RoboJackets/robowrestling/500g/NewMemberBoard/Renders/render_front.jpg

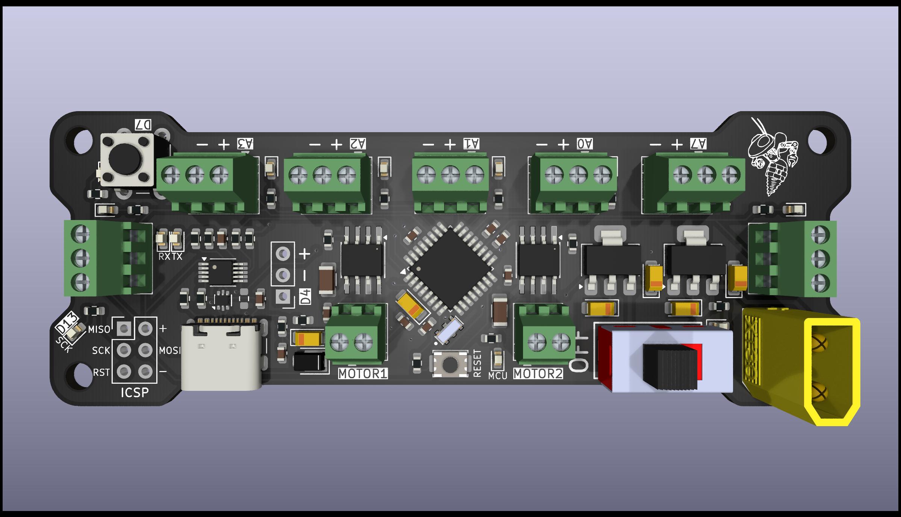
500g/NewMemberBoard/Renders/render_front.jpg
