RoboJackets/robowrestling/500g/NewMemberBoard/Renders/render_orthographic_back.jpg

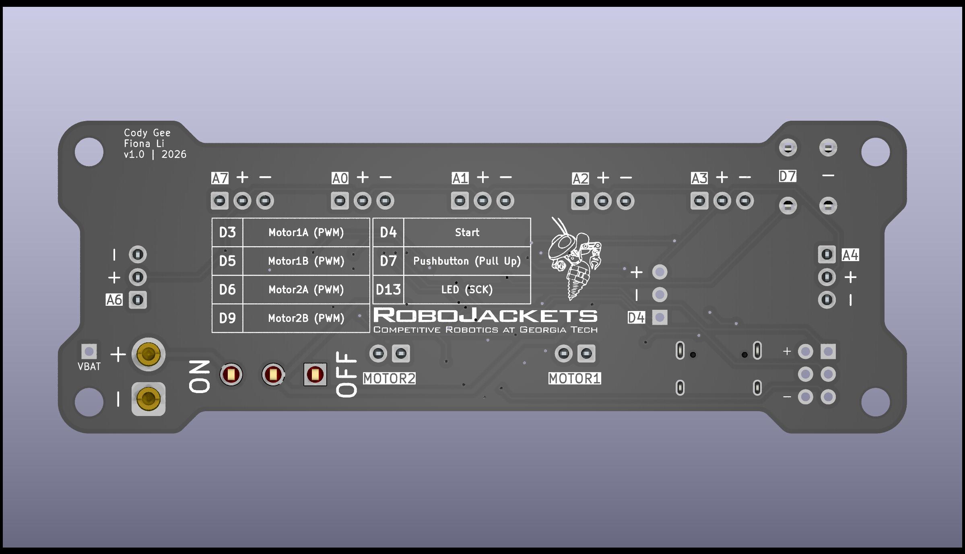
500g/NewMemberBoard/Renders/render_orthographic_back.jpg
