RoboJackets/robowrestling/500g/NewMemberBoard/Imported_Symbols_Footprints/xt30-male-connector-1.snapshot.5/XT30-M_m.ver.png

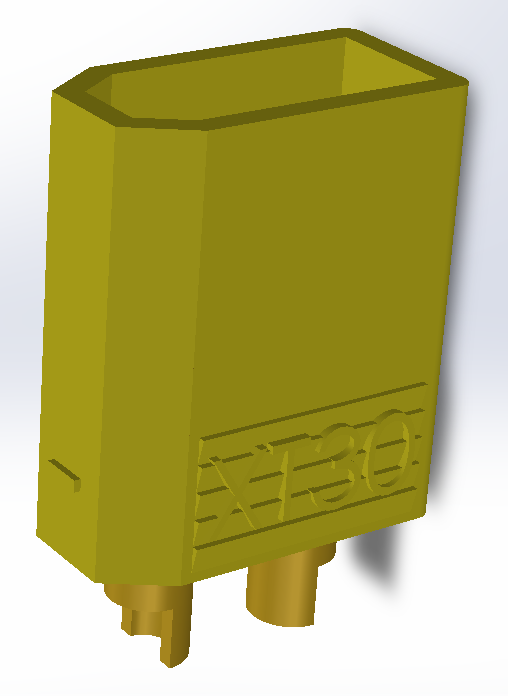
500g/NewMemberBoard/Imported_Symbols_Footprints/xt30-male-connector-1.snapshot.5/XT30-M_m.ver.png
