RoboJackets/robowrestling/500g/NewMemberBoard/Renders/render_orthographic_front.jpg

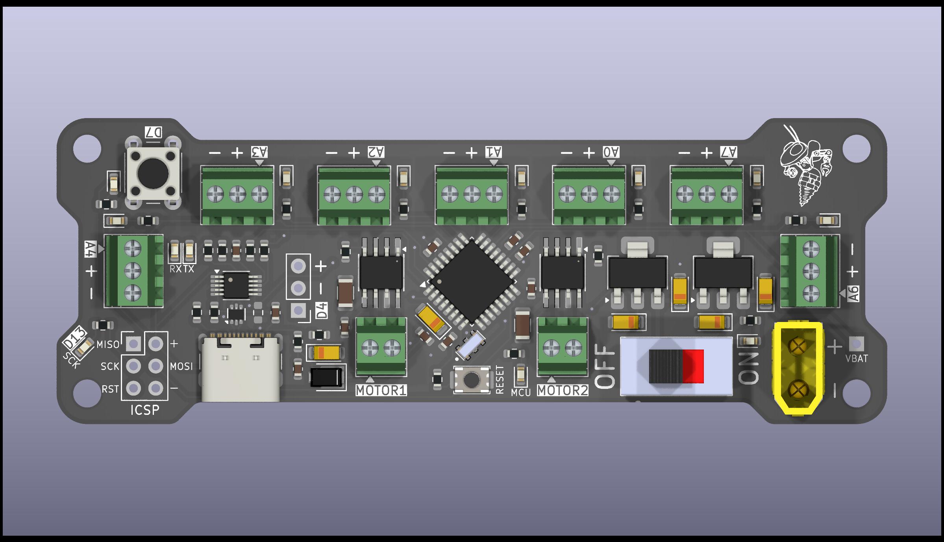
500g/NewMemberBoard/Renders/render_orthographic_front.jpg
