RoboJackets/robowrestling/3kg/Ferrarii/CustomML2/CustomML2.step

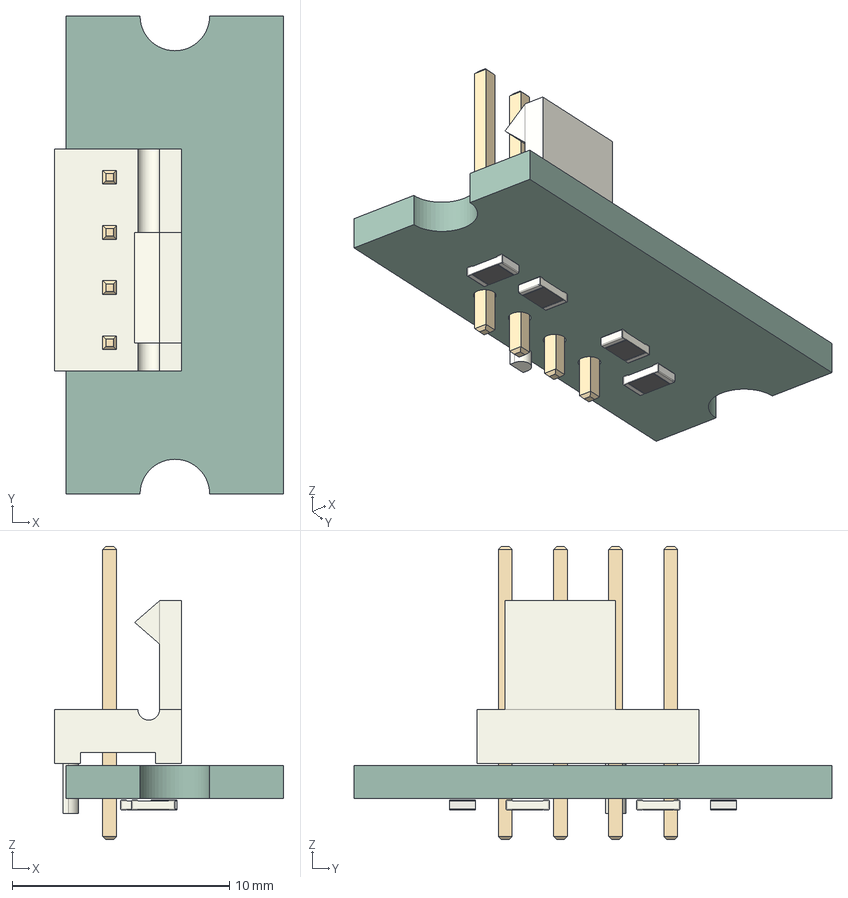
[picture p5: CAD file, 2025-07-22]
3kg/Ferrarii/CustomML2/CustomML2.step
10.5 x 22.0 x 13.5 mm
FanPinHeader_1x04_P2.54mm_Vertical
R_0805_2012Metric x 4
CustomML2_PCB
