RoboJackets/robowrestling/500g/NewMemberBoard/Imported_Symbols_Footprints/1101M2S3CQE2 (2)/1101M2S3CQE2.step

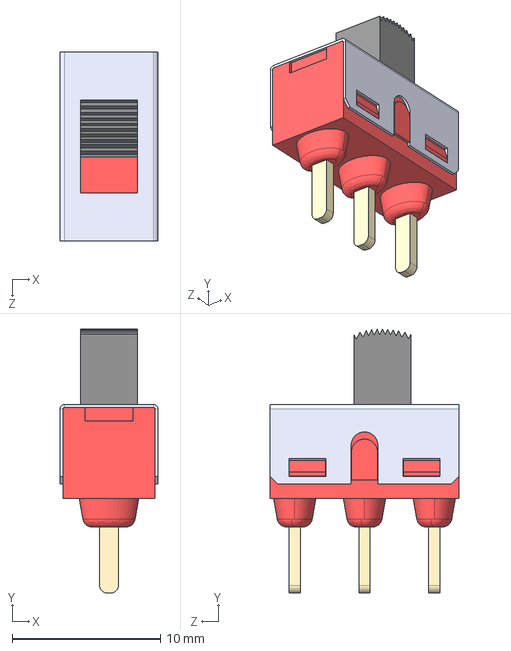
[picture p6: CAD file, 2025-10-02]
500g/NewMemberBoard/Imported_Symbols_Footprints/1101M2S3CQE2 (2)/1101M2S3CQE2.step
6.60 x 17.8 x 12.7 mm
