RoboJackets/robowrestling/500g/NewMemberBoard/Imported_Symbols_Footprints/CSTNE16M0V530000R0/CSTNE16M0V530000R0.step

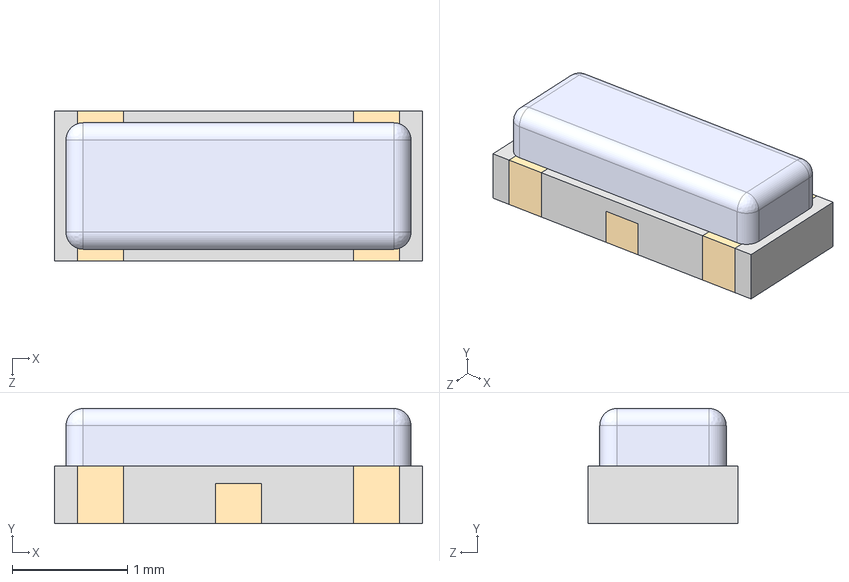
[picture p7: CAD file, 2026-07-23]
500g/NewMemberBoard/Imported_Symbols_Footprints/CSTNE16M0V530000R0/CSTNE16M0V530000R0.step
3.20 x 1.00 x 1.30 mm
