RoboJackets/robowrestling/500g/NewMemberBoard/Imported_Symbols_Footprints/LIB_SKRKAHE020/SKRKAHE020/3D/SKRKAHE020.stp

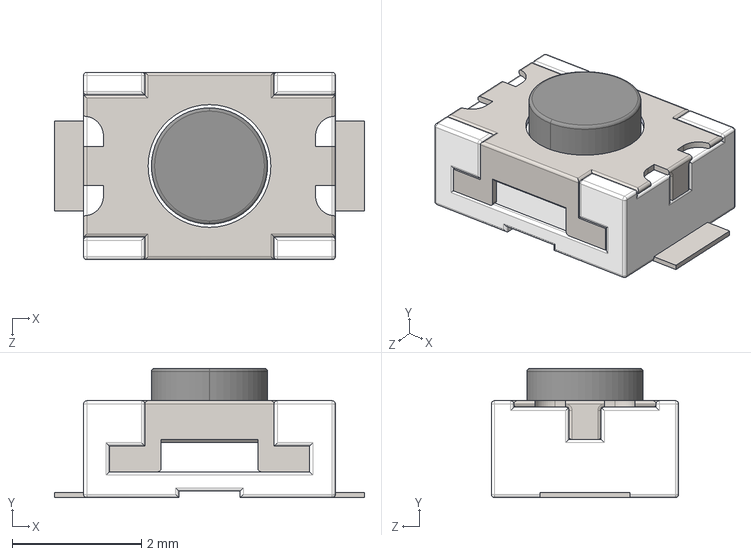
[picture p8: CAD file, 2026-07-23]
500g/NewMemberBoard/Imported_Symbols_Footprints/LIB_SKRKAHE020/SKRKAHE020/3D/SKRKAHE020.stp
4.80 x 2.00 x 2.90 mm
