RoboJackets/robowrestling/500g/NewMemberBoard/Imported_Symbols_Footprints/microstart-cad/microstart-cad.step

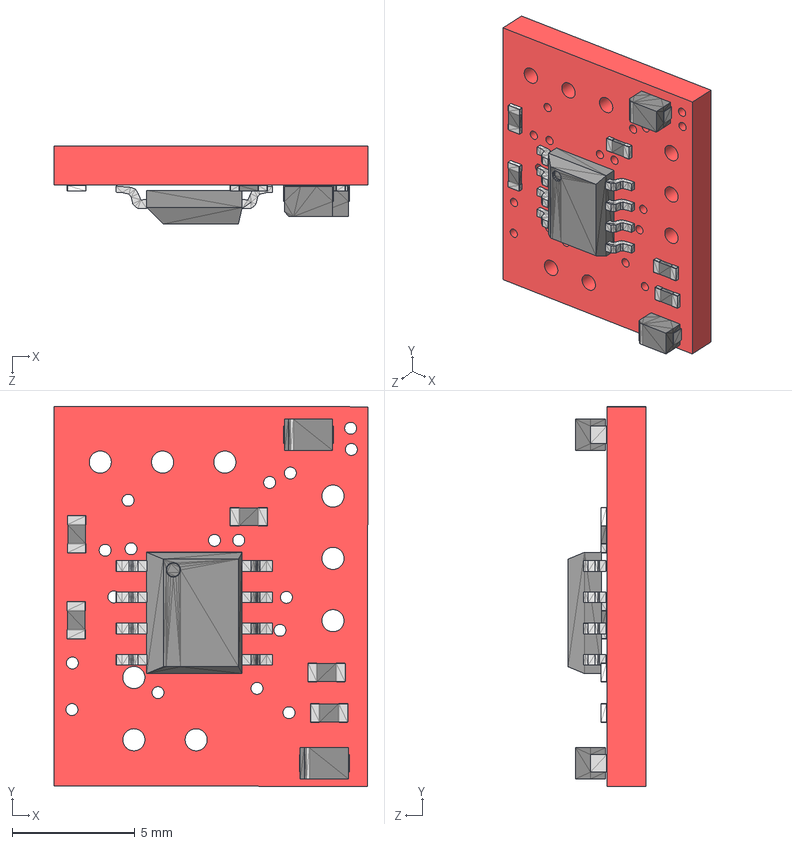
[picture p9: CAD file, 2026-07-23]
500g/NewMemberBoard/Imported_Symbols_Footprints/microstart-cad/microstart-cad.step
12.8 x 15.5 x 3.18 mm
Board
dio_0805 x 2
res_0603 x 5
soic-8_150mil
