RoboJackets/robowrestling/500g/NewMemberBoard/Imported_Symbols_Footprints/PTS_647_SK38/PTS 647 SK38 SMTR2 LFS--3DModel-STEP-269445.STEP

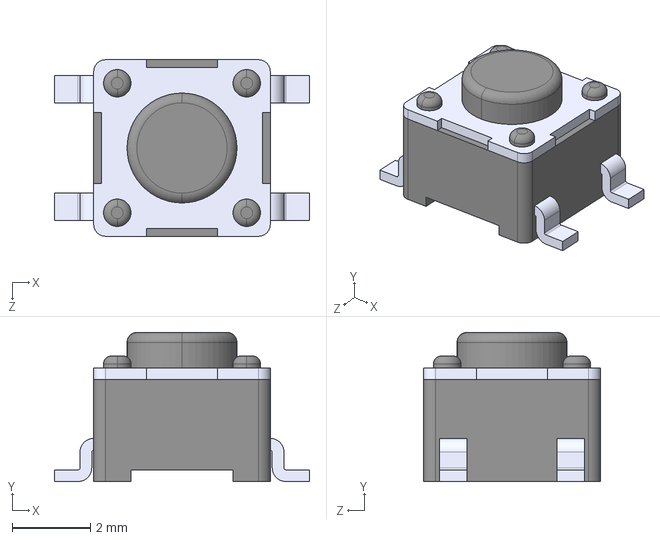
[picture p10: CAD file, 2026-07-23]
500g/NewMemberBoard/Imported_Symbols_Footprints/PTS_647_SK38/PTS 647 SK38 SMTR2 LFS--3DModel-STEP-269445.STEP
6.50 x 3.80 x 4.50 mm
