RoboJackets/robowrestling/500g/NewMemberBoard/Imported_Symbols_Footprints/xt30-male-connector-1.snapshot.5/XT30-M_m.ver.STEP

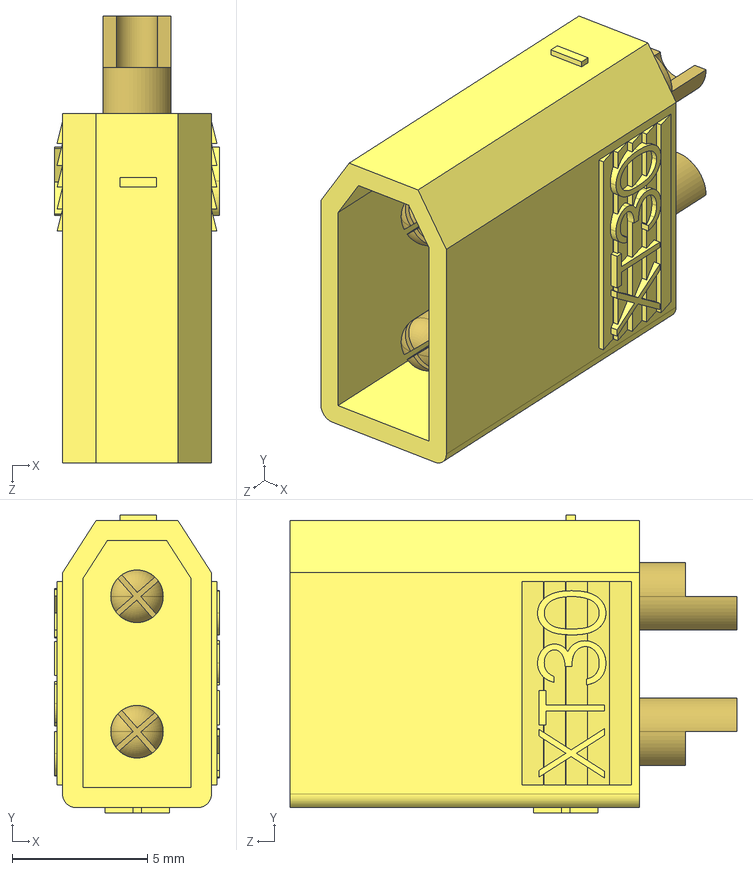
[picture p11: CAD file, 2026-07-23]
500g/NewMemberBoard/Imported_Symbols_Footprints/xt30-male-connector-1.snapshot.5/XT30-M_m.ver.STEP
6.10 x 11.0 x 16.5 mm
