RoboJackets/robowrestling/500g/Slippi/Symbols_Footprints/DRV8871DDAR/DRV8871DDAR.step

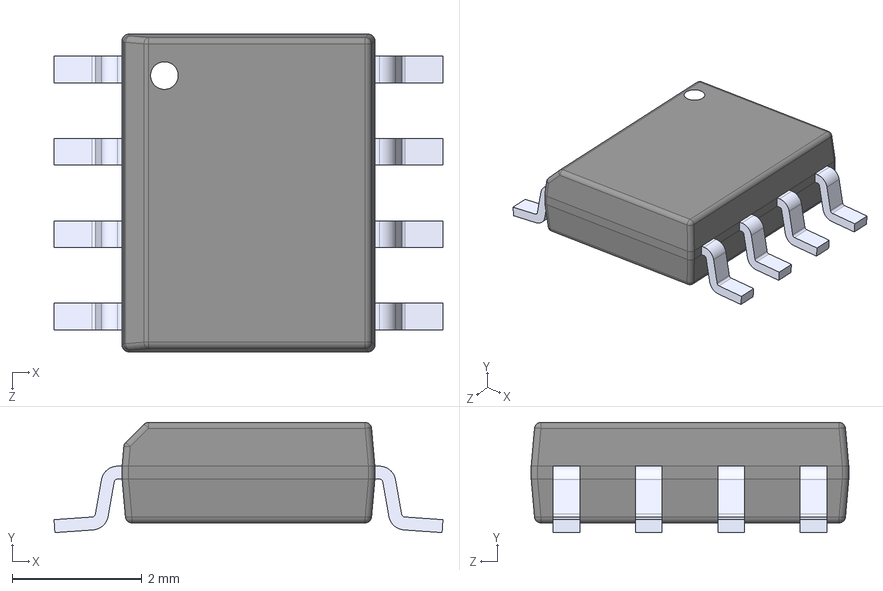
[picture p12: CAD file, 2025-10-02]
500g/Slippi/Symbols_Footprints/DRV8871DDAR/DRV8871DDAR.step
6.00 x 1.70 x 4.90 mm
