RoboJackets/robowrestling/500g/Slippi/Symbols_Footprints/L7805CV/L7805CV.step

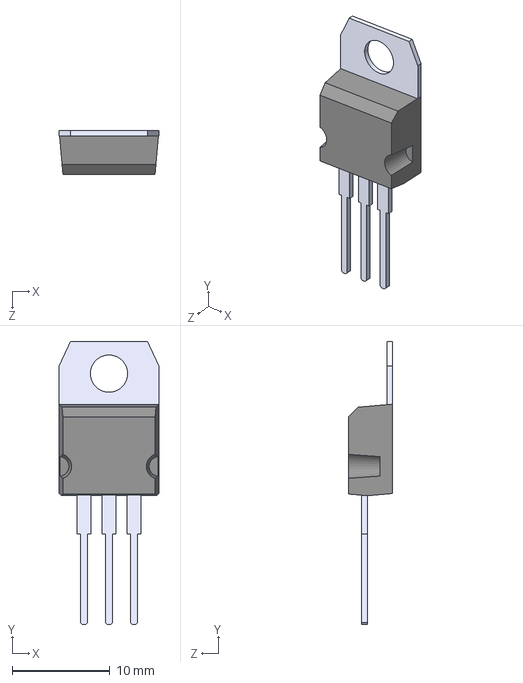
[picture p13: CAD file, 2025-10-02]
500g/Slippi/Symbols_Footprints/L7805CV/L7805CV.step
10.2 x 28.9 x 4.50 mm
