RoboJackets/robowrestling/ControlBoard/Timmi/0.1ufCap/CL05A104KA5NNNC.step

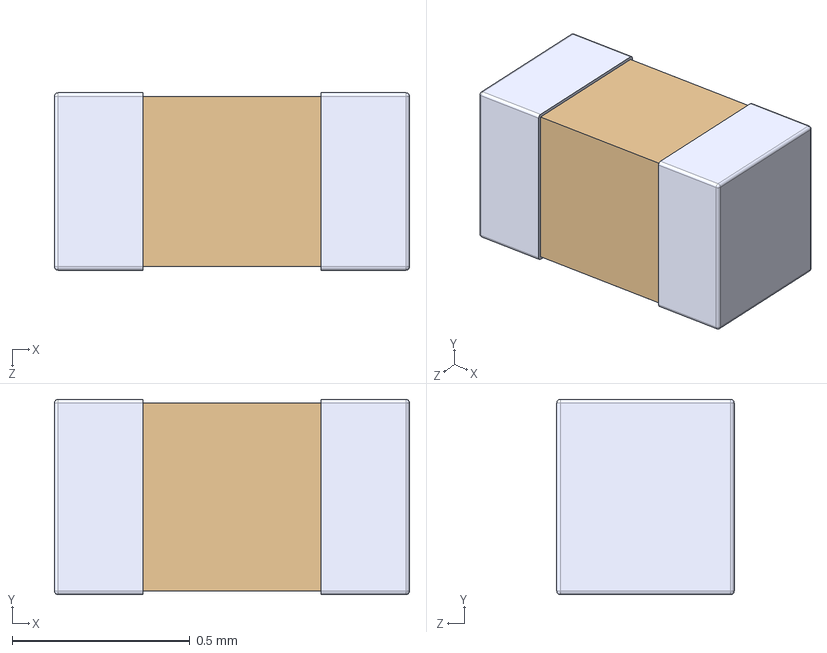
[picture p14: CAD file, 2024-02-18]
ControlBoard/Timmi/0.1ufCap/CL05A104KA5NNNC.step
1 x 0.55 x 0.5 mm
