RoboJackets/robowrestling/Skibidi/SkibidiCAD/Front Wedge.SLDPRT

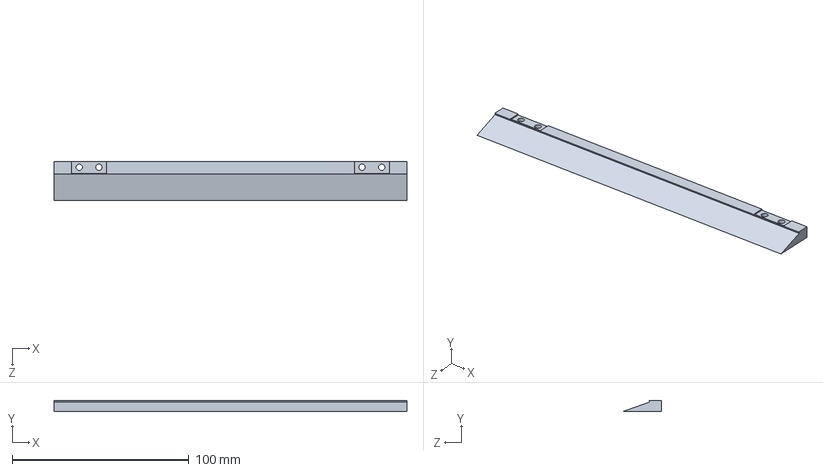
[picture p15: CAD file, 2024-06-07]
Skibidi/SkibidiCAD/Front Wedge.SLDPRT
200.0 x 6.35 x 21.9 mm
