RoboJackets/robowrestling/500g/NewMemberBoard/Imported_Symbols_Footprints/microstart-cad/microstart-cad-board-only.step

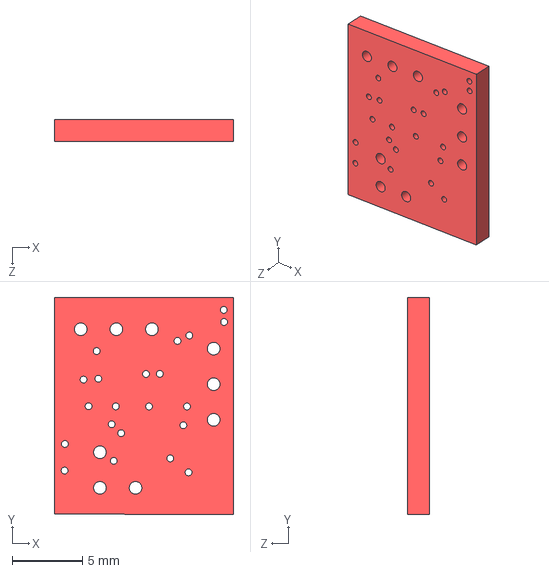
[picture p16: CAD file, 2026-07-23]
500g/NewMemberBoard/Imported_Symbols_Footprints/microstart-cad/microstart-cad-board-only.step
12.8 x 15.5 x 1.60 mm
