RoboJackets/robowrestling/Skibidi/SkibidiCAD/1603A2_Surface-Mount Hinge with Holes.SLDPRT

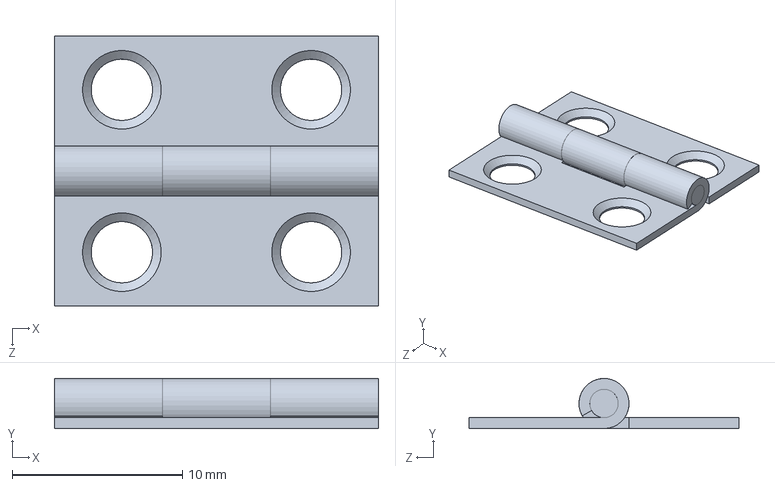
[picture p17: CAD file, 2024-06-07]
Skibidi/SkibidiCAD/1603A2_Surface-Mount Hinge with Holes.SLDPRT
19.1 x 2.95 x 15.9 mm
