RoboJackets/robowrestling/Skibidi/SkibidiCAD/Blade.SLDPRT

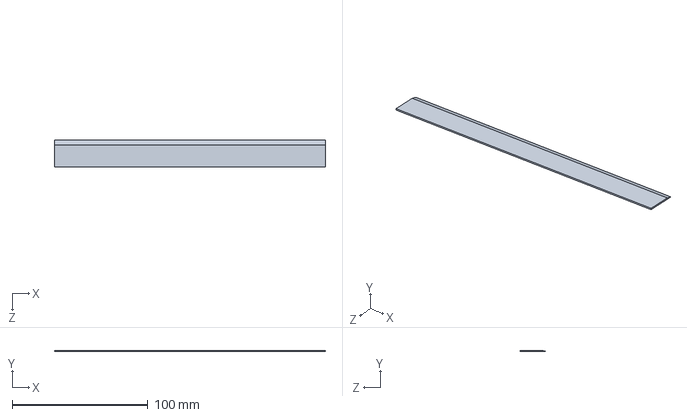
[picture p18: CAD file, 2024-06-07]
Skibidi/SkibidiCAD/Blade.SLDPRT
200.0 x 1.00 x 20.0 mm
