RoboJackets/robowrestling/Skibidi/SkibidiCAD/Base Plate.SLDPRT

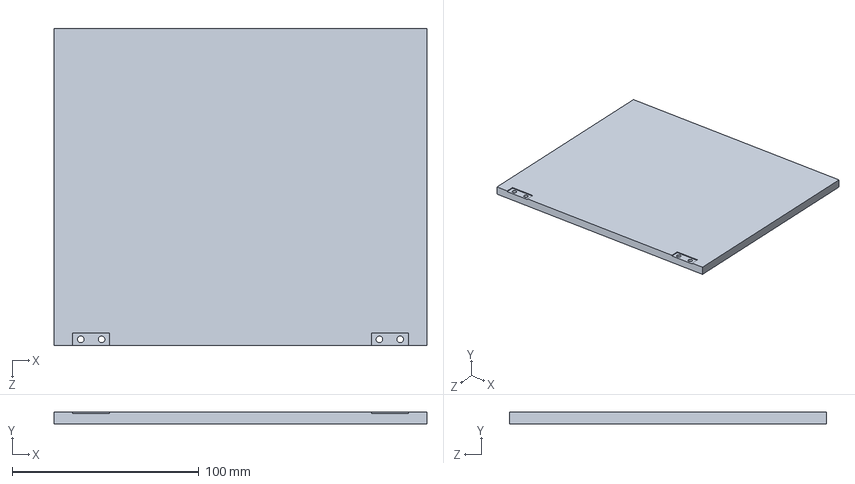
[picture p19: CAD file, 2024-06-07]
Skibidi/SkibidiCAD/Base Plate.SLDPRT
200.0 x 6.35 x 170.0 mm
