RoboJackets/robowrestling/500g/NewMemberBoard/Imported_Symbols_Footprints/691210910002/691210910002.step

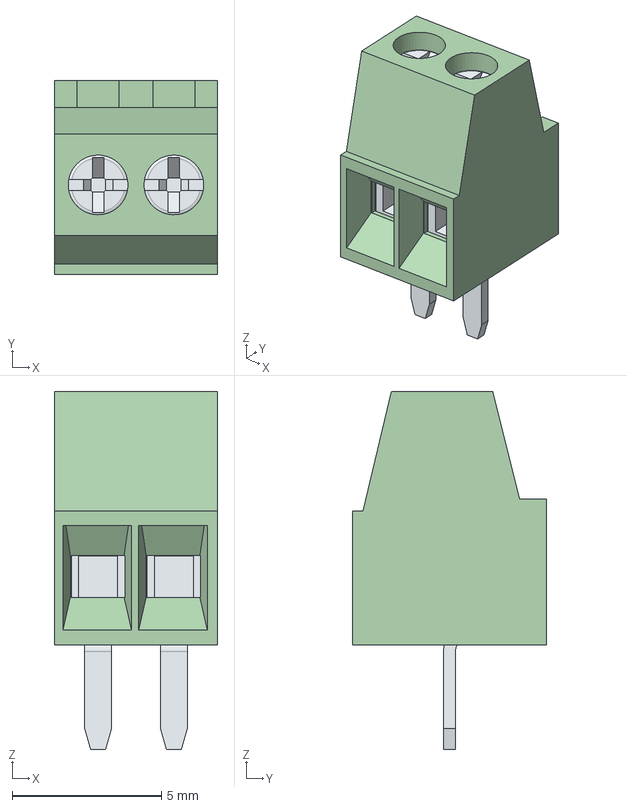
[picture p20: CAD file, 2026-07-23]
500g/NewMemberBoard/Imported_Symbols_Footprints/691210910002/691210910002.step
5.48 x 6.50 x 12.0 mm
6912109100xx_CAGE x 2
6912109100xx_PIN x 2
6912109100xx_VIS x 2
