RoboJackets/robowrestling/500g/NewMemberBoard/Imported_Symbols_Footprints/LIB_691210910003/691210910003/3D/691210910003.stp

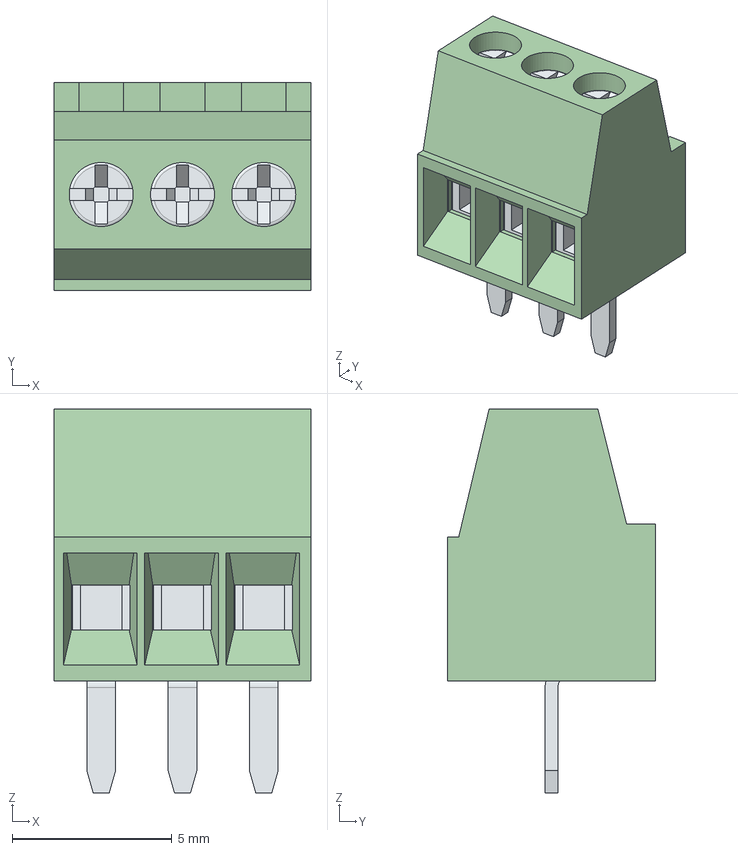
[picture p21: CAD file, 2026-07-23]
500g/NewMemberBoard/Imported_Symbols_Footprints/LIB_691210910003/691210910003/3D/691210910003.stp
8.02 x 6.50 x 12.0 mm
6912109100xx_CAGE x 3
6912109100xx_PIN x 3
6912109100xx_VIS x 3
