RoboJackets/robowrestling/Skibidi/SkibidiCAD/Skwibidi.SLDASM

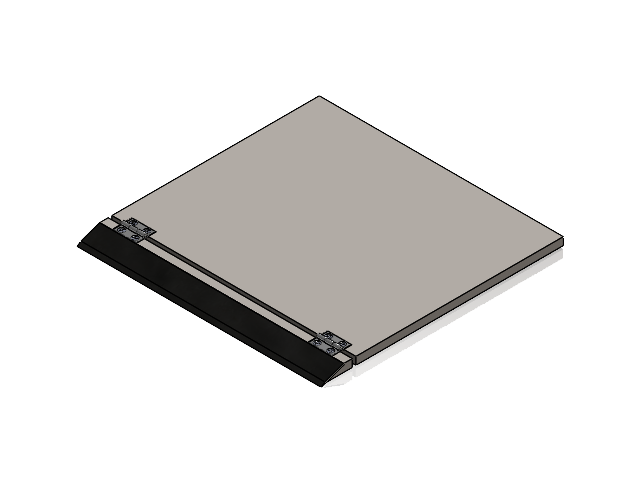
[picture p22: CAD file, 2024-06-07]
Skibidi/SkibidiCAD/Skwibidi.SLDASM
97258A122_18-8 Stainless Steel Thin Square Nut x 8
91420A016_Steel Phillips Flat Head Screws x 8
Base Plate
Front Wedge
1603A2_Surface-Mount Hinge with Holes x 2
Blade
