RoboJackets/robowrestling/(list of files, cad)

Other CAD files:
500g/NewMemberBoard/Imported_Symbols_Footprints/LIB_691210910003/691210910003/Allegro/691210910003.psm
500g/NewMemberBoard/Imported_Symbols_Footprints/LIB_691210910003/691210910003/DEHDL/691210910003/chips/chips.prt
500g/NewMemberBoard/Imported_Symbols_Footprints/LIB_SKRKAHE020/SKRKAHE020/Allegro/skrkaee020.psm
500g/NewMemberBoard/Imported_Symbols_Footprints/LIB_SKRKAHE020/SKRKAHE020/DEHDL/skrkahe020/chips/chips.prt
500g/NewMemberBoard/Imported_Symbols_Footprints/xt30-male-connector-1.snapshot.5/XT30-M_m.ver.SLDPRT
ControlBoard/Timmi/m8Conn footprint/T4040034041-000.step
ControlBoard/Timmi/sm symbol/75869-130LF.step
Skibidi/SkibidiCAD/91420A016_Steel Phillips Flat Head Screws.SLDPRT
Skibidi/SkibidiCAD/97258A122_18-8 Stainless Steel Thin Square Nut.SLDPRT
