RoboJackets/robowrestling/(threads)

Thread 2 (2019-12-08):

Make it easier to reset start module/teensy

JoshOldenburg, 2019-12-08:
Ideas:
- Add an XBee or similar for wireless debugging and estop
- Make the start module resettable by the teensy (i.e., make its power supply controllable)

Closed 2023-02-08.

Thread 3 (2019-12-15):

IMU address line and interrupt pin have no level shifting

JoshOldenburg, 2019-12-15:
Address line can be tied to ground. Interrupt pin should be shifted. Also, consider moving to a different IMU (one with an impact interrupt) or use a breakout board for the current one.

Closed 2023-02-08.

Thread 4 (2019-12-15):

Use hall effect current sensors

JoshOldenburg, 2019-12-15:
Use hall effect sensors or something entirely isolated as Guccii v2 and Kirbi v1 have issues with inductive spikes killing the current sense amplifiers.

JoshOldenburg, 2020-01-10:
Per the discussion in person, we may not need to bother with current sensing at all since matches end pretty much as soon as it stalls.

Closed 2023-02-08.

Thread 6 (2019-12-15):

Break out Teensy program mode button, if possible

JoshOldenburg, 2019-12-15:
Also, break out its reset line.

Thread 7 (2019-12-15):

Use proper power supply management for removing power supply conflicts

JoshOldenburg, 2019-12-15:
Currently the ESC power supplies are in parallel, as is the USB power supply, if present. These should be merged with an OR-ing controller or similar to keep the redundancy.

Thread 8 (2019-12-15):

Consider moving to the Teensy 3.5

JoshOldenburg, 2019-12-15:
That potentially allows us to skip some level shifting and avoid damages from voltage spikes.

Thread 11 (2019-12-19):

Japan Competition Notes 2019

renawrli, 2019-12-19:
STOP:
    - using IMU and encoders, matches are too straightforward and fast to for them to be useful

CONTINUE:
    - lmao

START:
    - read ALL the rules again each year :'(
    - smaller batteries - less capacity/fewer cells to save space and weight
    - be careful with sensor placement (orientation, size & shape of cutouts)

Possible changes:
    - go dumber on the code, logic can be even simplier
    - move side plates under the plow so opponents can ride further up the plow
    - more patient/'twichy' code, spinning to search is too risky
    - possibly close the angle to see opponents that are farther away without blind spots
    - current sensing may not be necessary - smoking robot usually ends the match
        - 40A fuse seems fine :P

Things to research:
    - calculate force needed to scoop up an opposing robot
        - is our magnet force too much? or more strategic magnet placement.
        - Guccii got scooped twice. Only once resulted in being pushed out
    - calculate/find optimal magnet placement (Juan/Logan)
    - calculate momentum transfer necessary to throw a robot off the field (Juan)
    - distance sensors: narrow w/ higher precision VS wider w/ less precision
    - make robot flush with ground using a piece of plastic(?)
    - sumozade's magnets touch the ground. weaker magnets (Juan)
    - wider angle distance sensors for the sides
    - use all digital sensors? just more of them?

Comments:
    - "code is acceptable, iterate based on sensor setup and stragety" - Logan
    - Guccii's plow is bad bc opponents can get caught on it - romania team
    - aren't our TOF on Guccii slow? - romania team

Misc:
    - no more 5 second delay
    - if plow chips, you get DQ'd for the match
    - invited to tournamet in Colombia in April 2020
    - got business card from Higher Institute of Technology in Egypt, give to Dr. C ?

What happened:
    - did not test that code produced expected behavior (5 second delay was present in the code but not in the rules)
    - both bots just got scooped by the opponent's plow
        - need to make the plow more flush with the ground
        - magnets on the plow, but w/o scrapping the field somehow
    - line sensor macros were okay for the orange/brown line
    - Kirbi scratched the field (protruding screw on magnet)
    - distance sensors were kind of narrow & blind spots at a distance, Guccii didn't see the opponent immeidately and
        we got pushed out while we searched

Closed 2023-02-08.

Thread 28 (2023-02-08):

Debug/Fix Kirbi v2 Control Board

alexxpeng, 2023-02-08:
Muxes are all shorted, see if board is salvageable

Closed 2023-12-14.

Thread 29 (2023-02-08):

Redesign Radio Board

alexxpeng, 2023-02-08:
Fix stuff (Rhea has list of stuff to fix)

Closed 2023-12-14.
