RoboJackets/robowrestling/(list of files, drawings)

Other design files:
500g/NewMemberBoard/Imported_Symbols_Footprints/LIB_691210910003/691210910003/Altium/691210910003.PcbLib
500g/NewMemberBoard/Imported_Symbols_Footprints/LIB_691210910003/691210910003/Altium/691210910003.SchLib
ControlBoard/Timmi/rj_loadswitch_sim.ms14
ControlBoard/Timmi/simulations/powerswitch.ms14
