RoboJackets/robowrestling/500g/NewMemberBoard/500gNewMemberBoard.kicad_pcb

## KiCad design 500g/NewMemberBoard/500gNewMemberBoard.kicad_pcb (2026-07-30)

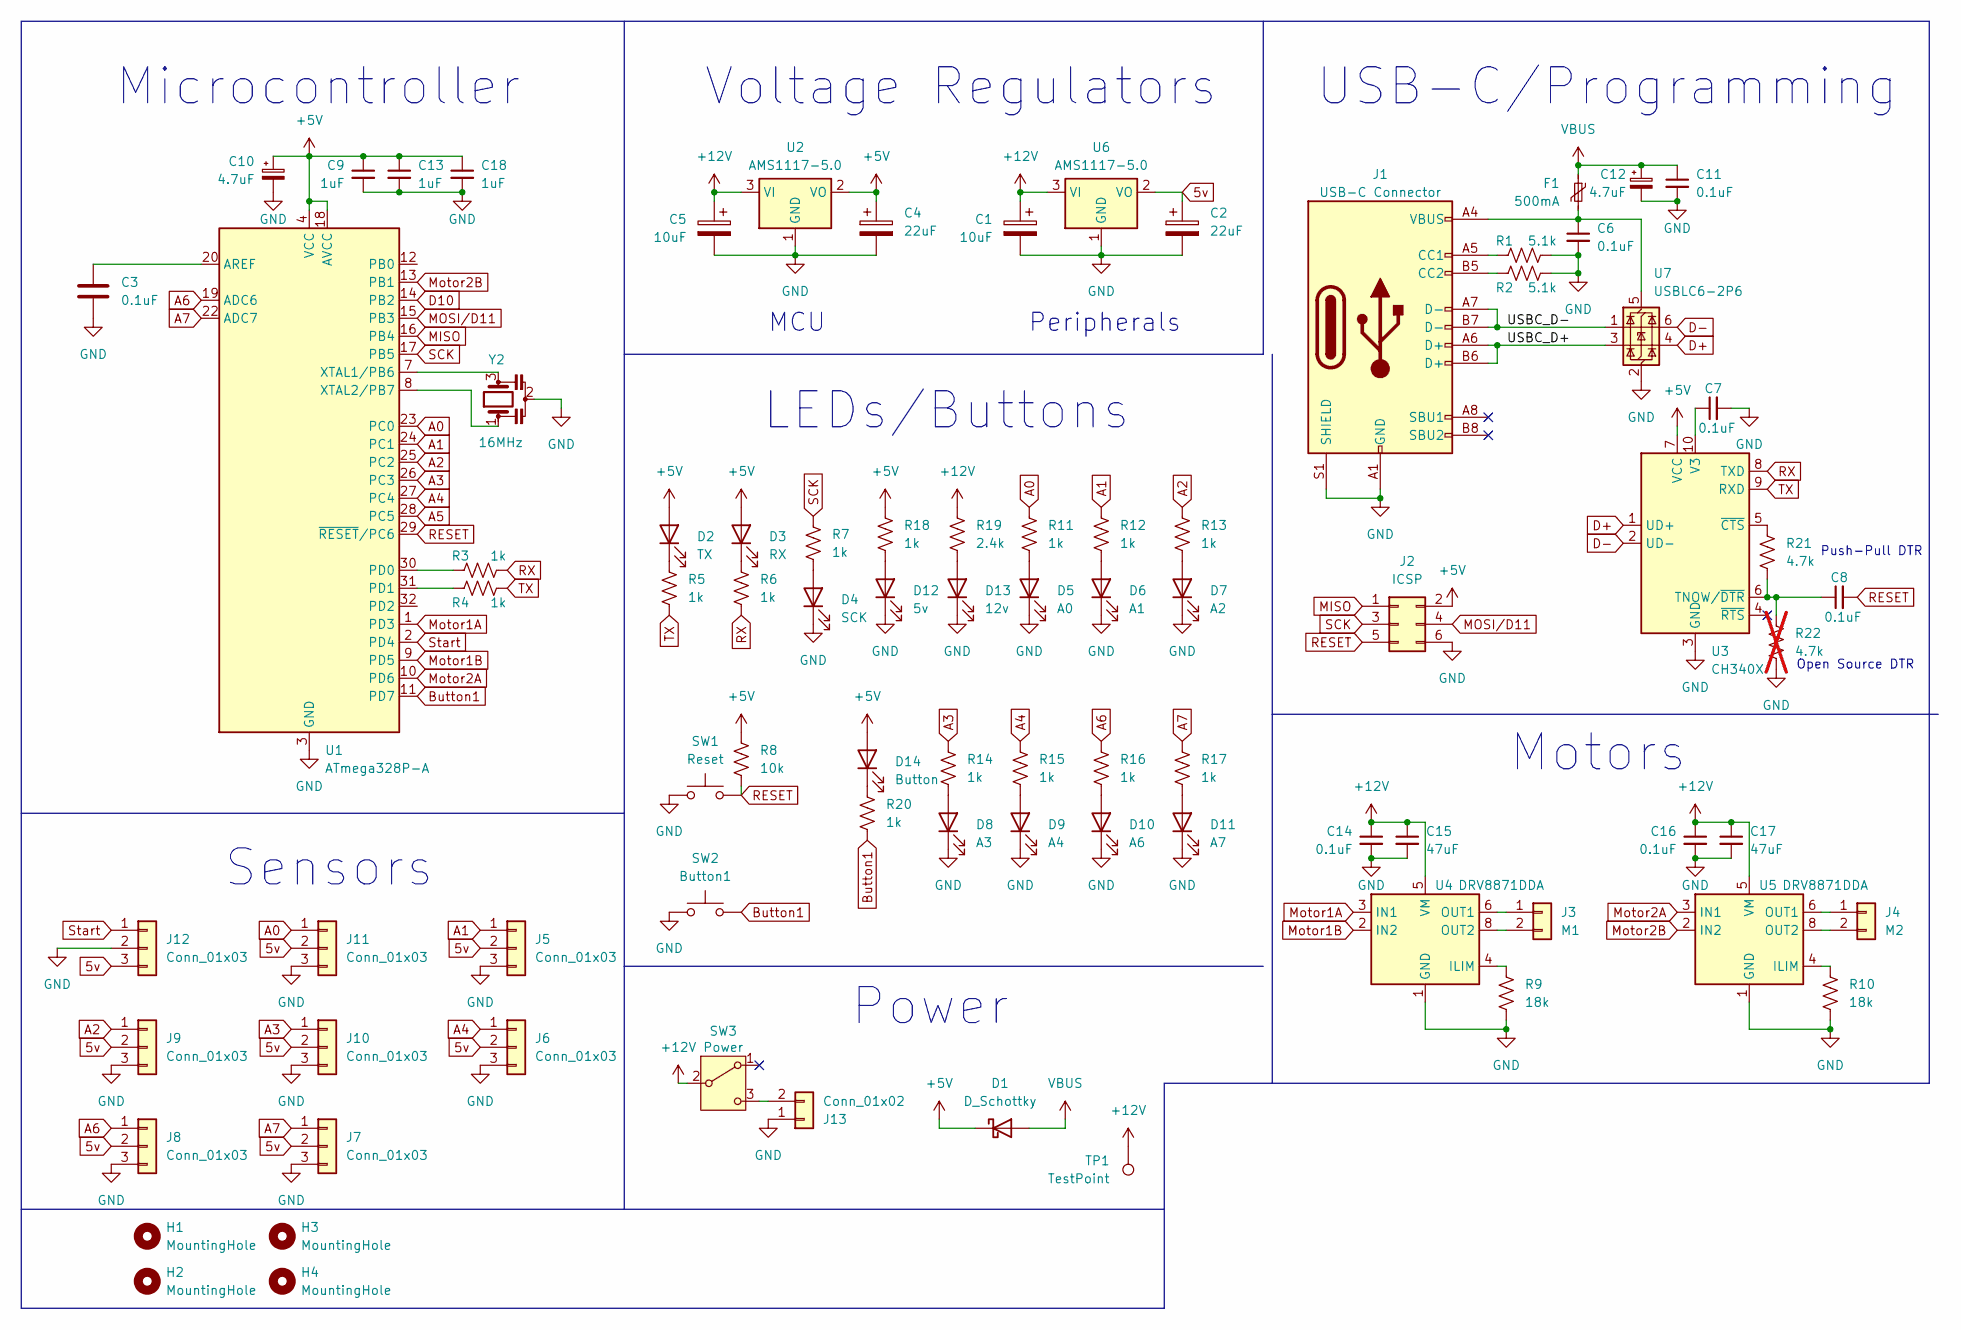
[picture p23: schematic 500gNewMemberBoard.kicad_sch]

Parts:
C1, C5: 10uF; CP_EIA-3216-18_Kemet-A
C2, C4: 22uF; CP_EIA-3216-18_Kemet-A
C3, C6, C7, C8, C11, C14, C16: 0.1uF; C_0603_1608Metric
C9, C13, C18: 1uF; C_0603_1608Metric
C10, C12: 4.7uF; CP_EIA-3216-18_Kemet-A
C15, C17: 47uF; C_1206_3216Metric
D1: D_Schottky; D_SMP_DO-220AA
D2: TX; LED_0603_1608Metric
D3: RX; LED_0603_1608Metric
D4: SCK; LED_0603_1608Metric
D5: A0; LED_0603_1608Metric
D6: A1; LED_0603_1608Metric
D7: A2; LED_0603_1608Metric
D8: A3; LED_0603_1608Metric
D9: A4; LED_0603_1608Metric
D10: A6; LED_0603_1608Metric
D11: A7; LED_0603_1608Metric
D12: 5v; LED_0603_1608Metric
D13: 12v; LED_0603_1608Metric
D14: Button; LED_0603_1608Metric
F1: 500mA; Fuse_0603_1608Metric
H1, H2, H3, H4: MountingHole; MountingHole_3.2mm_M3
J1: USB-C Connector; USB_C_Receptacle_GCT_USB4105-xx-A_16P_TopMnt_Horizontal
J2: ICSP; PinHeader_2x03_P2.54mm_Vertical
J3: M1; TerminalBlock_Xinya_XY308-2.54-2P_1x02_P2.54mm_Horizontal
J4: M2; TerminalBlock_Xinya_XY308-2.54-2P_1x02_P2.54mm_Horizontal
J5, J6, J7, J8, J9, J10, J11: Conn_01x03; TerminalBlock_Xinya_XY308-2.54-3P_1x03_P2.54mm_Horizontal
J12: Conn_01x03; PinHeader_1x03_P2.54mm_Vertical
J13: Conn_01x02; AMASS_XT30U-M_1x02_P5.0mm_Vertical
R1, R2: 5.1k; R_0603_1608Metric
R3, R4, R5, R6, R7, R11, R12, R13, R14, R15, R16, R17, R18, R20: 1k; R_0603_1608Metric
R8: 10k; R_0603_1608Metric
R9, R10: 18k; R_0603_1608Metric
R19: 2.4k; R_0603_1608Metric
R21: 4.7k; R_0603_1608Metric
R22: 4.7k; R_0603_1608Metric; not fitted
SW1: Reset; SW_Push_SPST_NO_Alps_SKRK
SW2: Button1; SW_PUSH_6mm
SW3: Power; SW_1101M2S3CQE2
TP1: TestPoint; 0.5mm_drill_0.85_0.85mm_test_point
U1: ATmega328P-A; TQFP-32_7x7mm_P0.8mm
U2, U6: AMS1117-5.0; SOT-223-3_TabPin2
U3: CH340X; MSOP-10_3x3mm_P0.5mm
U4, U5: DRV8871DDA; Texas_HTSOP-8-1EP_3.9x4.9mm_P1.27mm_EP2.95x4.9mm_Mask2.4x3.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
U7: USBLC6-2P6; SOT-666
Y2: 16MHz; OSC_CSTNE16M0V530000R0

Connections:
5v: C2.1, J5.2, J6.2, J7.2, J8.2, J9.2, J10.2, J11.2, J12.3, U6.2 (VO)
+5V: C4.1, C9.1, C10.1, C13.1, C18.1, D1.1 (K), D2.2 (A), D3.2 (A), D14.2 (A), J2.2, R8.1, R18.1, U1.4 (VCC), U1.6 (VCC), U1.18 (AVCC), U2.2 (VO), U3.7 (VCC)
+12V: C1.1, C5.1, C14.1, C15.1, C16.1, C17.1, R19.1, SW3.2 (B), TP1.1, U2.3 (VI), U4.5 (VM), U5.5 (VM), U6.3 (VI)
/USBC_D+: J1.A6 (D+), J1.B6 (D+), U7.3 (I/O2)
/USBC_D-: J1.A7 (D-), J1.B7 (D-), U7.1 (I/O1)
A0: J11.1, R11.1, U1.23 (PC0)
A1: J5.1, R12.1, U1.24 (PC1)
A2: J9.1, R13.1, U1.25 (PC2)
A3: J10.1, R14.1, U1.26 (PC3)
A4: J6.1, R15.1, U1.27 (PC4)
A5: U1.28 (PC5)
A6: J8.1, R16.1, U1.19 (ADC6)
A7: J7.1, R17.1, U1.22 (ADC7)
Button1: R20.2, SW2.2, U1.11 (PD7)
D10: U1.14 (PB2)
D+: U3.1 (UD+), U7.4 (I/O2)
D-: U3.2 (UD-), U7.6 (I/O1)
GND: C1.2, C2.2, C3.2, C4.2, C5.2, C6.2, C7.2, C9.2, C10.2, C11.2, C12.2, C13.2, C14.2, C15.2, C16.2, C17.2, C18.2, D4.1 (K), D5.1 (K), D6.1 (K), D7.1 (K), D8.1 (K), D9.1 (K), D10.1 (K), D11.1 (K), D12.1 (K), D13.1 (K), J1.A1 (GND), J1.A12 (GND), J1.B1 (GND), J1.B12 (GND), J1.S1 (SHIELD), J2.6, J5.3, J6.3, J7.3, J8.3, J9.3, J10.3, J11.3, J12.2, J13.1, R1.2, R2.2, R9.2, R10.2, R22.2, SW1.1, SW2.1, U1.3 (GND), U1.5 (GND), U1.21 (GND), U2.1 (GND), U3.3 (GND), U4.1 (GND), U4.7 (GND), U4.9 (GND), U5.1 (GND), U5.7 (GND), U5.9 (GND), U6.1 (GND), U7.2 (GND), Y2.2
MISO: J2.1, U1.16 (PB4)
MOSI/D11: J2.4, U1.15 (PB3)
Motor1A: U1.1 (PD3), U4.3 (IN1)
Motor1B: U1.9 (PD5), U4.2 (IN2)
Motor2A: U1.10 (PD6), U5.3 (IN1)
Motor2B: U1.13 (PB1), U5.2 (IN2)
unnamed: D2.1 (K), R5.1
unnamed: D3.1 (K), R6.1
unnamed: D4.2 (A), R7.2
unnamed: D5.2 (A), R11.2
unnamed: D6.2 (A), R12.2
unnamed: D7.2 (A), R13.2
unnamed: D8.2 (A), R14.2
unnamed: D9.2 (A), R15.2
unnamed: D10.2 (A), R16.2
unnamed: D11.2 (A), R17.2
unnamed: D12.2 (A), R18.2
unnamed: D13.2 (A), R19.2
unnamed: D14.1 (K), R20.1
unnamed: J1.A5 (CC1), R1.1
unnamed: J1.B5 (CC2), R2.1
unnamed: J3.1, U4.6 (OUT1)
unnamed: J3.2, U4.8 (OUT2)
unnamed: J4.1, U5.6 (OUT1)
unnamed: J4.2, U5.8 (OUT2)
unnamed: J13.2, SW3.3 (C)
unnamed: C3.1, U1.20 (AREF)
unnamed: R3.1, U1.30 (PD0)
unnamed: R4.1, U1.31 (PD1)
unnamed: U1.7 (XTAL1/PB6), Y2.3
unnamed: U1.8 (XTAL2/PB7), Y2.1
unnamed: C8.1, R21.2, R22.1, U3.6 (TNOW/~DTR)
unnamed: C7.1, U3.10 (V3)
unnamed: R21.1, U3.5 (~CTS)
unnamed: R9.1, U4.4 (ILIM)
unnamed: R10.1, U5.4 (ILIM)
unnamed: C6.1, F1.2, J1.A4 (VBUS), J1.A9 (VBUS), J1.B4 (VBUS), J1.B9 (VBUS), U7.5 (VBUS)
RESET: C8.2, J2.5, R8.2, SW1.2, U1.29 (~RESET/PC6)
RX: R3.2, R6.2, U3.8 (TXD)
SCK: J2.3, R7.1, U1.17 (PB5)
Start: J12.1, U1.2 (PD4)
TX: R4.2, R5.2, U3.9 (RXD)
VBUS: C11.1, C12.1, D1.2 (A), F1.1

Notes on the sheet:
Peripherals
Sensors
Power
Open Source DTR
Voltage Regulators
USB-C/Programming
Motors
Push-Pull DTR
LEDs/Buttons
Microcontroller
MCU

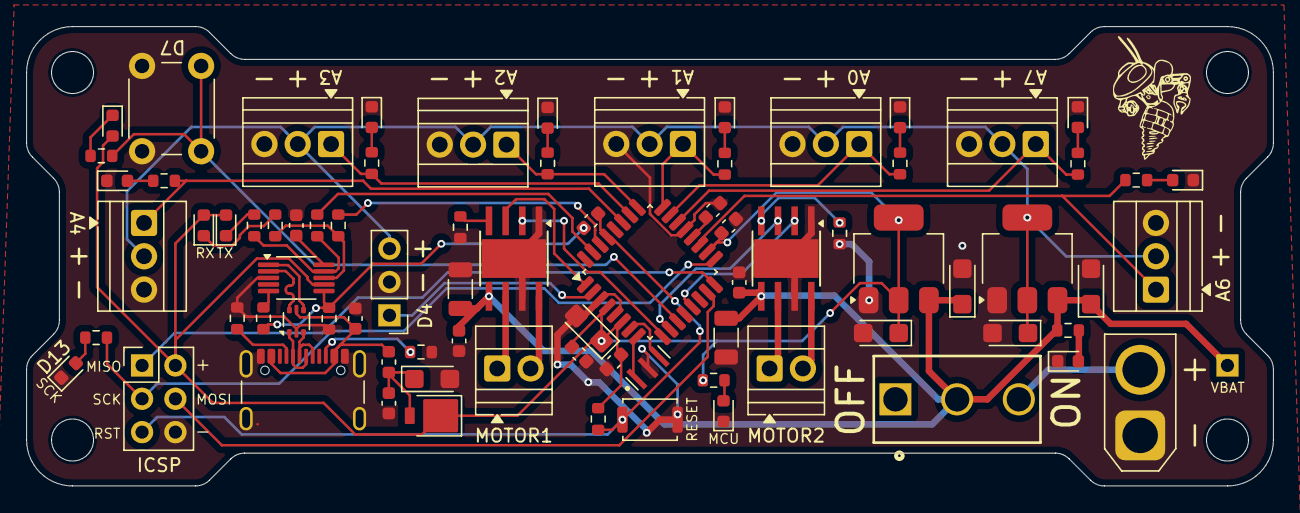
[picture p24: board 500gNewMemberBoard.kicad_pcb from above]

Board: 2 copper layers, 95.0 x 35.0 mm, 84 parts (0 on the bottom side), 59 nets.
