RoboJackets/robowrestling/500g/Slippi/Slippi.kicad_pcb

## KiCad design 500g/Slippi/Slippi.kicad_pcb (2025-10-02)

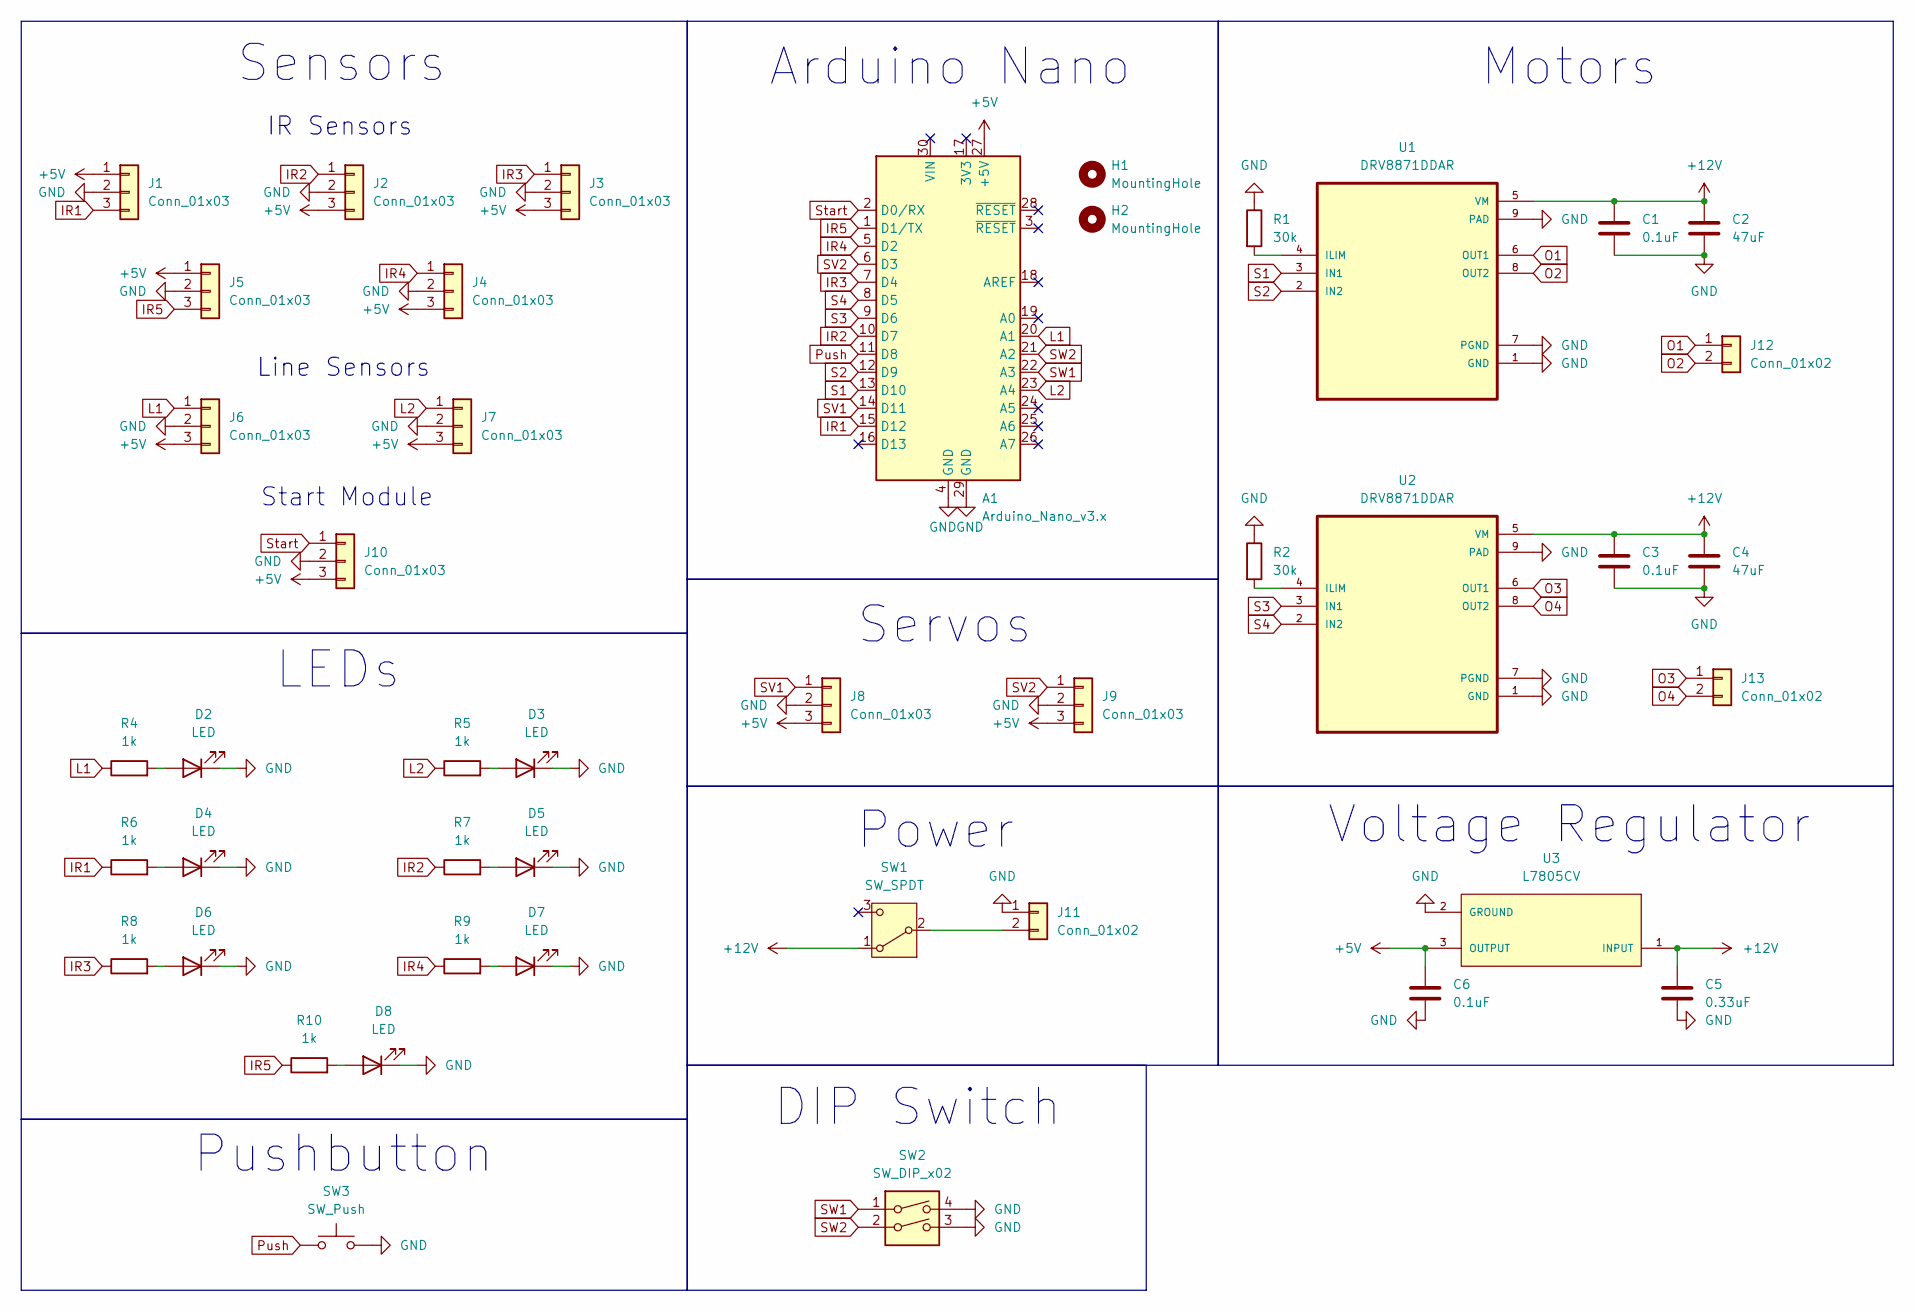
[picture p27: schematic Slippi.kicad_sch]

Parts:
A1: Arduino_Nano_v3.x; Arduino_Nano
C1, C3, C6: 0.1uF; C_0603_1608Metric
C2, C4: 47uF; C_0603_1608Metric
C5: 0.33uF; C_0603_1608Metric
D2, D3, D4, D5, D6, D7, D8: LED; LED_0603_1608Metric
H1, H2: MountingHole; MountingHole_2.7mm_M2.5
J1, J2, J3, J4, J5, J6, J7, J8, J9: Conn_01x03; TerminalBlock_Xinya_XY308-2.54-3P_1x03_P2.54mm_Horizontal
J10: Conn_01x03; PinHeader_1x03_P2.54mm_Vertical
J11: Conn_01x02; AMASS_XT30UPB-M_1x02_P5.0mm_Vertical
J12, J13: Conn_01x02; TerminalBlock_Xinya_XY308-2.54-2P_1x02_P2.54mm_Horizontal
R1, R2: 30k; R_0603_1608Metric
R4, R5, R6, R7, R8, R9, R10: 1k; R_0603_1608Metric
SW1: SW_SPDT; SW_1101M2S3CQE2
SW2: SW_DIP_x02; SW_DIP_SPSTx02_Slide_9.78x7.26mm_W7.62mm_P2.54mm
SW3: SW_Push; SW_PUSH_6mm
U1, U2: DRV8871DDAR; DRV8871
U3: L7805CV; TO255P1040X460X1968-3; PARTREV 36

Connections:
+5V: A1.27 (+5V), C6.1, J1.1, J2.3, J3.3, J4.3, J5.1, J6.3, J7.3, J8.3, J9.3, J10.3, U3.3 (OUTPUT)
+12V: C1.1, C2.1, C3.1, C4.1, C5.1, SW1.1 (A), U1.5 (VM), U2.5 (VM), U3.1 (INPUT)
GND: A1.4 (GND), A1.29 (GND), C1.2, C2.2, C3.2, C4.2, C5.2, C6.2, D2.1 (K), D3.1 (K), D4.1 (K), D5.1 (K), D6.1 (K), D7.1 (K), D8.1 (K), J1.2, J2.2, J3.2, J4.2, J5.2, J6.2, J7.2, J8.2, J9.2, J10.2, J11.1, R1.1, R2.1, SW2.3, SW2.4, SW3.2, U1.1 (GND), U1.7 (PGND), U1.9 (PAD), U2.1 (GND), U2.7 (PGND), U2.9 (PAD), U3.2 (GROUND)
IR1: A1.15 (D12), J1.3, R6.1
IR2: A1.10 (D7), J2.1, R7.1
IR3: A1.7 (D4), J3.1, R8.1
IR4: A1.5 (D2), J4.1, R9.1
IR5: A1.1 (D1/TX), J5.3, R10.1
L1: A1.20 (A1), J6.1, R4.1
L2: A1.23 (A4), J7.1, R5.1
unnamed: D2.2 (A), R4.2
unnamed: D3.2 (A), R5.2
unnamed: D4.2 (A), R6.2
unnamed: D5.2 (A), R7.2
unnamed: D6.2 (A), R8.2
unnamed: D7.2 (A), R9.2
unnamed: D8.2 (A), R10.2
unnamed: J11.2, SW1.2 (B)
unnamed: R1.2, U1.4 (ILIM)
unnamed: R2.2, U2.4 (ILIM)
O1: J12.1, U1.6 (OUT1)
O2: J12.2, U1.8 (OUT2)
O3: J13.1, U2.6 (OUT1)
O4: J13.2, U2.8 (OUT2)
Push: A1.11 (D8), SW3.1
S1: A1.13 (D10), U1.3 (IN1)
S2: A1.12 (D9), U1.2 (IN2)
S3: A1.9 (D6), U2.3 (IN1)
S4: A1.8 (D5), U2.2 (IN2)
SV1: A1.14 (D11), J8.1
SV2: A1.6 (D3), J9.1
SW1: A1.22 (A3), SW2.1
SW2: A1.21 (A2), SW2.2
Start: A1.2 (D0/RX), J10.1

Notes on the sheet:
Pushbutton
Power
Line Sensors
Arduino Nano
Servos
Motors
Sensors
IR Sensors
Voltage Regulator
DIP Switch
Start Module
LEDs

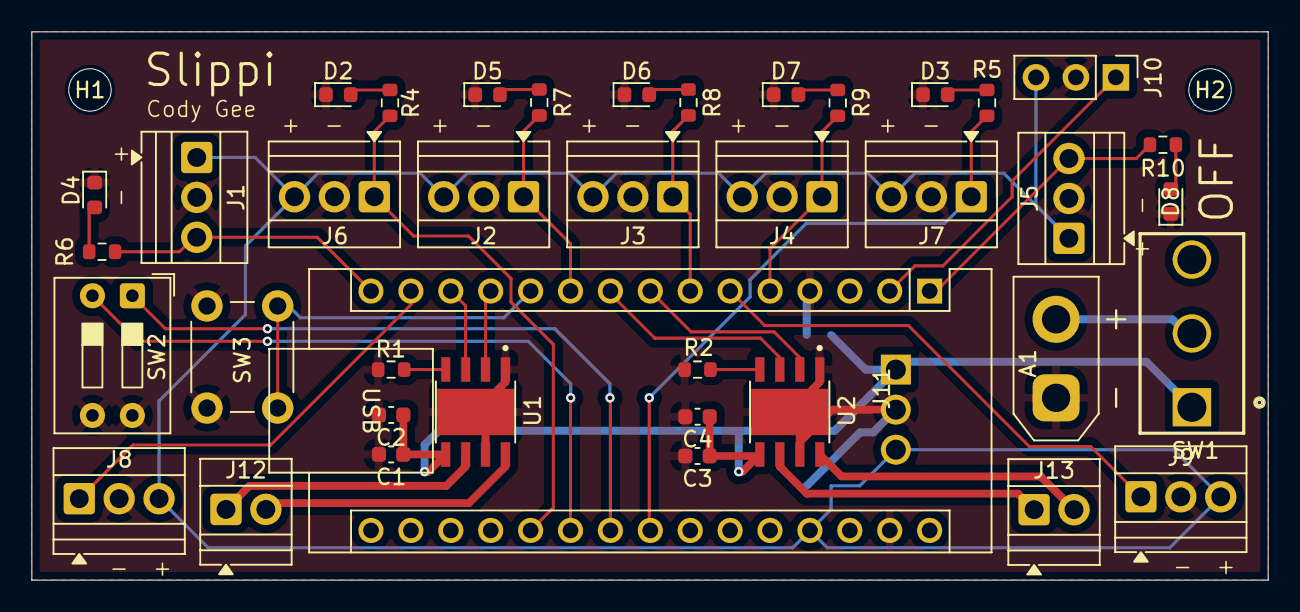
[picture p28: board Slippi.kicad_pcb from above]

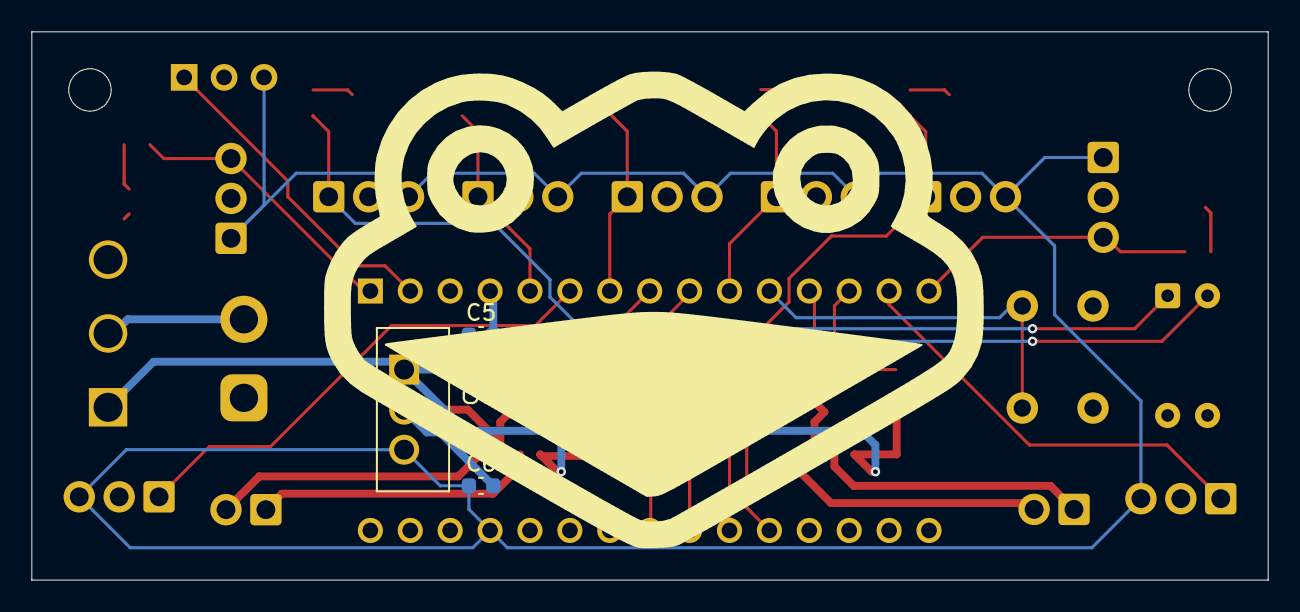
[picture p29: board Slippi.kicad_pcb from below]

Board: 2 copper layers, 78.7 x 34.9 mm, 44 parts (3 on the bottom side), 34 nets.
