RoboJackets/robowrestling/3kg/Ferrarii/CustomML2/CustomML2.kicad_pcb

## KiCad design 3kg/Ferrarii/CustomML2/CustomML2.kicad_pcb (2025-08-21)

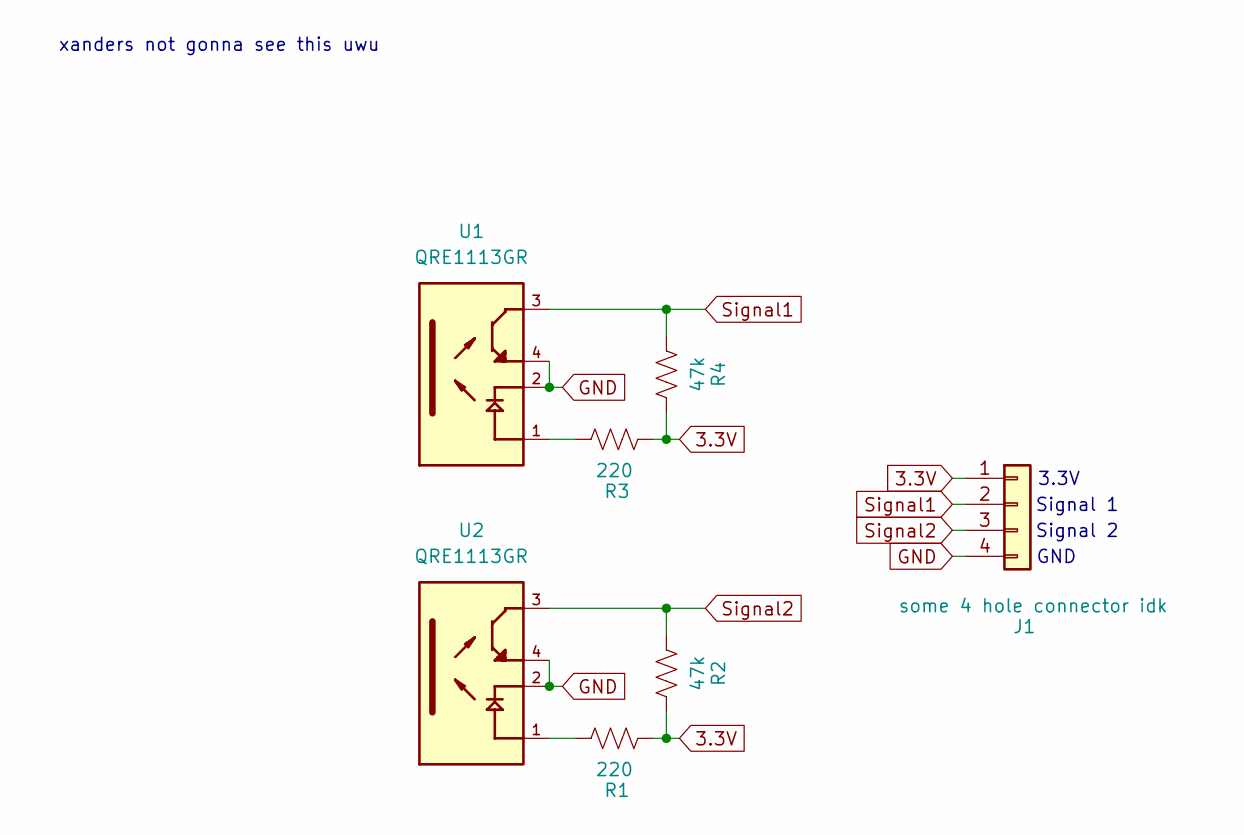
[picture p30: schematic CustomML2.kicad_sch]

Parts:
J1: some 4 hole connector idk; PinHeader_1x04_P2.54mm_Vertical
R1, R3: 220; R_0201_0603Metric_Pad0.64x0.40mm_HandSolder
R2, R4: 47k; R_0201_0603Metric_Pad0.64x0.40mm_HandSolder
U1, U2: QRE1113GR; SOIC180P460X187-4N; PARTREV 5

Connections:
3.3V: J1.1, R1.2, R2.2, R3.2, R4.2
GND: J1.4, U1.2, U1.4, U2.2, U2.4
unnamed: R1.1, U2.1
unnamed: R3.1, U1.1
Signal1: J1.2, R4.1, U1.3
Signal2: J1.3, R2.1, U2.3

Notes on the sheet:
GND
Signal 1
xanders not gonna see this uwu
Signal 2
3.3V

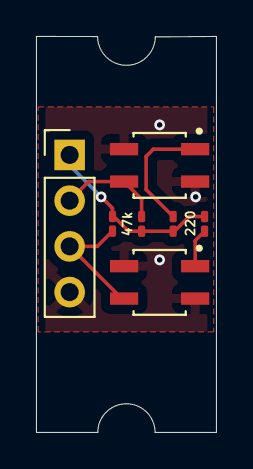
[picture p31: board CustomML2.kicad_pcb from above]

Board: 2 copper layers, 10.0 x 22.0 mm, 7 parts (0 on the bottom side), 6 nets.
