RoboJackets/robowrestling/500g/Rata2i2.0/pcbn't/Schematic/Schematic.kicad_pcb

## KiCad design 500g/Rata2i2.0/pcbn't/Schematic/Schematic.kicad_pcb (2025-07-17)

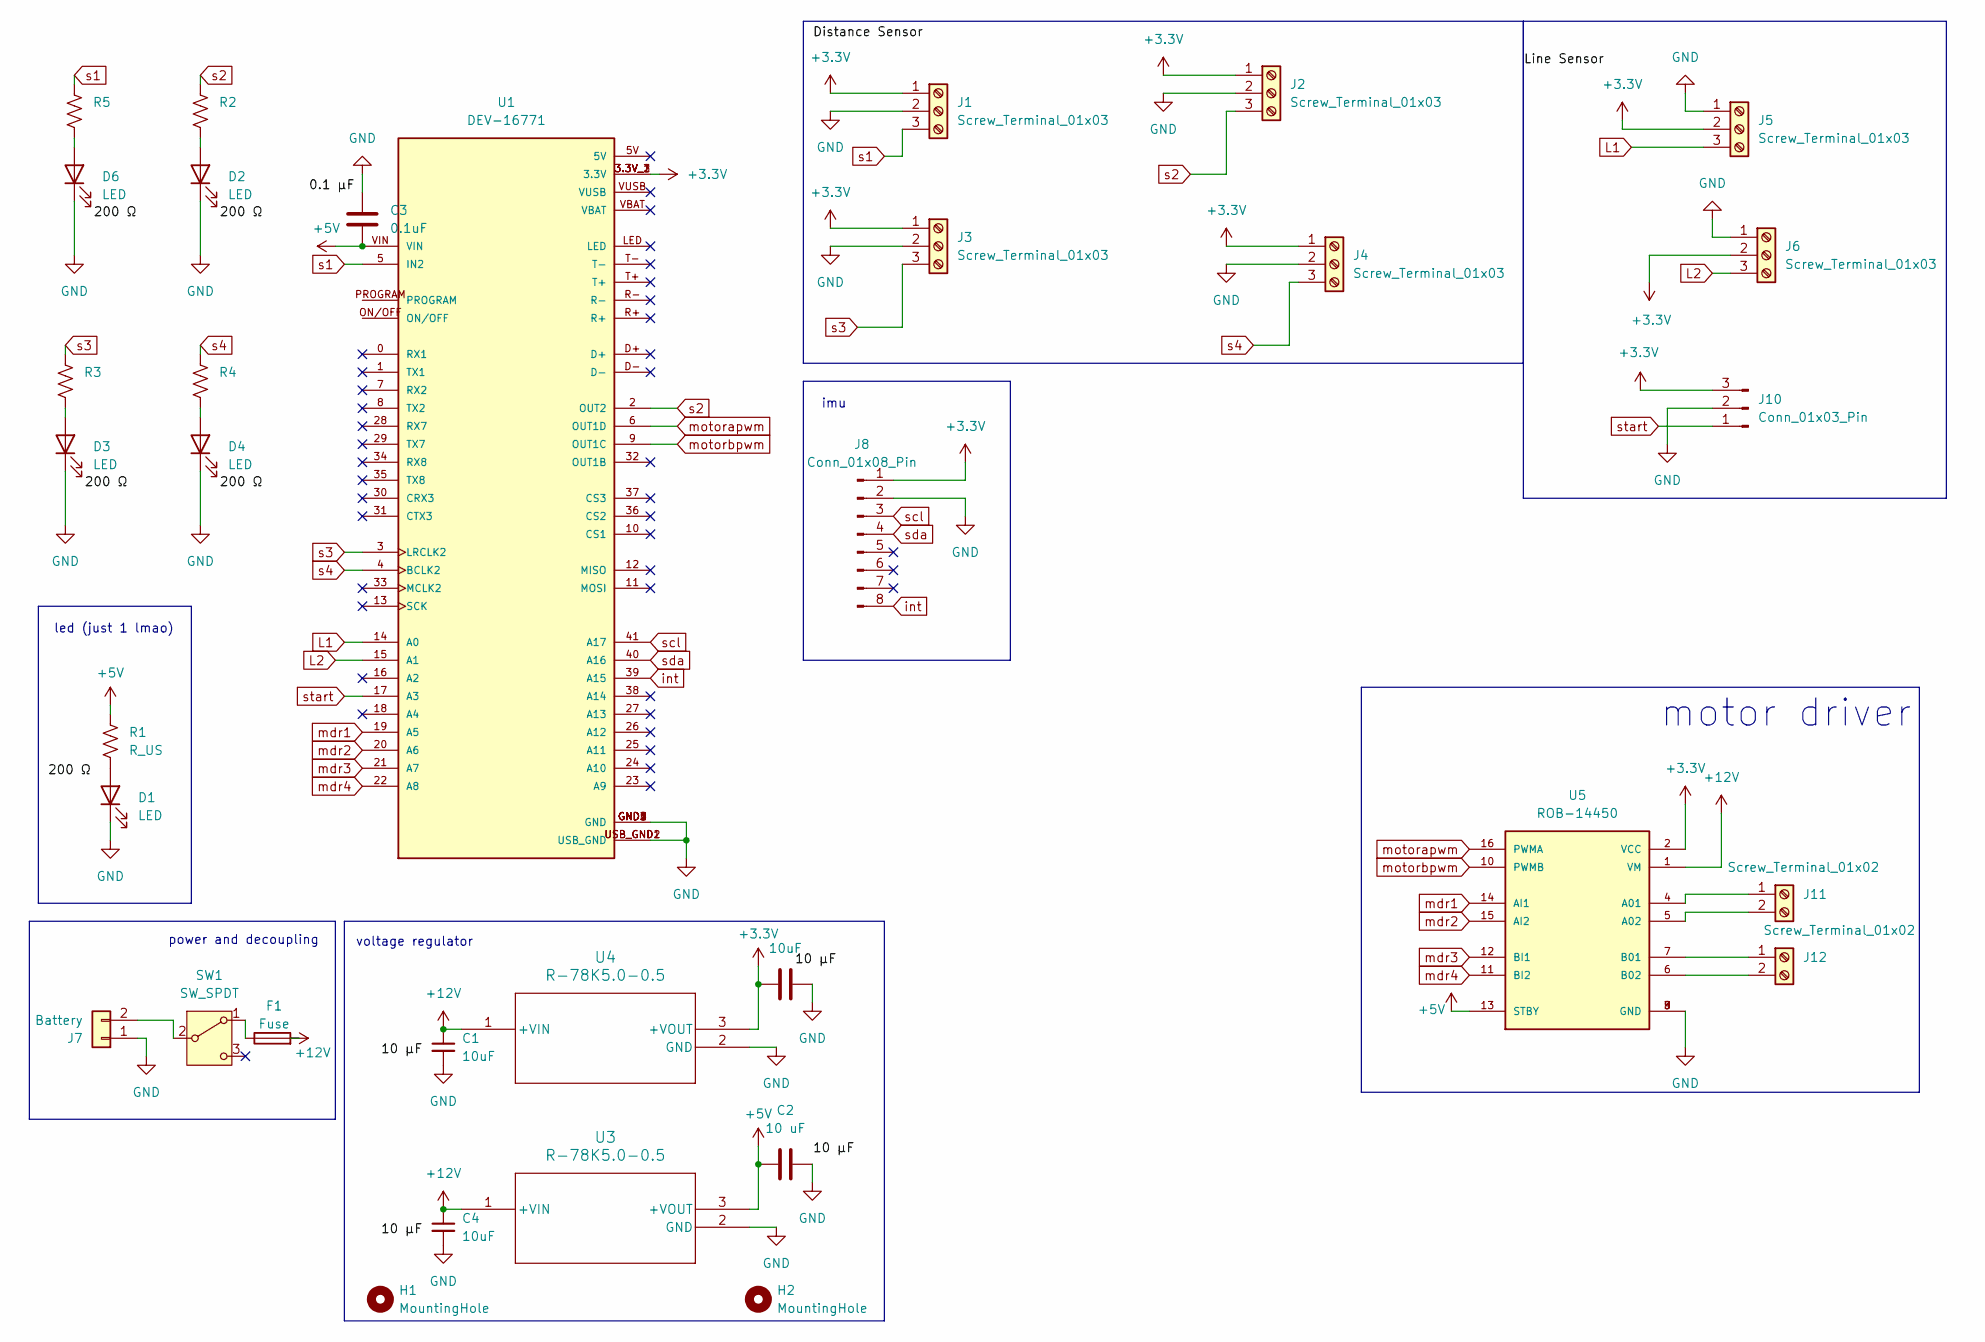
[picture p32: schematic Schematic.kicad_sch]

Parts:
C1, C4, C5: 10uF; C_0805_2012Metric
C2: 10 uF; C_0805_2012Metric
C3: 0.1uF; C_0805_2012Metric
D1, D2, D3, D4, D6: LED; LED_1206_3216Metric
F1: Fuse; Fuse_1206_3216Metric
H1, H2: MountingHole; MountingHole_2.5mm
J1, J2, J3, J4, J5, J6: Screw_Terminal_01x03; TerminalBlock_Xinya_XY308-2.54-3P_1x03_P2.54mm_Horizontal
J7: Battery; AMASS_XT30U-F_1x02_P5.0mm_Vertical
J8: Conn_01x08_Pin; PinHeader_1x08_P2.54mm_Vertical
J10: Conn_01x03_Pin; PinHeader_1x03_P2.54mm_Vertical
J11, J12: Screw_Terminal_01x02; TerminalBlock_Xinya_XY308-2.54-2P_1x02_P2.54mm_Horizontal
R1, R2, R3, R4, R5: R_US; R_0805_2012Metric
SW1: SW_SPDT; switch
U1: DEV-16771; teensy; PARTREV 4.1
U3, U4: R-78K5.0-0.5; voltageregulator
U5: ROB-14450; driver; PARTREV 11-13-17

Connections:
+3.3V: C5.1, J1.1, J2.1, J3.1, J4.1, J5.2, J6.2, J8.1, J10.3, U1.3.3V_1 (3.3V), U1.3.3V_2 (3.3V), U1.3.3V_3 (3.3V), U4.3 (+VOUT), U5.2 (VCC)
+5V: C2.1, C3.2, R1.1, U1.VIN, U3.3 (+VOUT), U5.13 (STBY)
+12V: C1.1, C4.1, F1.2, U3.1 (+VIN), U4.1 (+VIN), U5.1 (VM)
GND: C1.2, C2.2, C3.1, C4.2, C5.2, D1.1 (K), D2.1 (K), D3.1 (K), D4.1 (K), D6.1 (K), J1.2, J2.2, J3.2, J4.2, J5.1, J6.1, J7.1, J8.2, J10.2, U1.GND1 (GND), U1.GND2 (GND), U1.GND3 (GND), U1.GND4 (GND), U1.GND5 (GND), U1.USB_GND1 (USB_GND), U1.USB_GND2 (USB_GND), U3.2 (GND), U4.2 (GND), U5.3 (GND), U5.8 (GND), U5.9 (GND)
L1: J5.3, U1.14 (A0)
L2: J6.3, U1.15 (A1)
unnamed: D1.2 (A), R1.2
unnamed: D2.2 (A), R2.2
unnamed: D3.2 (A), R3.2
unnamed: D4.2 (A), R4.2
unnamed: D6.2 (A), R5.2
unnamed: J7.2, SW1.2 (B)
unnamed: J11.1, U5.4 (A01)
unnamed: J11.2, U5.5 (A02)
unnamed: J12.1, U5.7 (B01)
unnamed: J12.2, U5.6 (B02)
unnamed: F1.1, SW1.1 (A)
int: J8.8, U1.39 (A15)
mdr1: U1.19 (A5), U5.14 (AI1)
mdr2: U1.20 (A6), U5.15 (AI2)
mdr3: U1.21 (A7), U5.12 (BI1)
mdr4: U1.22 (A8), U5.11 (BI2)
motorapwm: U1.6 (OUT1D), U5.16 (PWMA)
motorbpwm: U1.9 (OUT1C), U5.10 (PWMB)
s1: J1.3, R5.1, U1.5 (IN2)
s2: J2.3, R2.1, U1.2 (OUT2)
s3: J3.3, R3.1, U1.3 (LRCLK2)
s4: J4.3, R4.1, U1.4 (BCLK2)
scl: J8.3, U1.41 (A17)
sda: J8.4, U1.40 (A16)
start: J10.1, U1.17 (A3)

Notes on the sheet:
led (just 1 lmao)
motor driver
power and decoupling
voltage regulator
imu

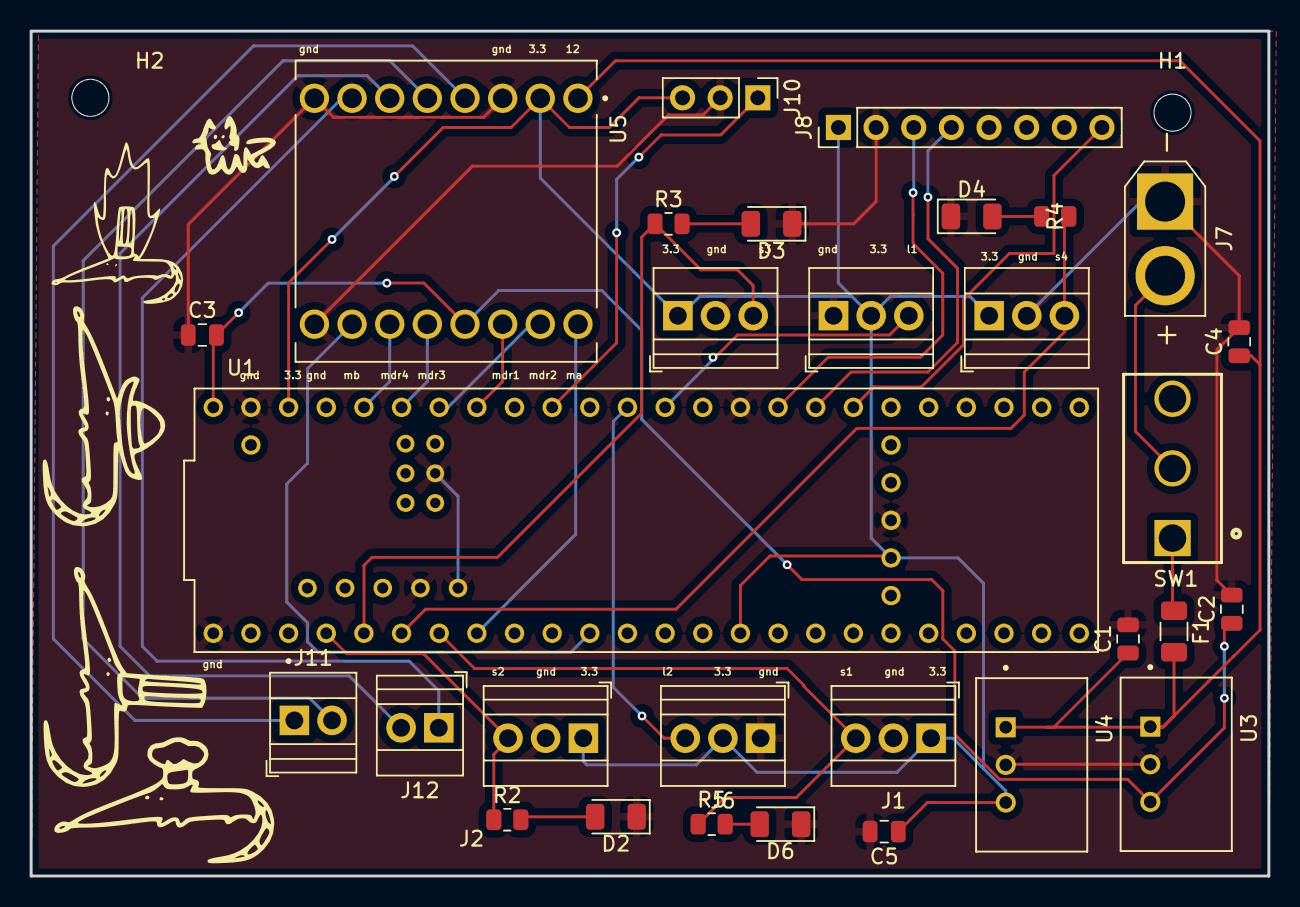
[picture p33: board Schematic.kicad_pcb from above]

Board: 2 copper layers, 83.5 x 57.0 mm, 32 parts (0 on the bottom side), 30 nets.
