RoboJackets/robowrestling/Skibidi/Skibid-i/Skibid-i.kicad_pcb

## KiCad design Skibidi/Skibid-i/Skibid-i.kicad_pcb (2024-09-20)

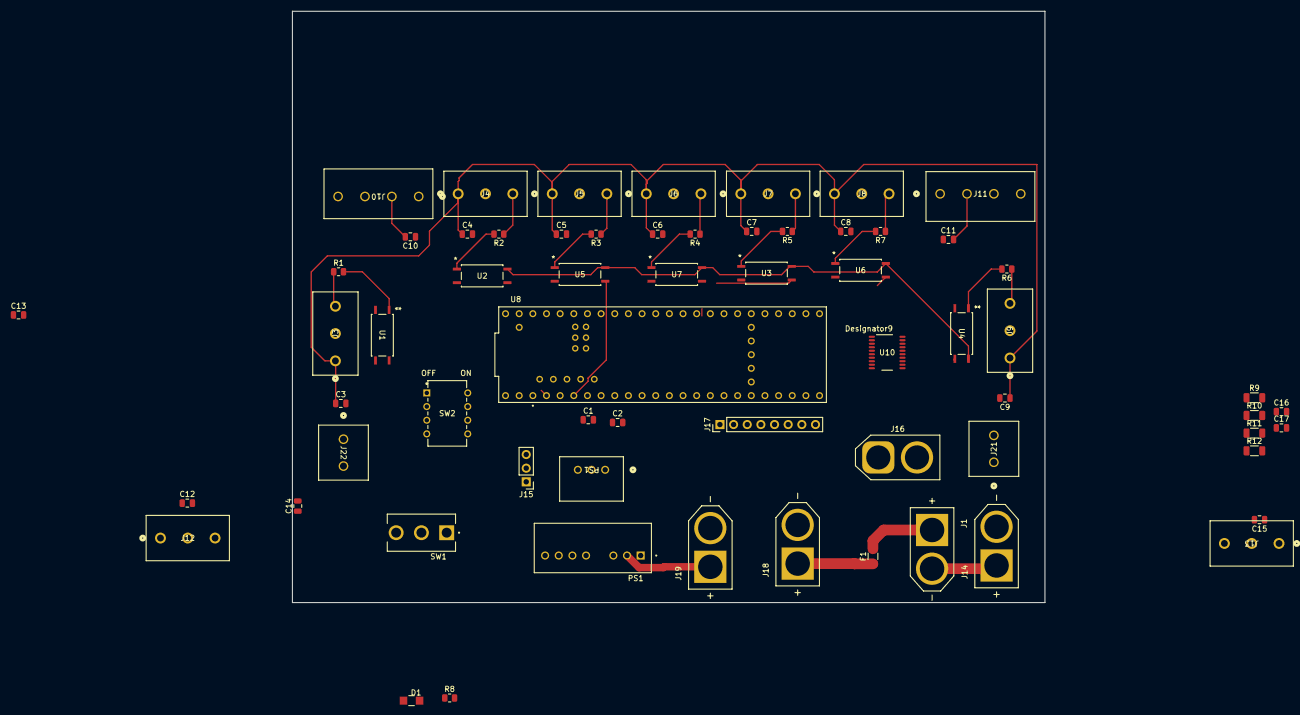
[picture p34: board Skibid-i.kicad_pcb from above]

Board: 2 copper layers, 140.0 x 110.0 mm, 64 parts (0 on the bottom side), 47 nets.

Parts:
C1, C16: 10uF; C_0805_2012Metric
C2, C17: 22uF; C_0805_2012Metric
C3, C4, C5, C6, C7, C8, C9, C10, C11, C12, C13, C14, C15: 0.1uF; C_0805_2012Metric
D1: LED
F1: Fuse; Fuse_1206_3216Metric
J1, J14: XT60-M; XT60
J3, J4, J5, J6, J7, J8, J9, J12, J13: Screw_Terminal_01x03; ScrewTerminal3
J10, J11: Screw_Terminal_01x04; Screwterminal4
J15: Conn_01x03_Pin; PinHeader_1x03_P2.54mm_Vertical
J16: Conn_01x02_Pin; AMASS_XT60-F_1x02_P7.20mm_Vertical
J17: Conn_01x08_Pin; PinHeader_1x08_P2.54mm_Vertical
J18: Sparkin; XT60
J19: Sparkout; XT60
J21: Motor1; Screwterminal2
J22: Motor2; Screwterminal2
PS1: P78E05-1000; 5vConvertor
PS1#2: RSO-4812S_H2; 12VCVON
R1, R2, R3, R4, R5, R6, R7, R8: 500ohm; R_0805_2012Metric
R9, R10, R11, R12: 10k; R_1206_3216Metric
SW1: 500SSP1S2M2QEA; SWitch
SW2: 210-4MS; dipswitch
U1, U2, U3, U4, U5, U6, U7: LTV-827S; RealOPtocoupler
U8: DEV-16771; Teensy4.1
U10: TXB0108PWR; levelshifter

Connections:
+3.3V: C12.2, C13.2, C14.1, C15.2, J12.2, J13.2, J15.2, J17.1, SW2.1, SW2.2, SW2.3, SW2.4, U8.3.3V_1 (3.3V), U8.3.3V_2 (3.3V), U8.3.3V_3 (3.3V), U10.19 (VCCB)
+5V: C2.1, C10.2, C11.2, J10.2, J11.2, PS1.3 (+VOUT/GND), U8.VIN, U10.2 (VCCA), U10.10 (OE)
+12V: C1.2, C3.1, C4.1, C5.1, C6.1, C7.1, C8.1, C9.1, C17.1, J3.1, J4.1, J5.1, J6.1, J7.1, J8.1, J9.1, PS1#2.6 (+VOUT)
+48V: J16.2, J19.P (POS), PS1#2.2 (+VIN), R8.2, SW1.3
BDC1: J22.1, U8.11 (MOSI)
BDC2: J21.1, U8.36 (CS2)
BDC11: J22.2, U8.12 (MISO)
BDC22: J21.2, U8.37 (CS3)
DIP1: R10.1, SW2.5, U8.24 (A10)
DIP2: R12.1, SW2.6, U8.25 (A11)
DIP3: R11.1, SW2.7, U8.26 (A12)
DIP4: R9.2, SW2.8, U8.27 (A13)
GND: C1.1, C2.2, C3.2, C4.2, C5.2, C6.2, C7.2, C8.2, C9.2, C10.1, C11.1, C12.1, C13.1, C14.2, C15.1, C16.1, C17.2, D1.1 (K), J3.2, J4.2, J5.2, J6.2, J7.2, J8.2, J9.2, J10.1, J11.1, J12.1, J13.1, J14.N (NEG), J15.3, J16.1, J17.2, J18.N (NEG), J19.N (NEG), PS1.2 (GND/-VOUT), PS1#2.1 (-VIN), PS1#2.7 (-VOUT), R9.1, R10.2, R11.2, R12.2, U1.2, U2.2, U3.2, U4.2, U5.2, U6.2, U7.2, U8.GND1 (GND), U8.GND2 (GND), U8.GND3 (GND), U8.GND4 (GND), U8.GND5 (GND), U8.USB_GND1 (USB_GND), U8.USB_GND2 (USB_GND), U10.11 (GND)
LN1: J10.4, U10.1 (A1)
LN1A: U8.14 (A0), U10.20 (B1)
LN2: J10.3, U10.3 (A2)
LN2A: U8.15 (A1), U10.18 (B2)
LN3: J11.4, U10.4 (A3)
LN3A: U8.16 (A2), U10.17 (B3)
LN4: J11.3, U10.5 (A4)
LN4A: U8.17 (A3), U10.16 (B4)
LN5: J12.3, U10.6 (A5)
LN5A: U8.18 (A4), U10.15 (B5)
LN6: J13.3, U10.7 (A6)
LN6A: U8.19 (A5), U10.14 (B6)
LN7A: U8.20 (A6), U10.13 (B7)
LN8A: U8.21 (A7), U10.12 (B8)
unnamed: D1.2 (A), R8.1
unnamed: J1.N (NEG), J14.P (POS)
unnamed: F1.2, J1.P (POS)
unnamed: F1.1, J18.P (POS)
unnamed: R1.2, U1.1
unnamed: R2.2, U2.1
unnamed: R3.2, U5.1
unnamed: R4.2, U7.1
unnamed: R5.2, U3.1
unnamed: R6.2, U4.1
unnamed: R7.2, U6.1
OM1: J3.3, R1.1
OM2: J4.3, R2.1
OM3: J5.3, R3.1
OM4: J6.3, R4.1
OM5: J7.3, R5.1
OM6: J9.3, R6.1
OM7: J8.3, R7.1
SDA: J17.4, U8.22 (A8), U8.23 (A9)
Start: J15.1, U8.32 (OUT1B)
