RoboJackets/robowrestling/Skibidi/Skibid-i/Skibidi-Motordriver/Skibidi-Motordriver.kicad_pcb

## KiCad design Skibidi/Skibid-i/Skibidi-Motordriver/Skibidi-Motordriver.kicad_pcb (2024-09-06)

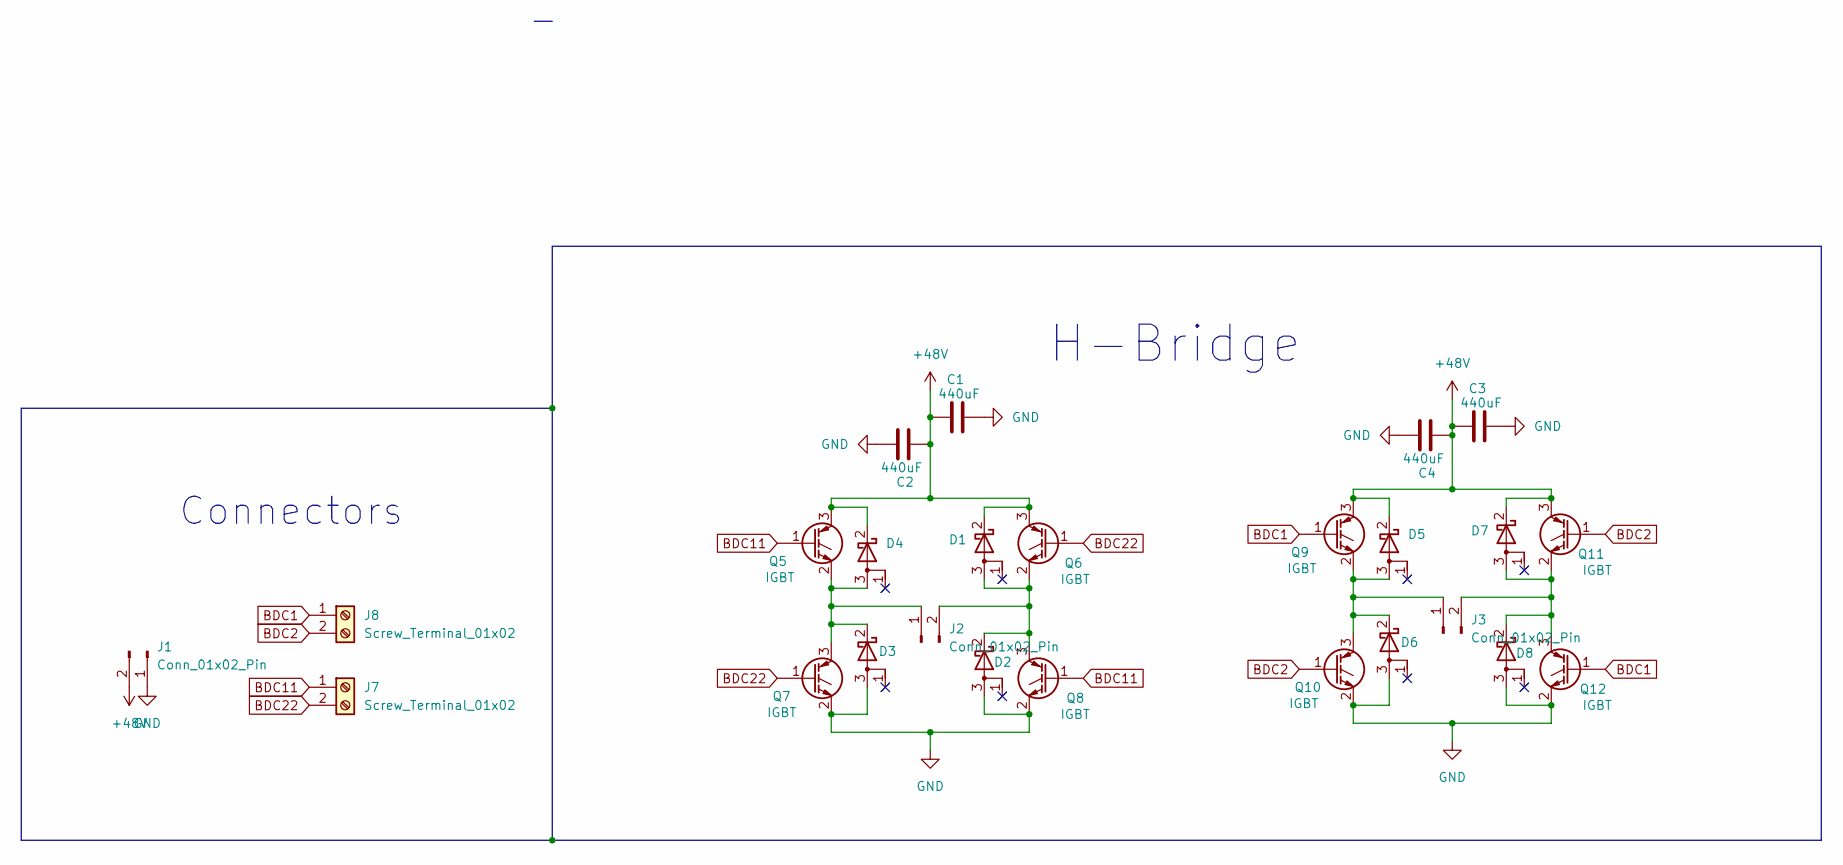
[picture p35: schematic Skibidi-Motordriver.kicad_sch]

Parts:
C1, C2, C3, C4: 440uF; BIGASSCAP
D1, D2, D3, D4, D5, D6, D7, D8: D_Schottky_AKA; schottky
J1, J2, J3: Conn_01x02_Pin; AMASS_XT60-F_1x02_P7.20mm_Vertical
J7, J8: Screw_Terminal_01x02; Screwterminal2
Q5, Q6, Q7, Q8, Q9, Q10, Q11, Q12: IGBT

Connections:
+48V: C1.1, C2.1, C3.1, C4.1, D1.2 (K), D4.2 (K), D5.2 (K), D7.2 (K), J1.2, Q5.3 (C), Q6.3 (C), Q9.3 (C), Q11.3 (C)
BDC1: J8.1, Q9.1 (G), Q12.1 (G)
BDC2: J8.2, Q10.1 (G), Q11.1 (G)
BDC11: J7.1, Q5.1 (G), Q8.1 (G)
BDC22: J7.2, Q6.1 (G), Q7.1 (G)
GND: C1.2, C2.2, C3.2, C4.2, D2.3 (A), D3.3 (A), D6.3 (A), D8.3 (A), J1.1, Q7.2 (E), Q8.2 (E), Q10.2 (E), Q12.2 (E)
unnamed: D1.3 (A), D2.2 (K), J2.2, Q6.2 (E), Q8.3 (C)
unnamed: D3.2 (K), D4.3 (A), J2.1, Q5.2 (E), Q7.3 (C)
unnamed: D5.3 (A), D6.2 (K), J3.1, Q9.2 (E), Q10.3 (C)
unnamed: D7.3 (A), D8.2 (K), J3.2, Q11.2 (E), Q12.3 (C)

Notes on the sheet:
H-Bridge
Connectors

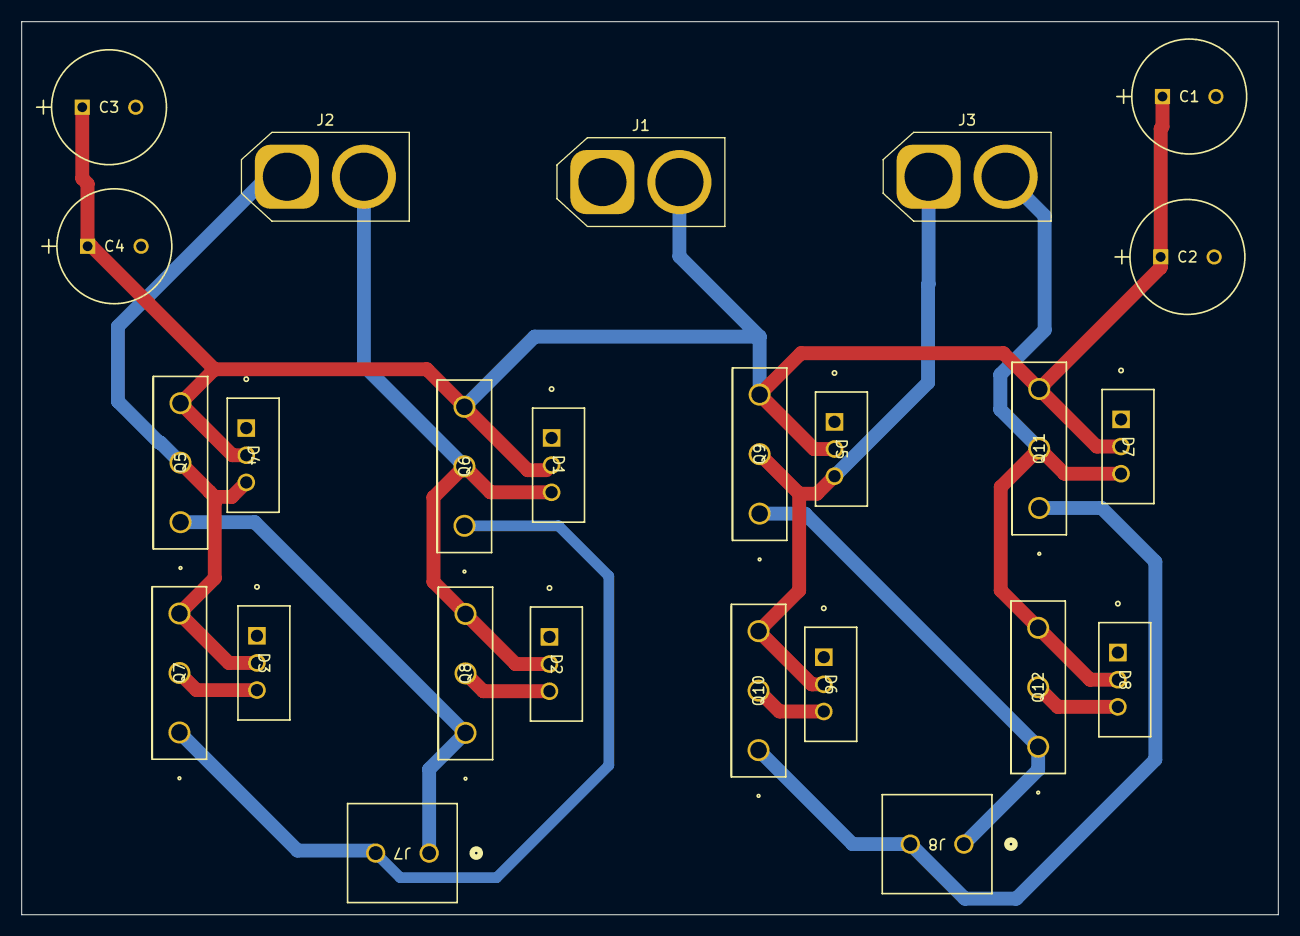
[picture p36: board Skibidi-Motordriver.kicad_pcb from above]

Board: 2 copper layers, 117.5 x 83.5 mm, 25 parts (0 on the bottom side), 10 nets.
