RoboJackets/robowrestling/ControlBoard/Timmi/rwTimmiCB/rwTimmiCB/rwTimmiCB.kicad_pcb

## KiCad design ControlBoard/Timmi/rwTimmiCB/rwTimmiCB/rwTimmiCB.kicad_pcb (2024-02-18)

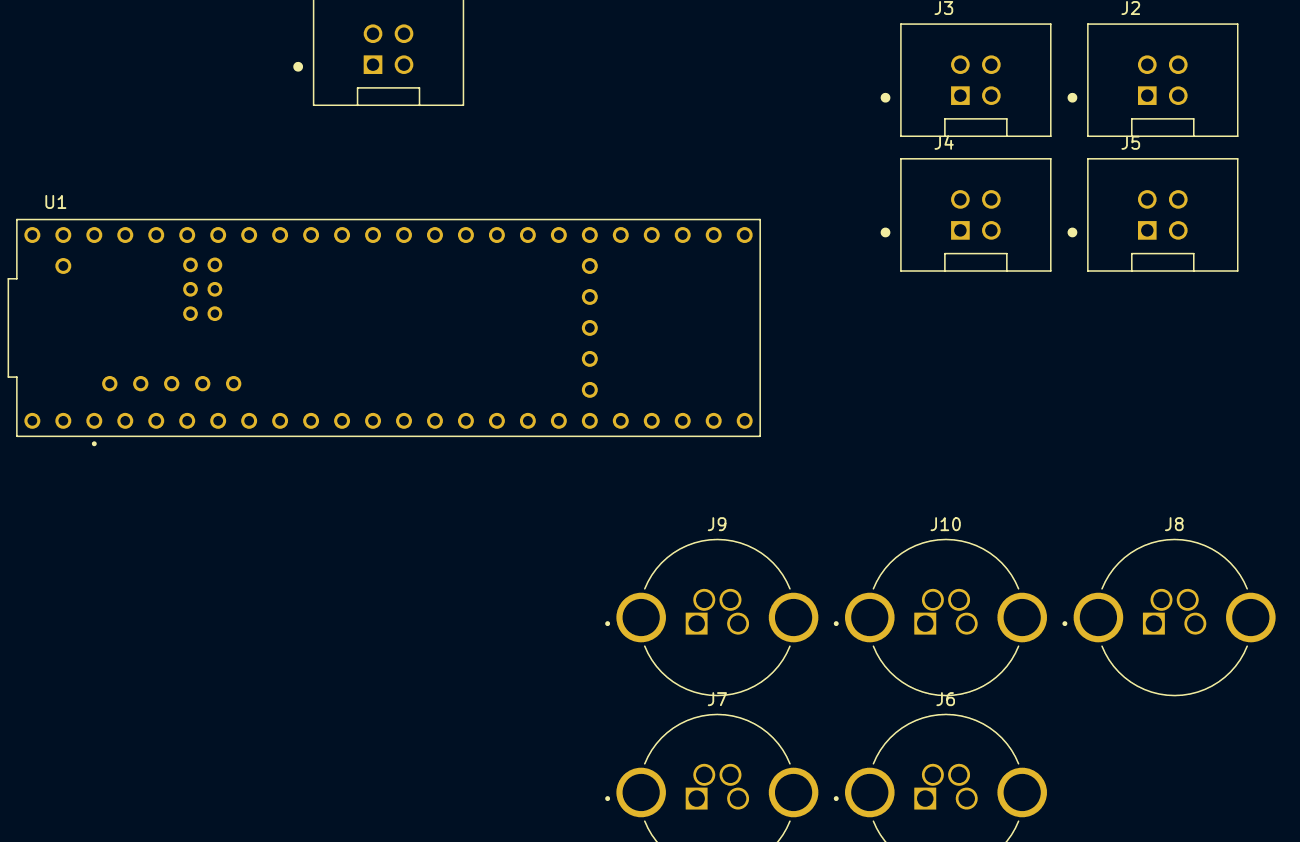
[picture p37: board ControlBoard/Timmi/rwTimmiCB/rwTimmiCB/rwTimmiCB.kicad_pcb from above]

Board: 2 copper layers, 11 parts (0 on the bottom side), 13 nets, no tracks yet.

Parts:
J1, J2, J3, J4, J5: 75869-130LF; FCI_75869-130LF
J6, J7, J8, J9, J10: T4040034041-000; TE_T4040034041-000
U1: DEV-16771; MODULE_DEV-16771

Connections:
+3.3V: J1.3, J2.1, J3.1, J4.1, J5.1
GND: J1.2, J2.3, J3.3, J4.3, J5.3
Line LB: J5.2, U1.18 (A4)
Line LF: J3.2, U1.16 (A2)
Line RB: J4.2, U1.17 (A3)
Line RF: J2.2, U1.15 (A1)
unnamed: J6.SH1 (SHIELD), J6.SH2 (SHIELD)
unnamed: J7.SH1 (SHIELD), J7.SH2 (SHIELD)
unnamed: J8.SH1 (SHIELD), J8.SH2 (SHIELD)
unnamed: J9.SH1 (SHIELD), J9.SH2 (SHIELD)
unnamed: J10.SH1 (SHIELD), J10.SH2 (SHIELD)
unnamed: U1.3.3V_1 (3.3V), U1.3.3V_2 (3.3V), U1.3.3V_3 (3.3V)
Start: J1.1, U1.14 (A0)
