RoboJackets/robowrestling/ControlBoard/Timmi/rwTimmiCB/rwTimmiCB.kicad_pcb

## KiCad design ControlBoard/Timmi/rwTimmiCB/rwTimmiCB.kicad_pcb (2024-02-18)

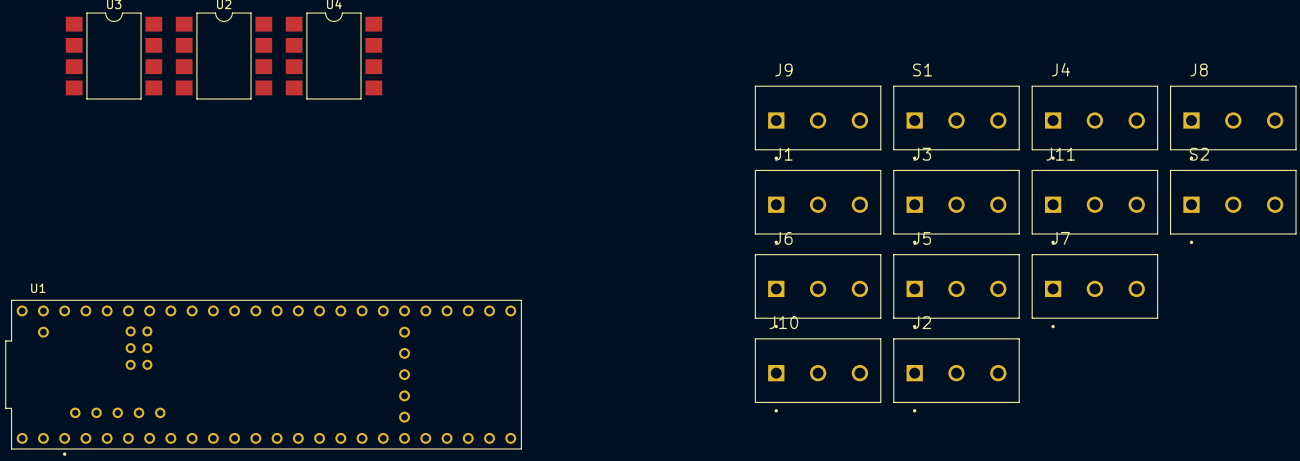
[picture p38: board ControlBoard/Timmi/rwTimmiCB/rwTimmiCB.kicad_pcb from above]

Board: 2 copper layers, 17 parts (0 on the bottom side), 24 nets, no tracks yet.

Parts:
J1, J2, J3, J4, J5, J6, J7, J8, J9, J10, J11: B3B-EH-ALFSN; CUI_TB002-500-03BE
S1, S2: B3B-EH-ALFSN; CUI_TB002-500-03BE
U1: DEV-16771; MODULE_DEV-16771
U2, U3, U4: LTV-827S; SMDIP-8_W9.53mm

Connections:
+3.3V: J1.1, J2.1, J3.1, J4.1, J5.1, U1.3.3V_1 (3.3V), U1.3.3V_2 (3.3V), U1.3.3V_3 (3.3V), U2.6, U2.8, U3.6, U3.8, U4.6, U4.8
+12V: J6.1, J7.1, J8.1, J9.1, J10.1, J11.1
GND: J1.3, J2.3, J3.3, J4.3, J5.3, J6.3, J7.3, J8.3, J9.3, J10.3, J11.3, S1.3, S2.3, U2.2, U2.4, U3.2, U3.4, U4.2, U4.4
Line1: J2.2, U1.15 (A1)
Line2: J3.2, U1.16 (A2)
Line3: J4.2, U1.17 (A3)
Line4: J5.2, U1.18 (A4)
MD1: S1.1, U1.0 (RX1)
MD2: S2.1, U1.1 (TX1)
unnamed: U1.GND2 (GND), U1.GND3 (GND), U1.GND4 (GND), U1.GND5 (GND)
unnamed: U1.USB_GND1 (USB_GND), U1.USB_GND2 (USB_GND)
Start: J1.2, U1.14 (A0)
ir1: U1.19 (A5), U2.7
ir2: U1.20 (A6), U2.5
ir3: U1.21 (A7), U3.7
ir4: U1.22 (A8), U3.5
ir5: U1.23 (A9), U4.7
ir6: U1.24 (A10), U4.5
oct1: J6.2, U2.1
oct2: J7.2, U2.3
oct3: J8.2, U3.1
oct4: J9.2, U3.3
oct5: J10.2, U4.1
oct6: J11.2, U4.3
