RoboJackets/robowrestling/3kg/Ferrarii/Ferrarii/Ferrarii.kicad_pcb

## KiCad design 3kg/Ferrarii/Ferrarii/Ferrarii.kicad_pcb (2025-08-04)

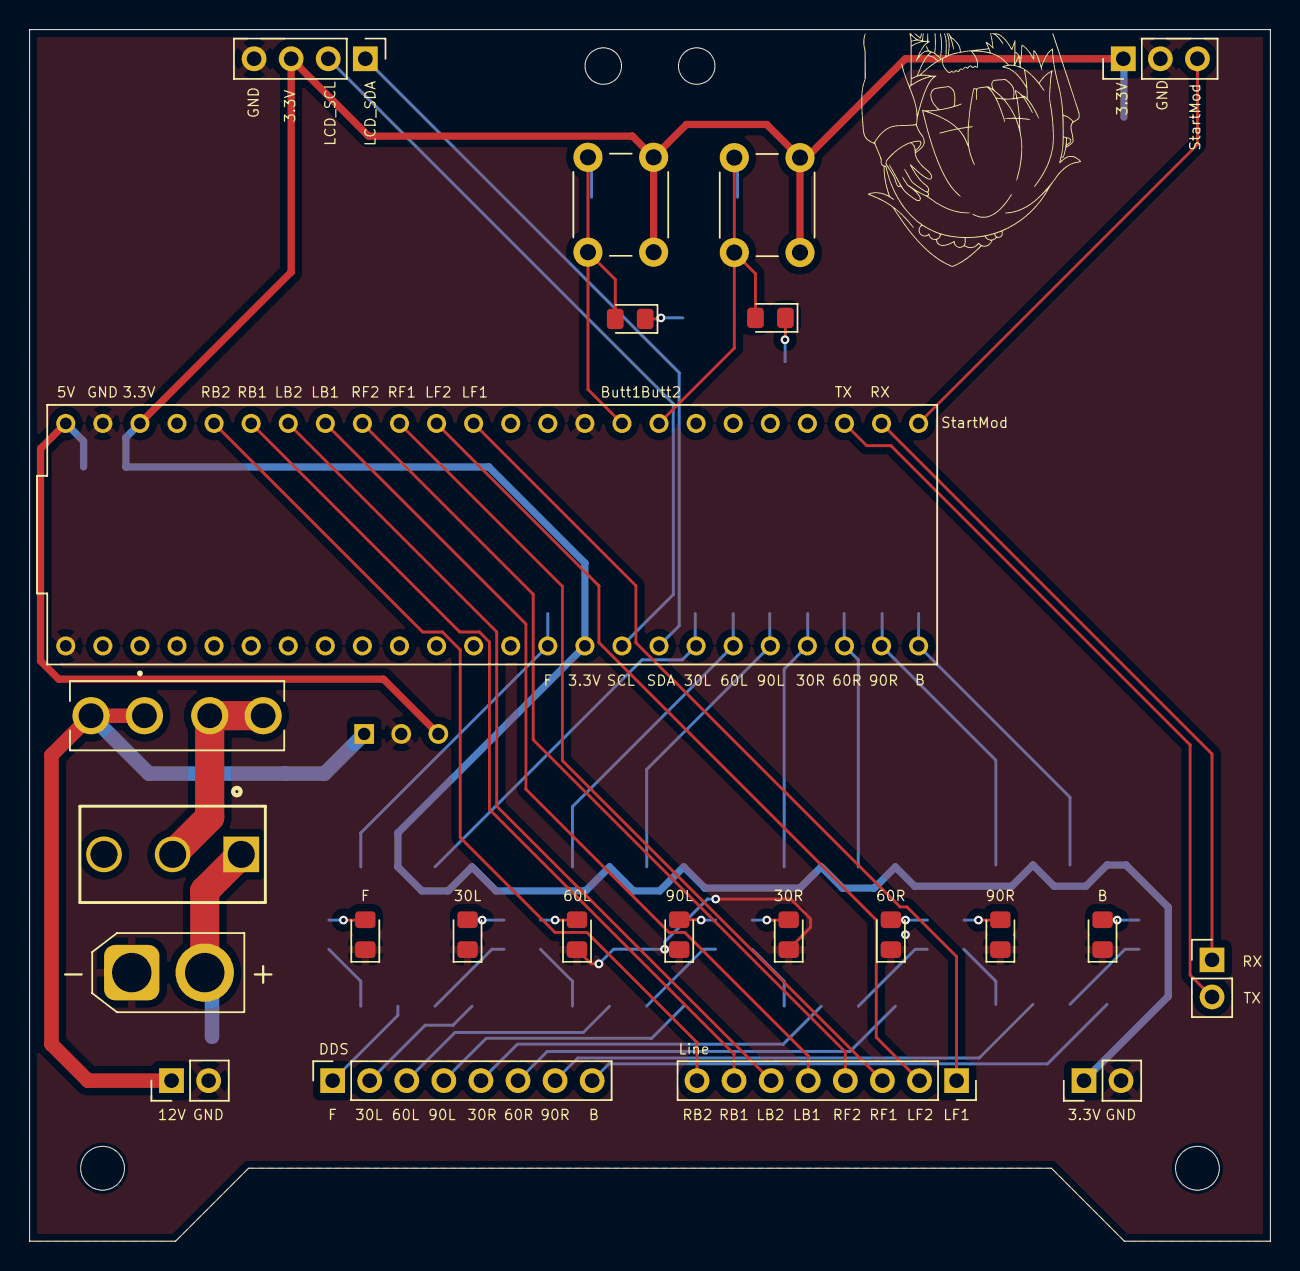
[picture p39: board Ferrarii.kicad_pcb from above]

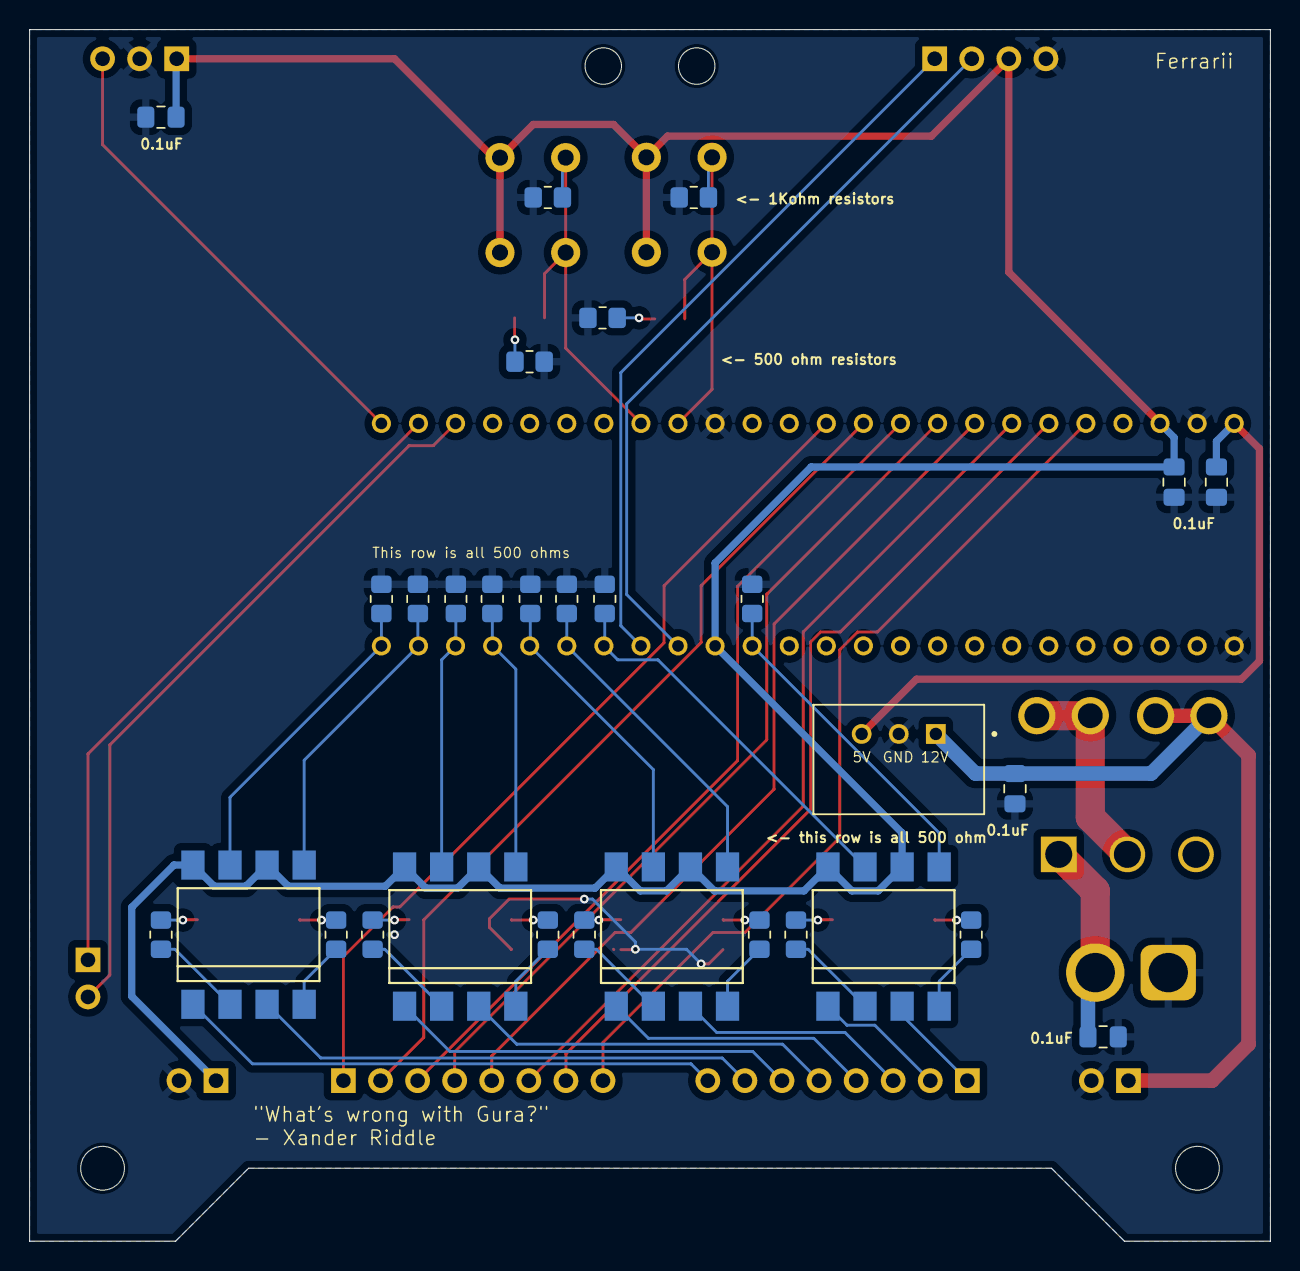
[picture p40: board Ferrarii.kicad_pcb from below]

Board: 2 copper layers, 85.0 x 83.0 mm, 53 parts (30 on the bottom side), 55 nets.

Parts:
C1, C2, C4, C24, C25: 0.1uF; C_0805_2012Metric_Pad1.18x1.45mm_HandSolder
D1, D2, D3, D4, D5, D6, D7, D8, D9, D10: LED; LED_0805_2012Metric_Pad1.15x1.40mm_HandSolder
F2: 3544-2; FUSE_3544-2
J1: distance sensors signals; PinSocket_1x08_P2.54mm_Vertical
J2: distance sensor power; PinHeader_1x02_P2.54mm_Vertical
J3: line sensor power; PinHeader_1x02_P2.54mm_Vertical
J4: Start Module; PinHeader_1x03_P2.54mm_Vertical
J5: 12vPower; AMASS_XT30U-F_1x02_P5.0mm_Vertical
J6: line sensor jst; PinSocket_1x08_P2.54mm_Vertical
J10: MD; PinHeader_1x02_P2.54mm_Vertical
J11: LCD_Screen; PinHeader_1x04_P2.54mm_Vertical
PS1: TSR_1-2450; CONV_TSR_1-2450
Q1, Q2, Q3, Q4: LTV-826S; DIL8-SMD
R1, R2: 1k; R_0805_2012Metric_Pad1.20x1.40mm_HandSolder
R3, R4, R12, R13, R14, R15, R16, R17, R18, R19, R23, R24, R25, R26, R27, R28, R29, R30: 500; R_0805_2012Metric_Pad1.20x1.40mm_HandSolder
S1: 1101M2S3CQE2; SW_1101M2S3CQE2
SW1, SW2: SW_Push; SW_PUSH_6mm_H5mm
U1: DEV-16771; MODULE_DEV-16771

Connections:
+3.3V: C2.1, C4.2, J3.1, J4.1, J11.3, Q1.6, Q1.8, Q2.6, Q2.8, Q3.6, Q3.8, Q4.6, Q4.8, SW1.1, SW2.1, U1.3.3V_1 (3.3V), U1.3.3V_2 (3.3V)
+5V: C1.2, PS1.3 (+VOUT), U1.VIN
+12V: C25.2, F2.1_1, F2.1_2, J2.1, PS1.1 (+VIN)
Button1: D9.2 (A), R1.1, SW1.2, U1.40 (A16)
Button2: D10.2 (A), R2.1, SW2.2, U1.41 (A17)
DS_30L: Q1.7, R24.2, U1.26 (A12)
DS_30R: Q3.5, R28.2, U1.29 (TX7)
DS_60L: Q2.5, R26.2, U1.27 (A13)
DS_60R: Q3.7, R27.2, U1.30 (CRX3)
DS_90L: Q2.7, R25.2, U1.28 (RX7)
DS_90R: Q4.5, R30.2, U1.31 (CTX3)
DS_B: Q4.7, R29.2, U1.32 (OUT1B)
DS_F: Q1.5, R23.2, U1.12 (MISO)
GND: C1.1, C2.2, C4.1, C24.2, C25.1, D1.1 (K), D2.1 (K), D3.1 (K), D4.1 (K), D5.1 (K), D6.1 (K), D7.1 (K), D8.1 (K), J2.2, J3.2, J4.2, J5.1, J11.4, PS1.2 (GND), R1.2, R2.2, R3.1, R4.1, R23.1, R24.1, R25.1, R26.1, R27.1, R28.1, R29.1, R30.1, U1.GND1 (GND), U1.GND2 (GND), U1.GND3 (GND)
JSUMOStartMod: J4.3, U1.33 (MCLK2)
LCD_SCL: J11.2, U1.24 (A10)
LCD_SDA: J11.1, U1.25 (A11)
LS_LB1: J6.5, U1.19 (A5)
LS_LB2: J6.6, U1.20 (A6)
LS_LF1: J6.1, U1.15 (A1)
LS_LF2: J6.2, U1.16 (A2)
LS_RB1: J6.7, U1.21 (A7)
LS_RB2: J6.8, U1.22 (A8)
LS_RF1: J6.3, U1.17 (A3)
LS_RF2: J6.4, U1.18 (A4)
MD_RX: J10.1, U1.34 (RX8)
MD_TX: J10.2, U1.35 (TX8)
unnamed: D1.2 (A), R12.1
unnamed: D2.2 (A), R13.1
unnamed: D3.2 (A), R14.1
unnamed: D4.2 (A), R15.1
unnamed: D5.2 (A), R16.1
unnamed: D6.2 (A), R17.1
unnamed: D7.2 (A), R18.1
unnamed: D8.2 (A), R19.1
unnamed: D9.1 (K), R3.2
unnamed: D10.1 (K), R4.2
unnamed: F2.2_1, F2.2_2, S1.2
unnamed: C24.1, J5.2, S1.1
unnamed: Q1.2, R12.2
unnamed: Q1.4, R13.2
unnamed: Q2.2, R14.2
unnamed: Q2.4, R15.2
unnamed: Q3.2, R16.2
unnamed: Q3.4, R17.2
unnamed: Q4.2, R18.2
unnamed: Q4.4, R19.2
OCT_30L: J1.2, Q1.1
OCT_30R: J1.5, Q3.3
OCT_60L: J1.3, Q2.3
OCT_60R: J1.6, Q3.1
OCT_90L: J1.4, Q2.1
OCT_90R: J1.7, Q4.3
OCT_B: J1.8, Q4.1
OCT_F: J1.1, Q1.3
