RoboJackets/robowrestling/500g/Rata2i/Schematic/Schematic.kicad_sch

## KiCad design 500g/Rata2i/Schematic/Schematic.kicad_sch (2025-10-02)

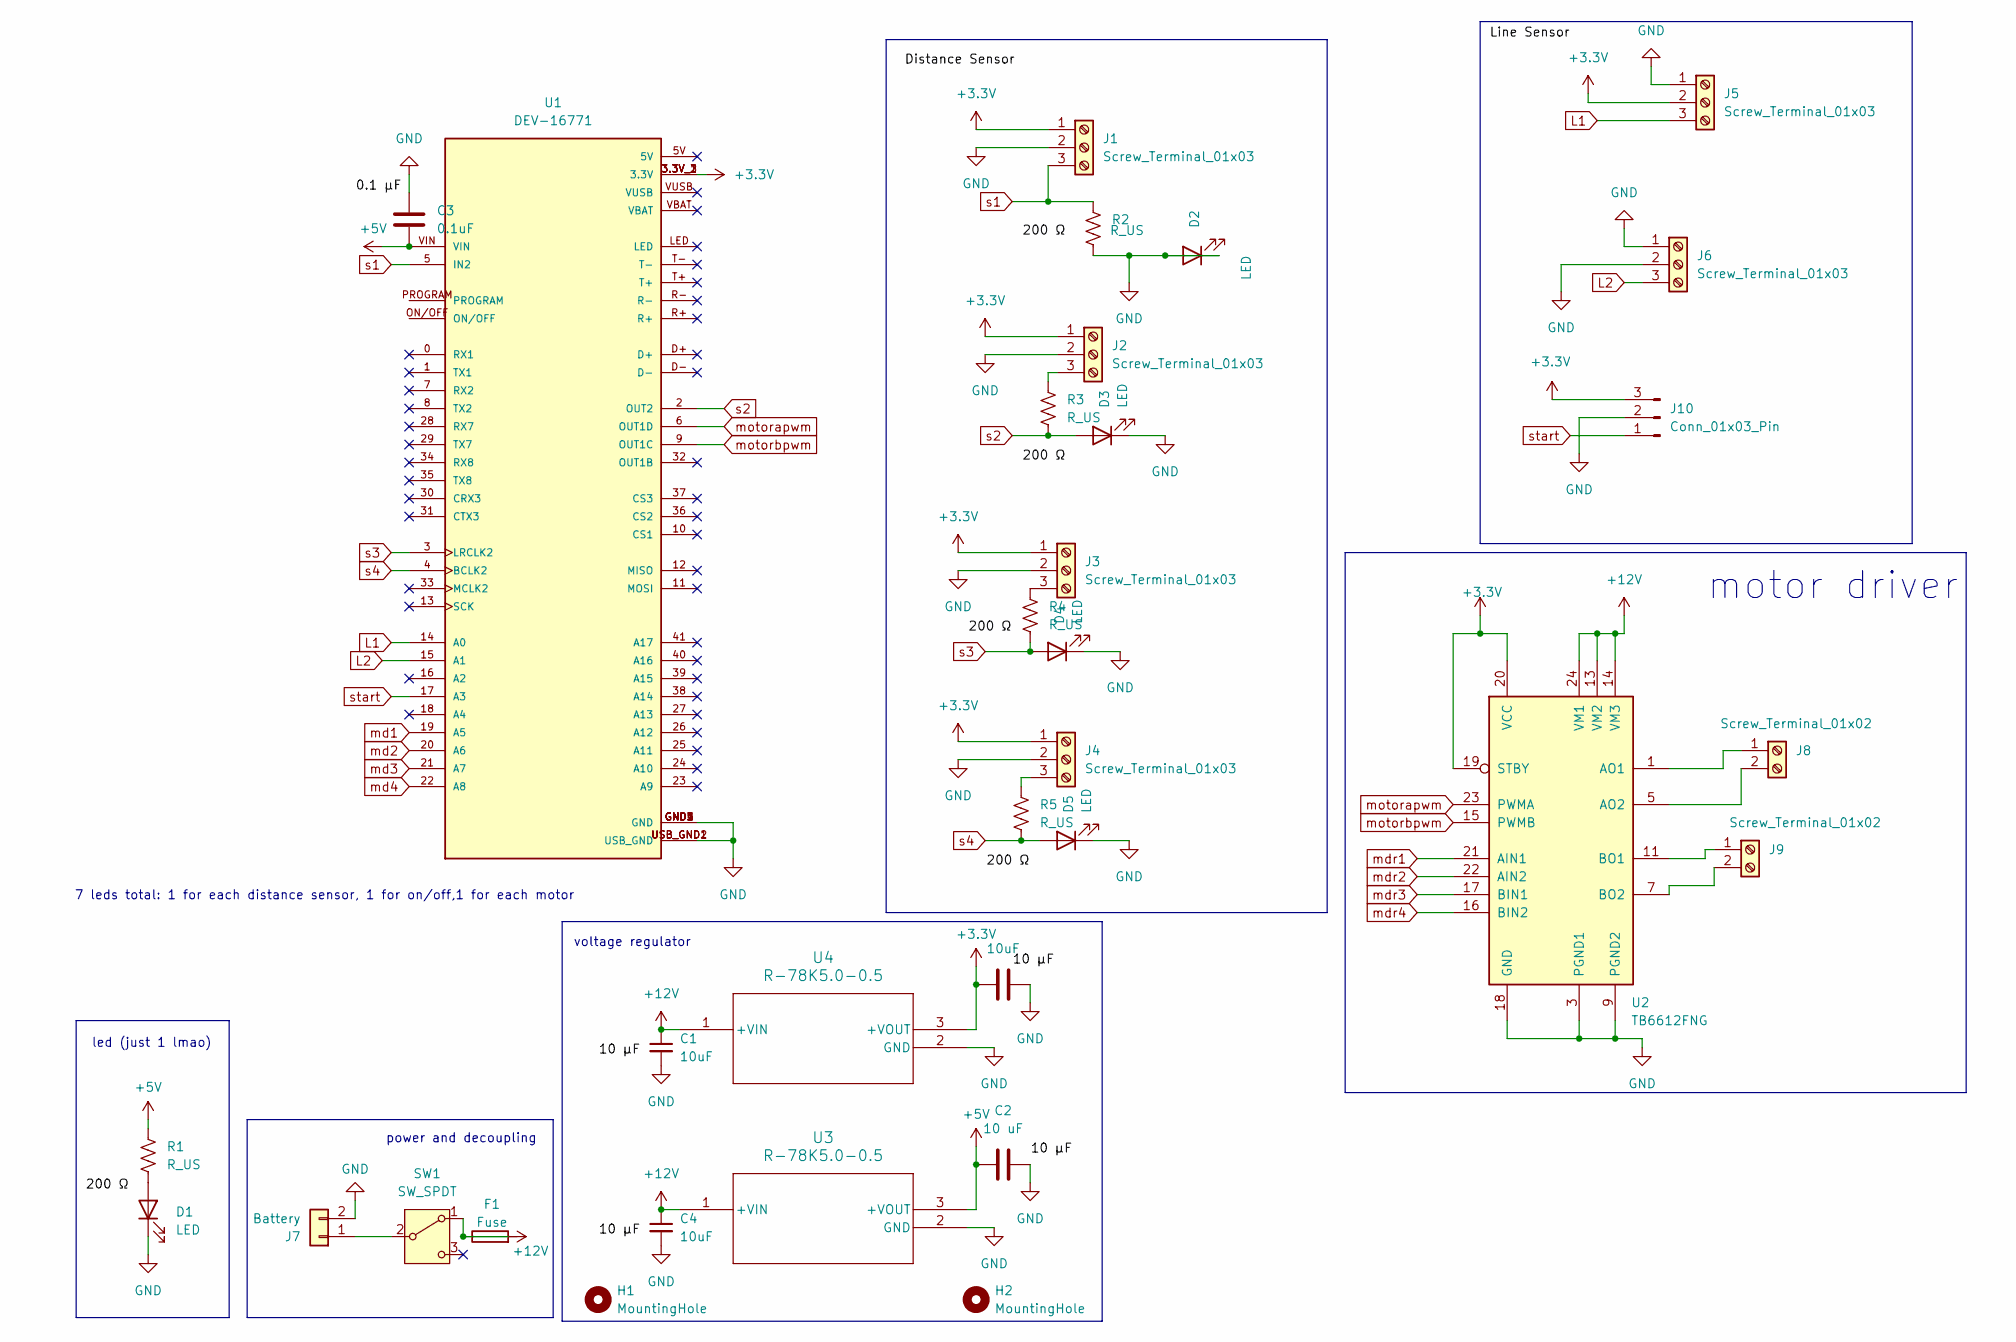
[picture p41: schematic Schematic.kicad_sch]

Parts:
C1, C4, C5: 10uF; C_0805_2012Metric
C2: 10 uF; C_0805_2012Metric
C3: 0.1uF; C_0805_2012Metric
D1, D2, D3, D4, D5: LED; C_1206_3216Metric
F1: Fuse
H1, H2: MountingHole
J1, J2, J3, J4, J5, J6: Screw_Terminal_01x03
J7: Battery
J8, J9: Screw_Terminal_01x02
J10: Conn_01x03_Pin
R1, R2, R3, R4, R5: R_US; R_0805_2012Metric
SW1: SW_SPDT
U1: DEV-16771; MODULE_DEV-16771; PARTREV 4.1
U2: TB6612FNG; SSOP-24_5.3x8.2mm_P0.65mm
U3, U4: R-78K5.0-0.5; SIP3_R-78K-0.5_RCP

Connections:
+3.3V: C5.1, J1.1, J2.1, J3.1, J4.1, J5.2, J10.3, U1.3.3V_1 (3.3V), U1.3.3V_2 (3.3V), U1.3.3V_3 (3.3V), U2.19 (STBY), U2.20 (VCC), U4.3 (+VOUT)
+5V: C2.1, C3.2, R1.1, U1.VIN, U3.3 (+VOUT)
+12V: C1.1, C4.1, F1.1, SW1.1 (A), U2.13 (VM2), U2.14 (VM3), U2.24 (VM1), U3.1 (+VIN), U4.1 (+VIN)
GND: C1.2, C2.2, C3.1, C4.2, C5.2, D1.1 (K), D2.1 (K), D2.2 (A), D3.1 (K), D4.1 (K), D5.1 (K), J1.2, J2.2, J3.2, J4.2, J5.1, J6.1, J6.2, J7.2, J10.2, R2.2, U1.GND1 (GND), U1.GND2 (GND), U1.GND3 (GND), U1.GND4 (GND), U1.GND5 (GND), U1.USB_GND1 (USB_GND), U1.USB_GND2 (USB_GND), U2.3 (PGND1), U2.4 (PGND1), U2.9 (PGND2), U2.10 (PGND2), U2.18 (GND), U3.2 (GND), U4.2 (GND)
L1: J5.3, U1.14 (A0)
L2: J6.3, U1.15 (A1)
unnamed: D1.2 (A), R1.2
unnamed: J2.3, R3.2
unnamed: J3.3, R4.2
unnamed: J4.3, R5.2
unnamed: J7.1, SW1.2 (B)
unnamed: J8.1, U2.1 (AO1), U2.2 (AO1)
unnamed: J8.2, U2.5 (AO2), U2.6 (AO2)
unnamed: J9.1, U2.11 (BO1), U2.12 (BO1)
unnamed: J9.2, U2.7 (BO2), U2.8 (BO2)
md1: U1.19 (A5)
md2: U1.20 (A6)
md3: U1.21 (A7)
md4: U1.22 (A8)
mdr1: U2.21 (AIN1)
mdr2: U2.22 (AIN2)
mdr3: U2.17 (BIN1)
mdr4: U2.16 (BIN2)
motorapwm: U1.6 (OUT1D), U2.23 (PWMA)
motorbpwm: U1.9 (OUT1C), U2.15 (PWMB)
s1: J1.3, R2.1, U1.5 (IN2)
s2: D3.2 (A), R3.1, U1.2 (OUT2)
s3: D4.2 (A), R4.1, U1.3 (LRCLK2)
s4: D5.2 (A), R5.1, U1.4 (BCLK2)
start: J10.1, U1.17 (A3)

Notes on the sheet:
led (just 1 lmao)
motor driver
power and decoupling
7 leds total: 1 for each distance sensor, 1 for on/off,1 for each motor
voltage regulator
