RoboJackets/robowrestling/ControlBoard/Kirbi/v2 pcb/Kirbi_ControlBoard_2.kicad_sch

## KiCad design ControlBoard/Kirbi/v2 pcb/Kirbi_ControlBoard_2.kicad_sch (2023-10-22)

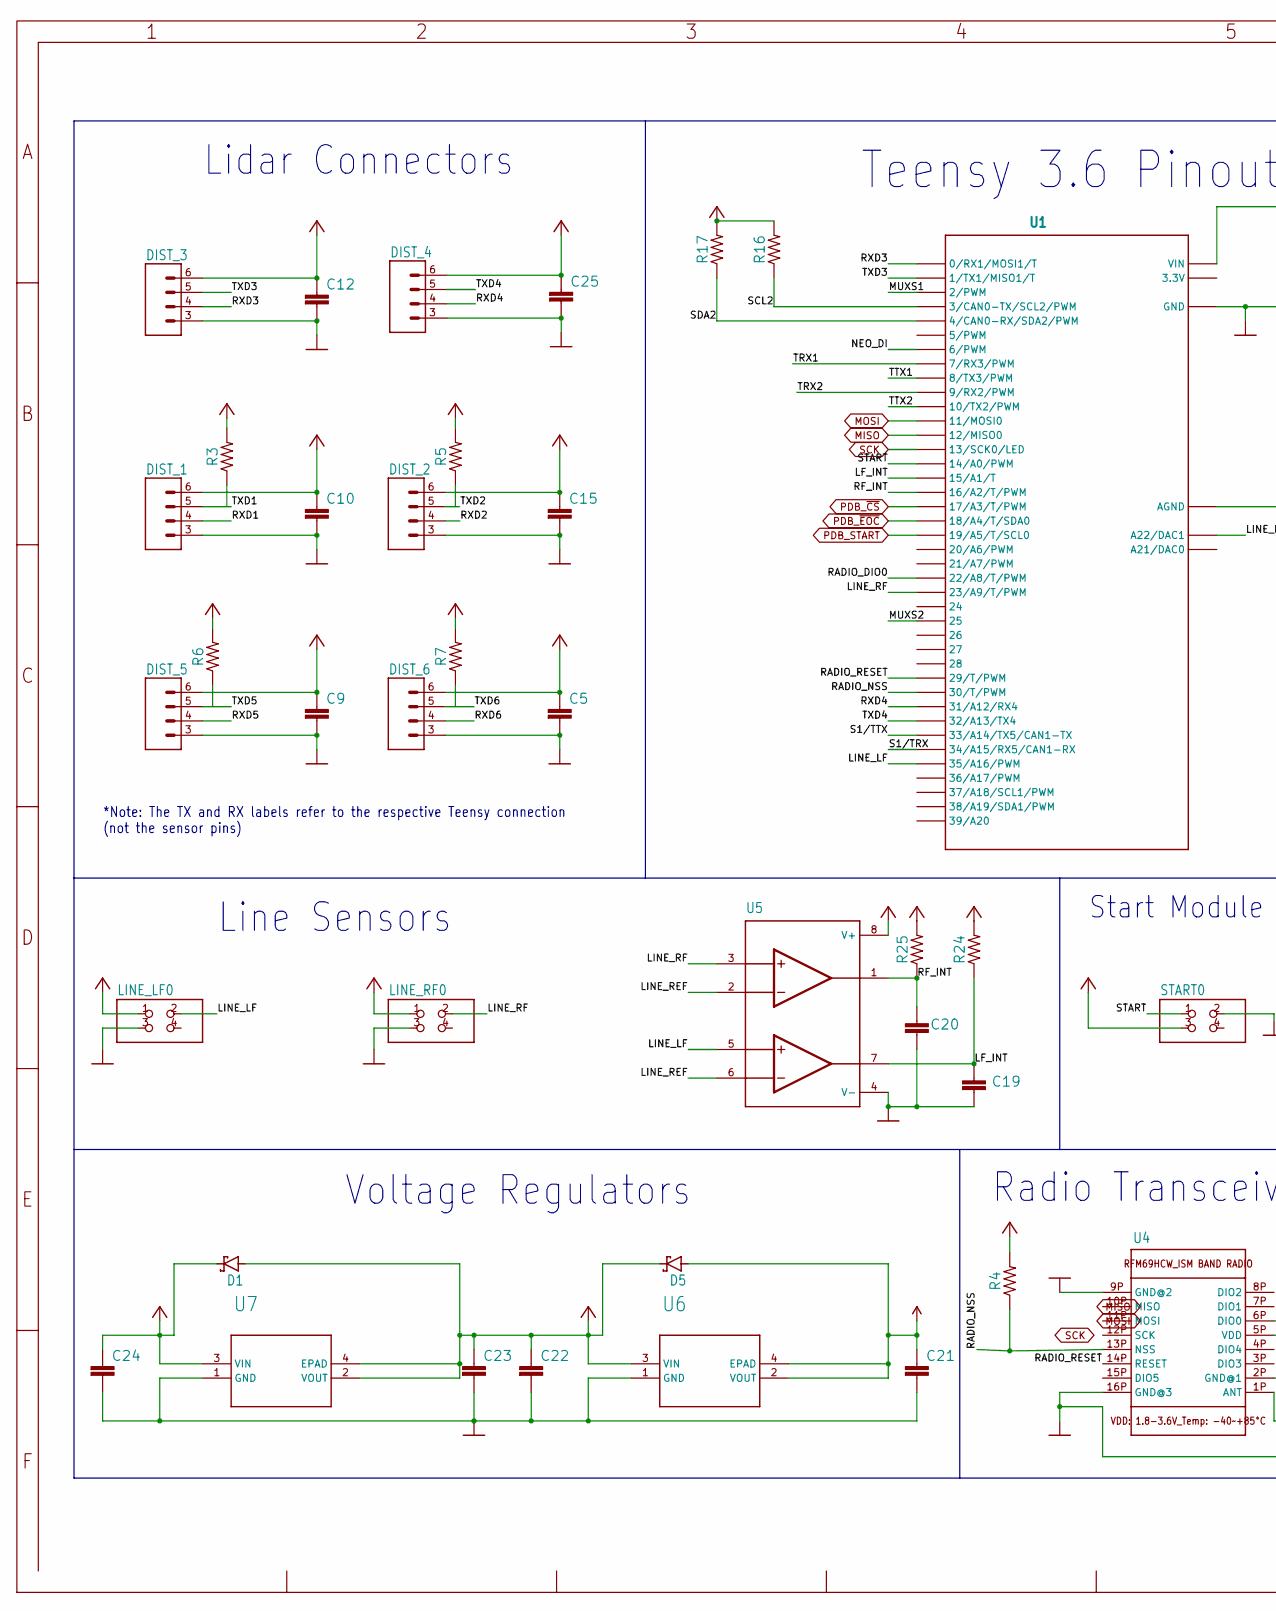
[picture p42: schematic Kirbi_ControlBoard_2.kicad_sch, part in row 1, column 1]

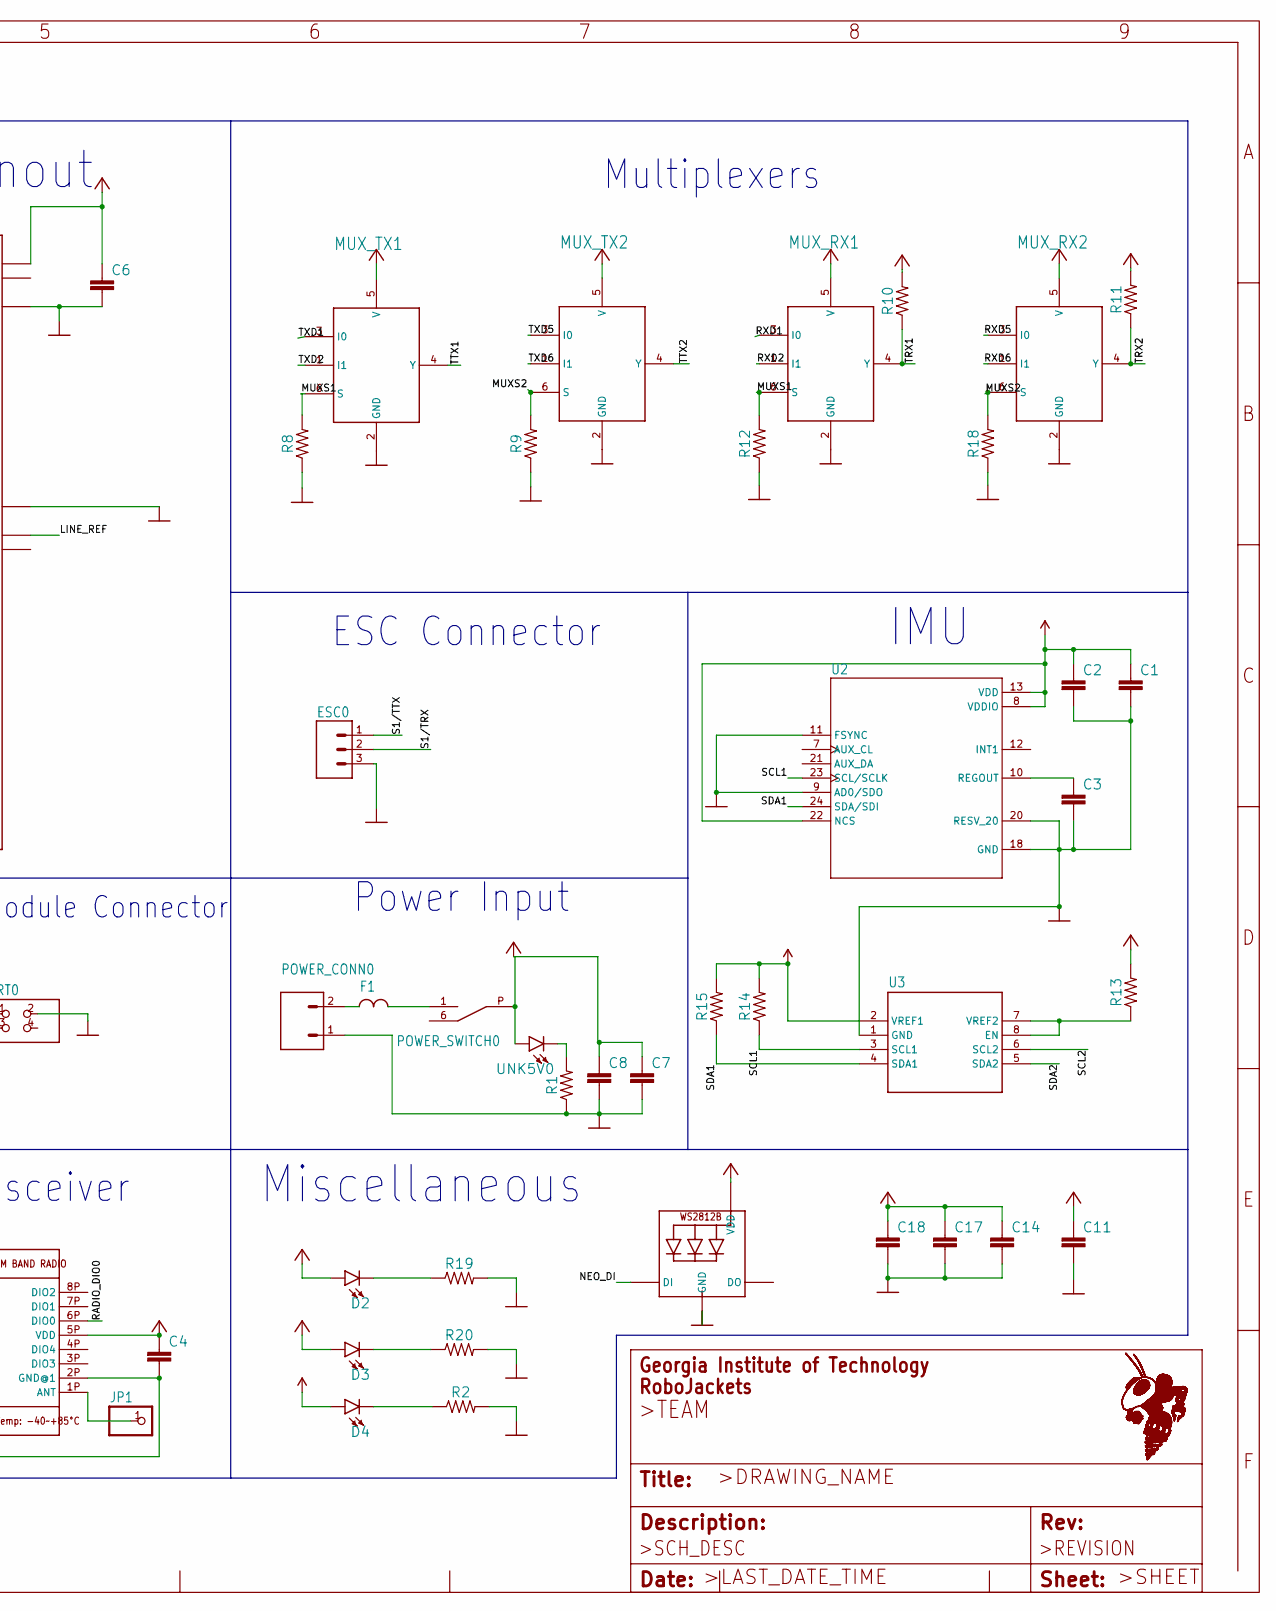
[picture p43: schematic Kirbi_ControlBoard_2.kicad_sch, part in row 1, column 2]

Parts:
C1, C2, C3, C4, C5, C6, C7, C8, C9, C10, C11, C12, C14, C15, C17, C18, C19, C20, C21, C22, C23, C24, C25: (no value)
D1, D2, D3, D4, D5: (no value)
DIST_1, DIST_2, DIST_3, DIST_4, DIST_5, DIST_6: (no value)
ESC0: (no value)
F1: (no value)
JP1: (no value)
LED1: (no value)
LINE_LF0: (no value)
LINE_RF0: (no value)
MUX_RX1, MUX_RX2: (no value)
MUX_TX1, MUX_TX2: (no value)
POWER_CONN0: (no value)
POWER_SWITCH0: (no value)
R1, R2, R3, R4, R5, R6, R7, R8, R9, R10, R11, R12, R13, R14, R15, R16, R17, R18, R19, R20, R24, R25: (no value)
START0: (no value)
U1, U2, U3, U4, U5, U6, U7: (no value)
UNK5V0: (no value)

Connections:
LF_INT: C19.1, R24.1, U1.15/A1 (15/A1/T), U5.7 (OUTB)
LINE_LF: LINE_LF0.2, U1.35/A16 (35/A16/PWM), U5.5 (INB+)
LINE_REF: U1.A22 (A22/DAC1), U5.2 (INA-), U5.6 (INB-)
LINE_RF: LINE_RF0.2, U1.23/A9 (23/A9/T/PWM), U5.3 (INA+)
MISO: U1.12 (12/MISO0)
MOSI: U1.11 (11/MOSI0)
MUXS1: MUX_RX1.6 (S), MUX_TX1.6 (S), R12.2, U1.2 (2/PWM)
MUXS2: MUX_RX2.6 (S), MUX_TX2.6 (S), R9.2, R18.2, U1.25
NEO_DI: LED1.4-DIN (DI), U1.6 (6/PWM)
unnamed: C1.1, C1.2, C2.1, C2.2, C3.2, C4.1, C4.2, C5.1, C5.2, C6.1, C6.2, C7.1, C7.2, C8.1, C8.2, C9.1, C9.2, C10.1, C10.2, C11.1, C11.2, C12.1, C12.2, C14.1, C14.2, C15.1, C15.2, C17.1, C17.2, C18.1, C18.2, C19.2, C20.2, C21.1, C21.2, C22.1, C22.2, C23.1, C23.2, C24.1, C24.2, C25.1, C25.2, D1.1 (A), D1.2 (C), D2.A, D3.A, D4.A, D5.1 (A), D5.2 (C), DIST_1.3 (1), DIST_1.6 (4), DIST_2.3 (1), DIST_2.6 (4), DIST_3.3 (1), DIST_3.6 (4), DIST_4.3 (1), DIST_4.6 (4), DIST_5.3 (1), DIST_5.6 (4), DIST_6.3 (1), DIST_6.6 (4), ESC0.3 (1), LED1.1-VDD (VDD), LED1.3-GND (GND), LINE_LF0.1, LINE_LF0.3, LINE_RF0.1, LINE_RF0.3, MUX_RX1.2 (GND), MUX_RX1.5 (V), MUX_RX2.2 (GND), MUX_RX2.5 (V), MUX_TX1.2 (GND), MUX_TX1.5 (V), MUX_TX2.2 (GND), MUX_TX2.5 (V), POWER_CONN0.1, R1.1, R2.2, R3.2, R4.2, R5.2, R6.2, R7.2, R8.1, R9.1, R10.2, R11.2, R12.1, R13.2, R14.2, R15.2, R16.2, R17.2, R18.1, R19.2, R20.2, R24.2, R25.2, START0.2, START0.3, U1.AGND, U1.GND, U1.GND1 (GND), U1.VIN, U2.8 (VDDIO), U2.9 (AD0/SDO), U2.11 (FSYNC), U2.13 (VDD), U2.18 (GND), U2.20 (RESV_20), U2.22 (NCS), U3.1 (GND), U3.2 (VREF1), U4.2P (GND@1), U4.5P (VDD), U4.9P (GND@2), U4.16P (GND@3), U5.4 (V-), U5.8 (V+), U6.1 (GND), U6.2 (VOUT), U6.3 (VIN), U6.4 (EPAD), U7.1 (GND), U7.2 (VOUT), U7.3 (VIN), U7.4 (EPAD)
unnamed: C3.1, U2.10 (REGOUT)
unnamed: D2.C, R19.1
unnamed: D3.C, R20.1
unnamed: D4.C, R2.1
unnamed: F1.1, POWER_CONN0.2
unnamed: F1.2, POWER_SWITCH0.1 (B)
unnamed: JP1.1, U4.1P (ANT)
unnamed: POWER_SWITCH0.P (COMMON), UNK5V0.A
unnamed: R1.2, UNK5V0.C
unnamed: R13.1, U3.7 (VREF2), U3.8 (EN)
unnamed: U1.3.3V, U1.3.3V3 (3.3V)
PDB_START: U1.19/A5 (19/A5/T/SCL0)
PDB_~CS: U1.17/A3 (17/A3/T/PWM)
PDB_~EOC: U1.18/A4 (18/A4/T/SDA0)
RADIO_DIO0: U1.22/A8 (22/A8/T/PWM), U4.6P (DIO0)
RADIO_NSS: R4.1, U1.30 (30/T/PWM), U4.13P (NSS)
RADIO_RESET: U1.29 (29/T/PWM), U4.14P (RESET)
RF_INT: C20.1, R25.1, U1.16/A2 (16/A2/T/PWM), U5.1 (OUTA)
RXD1: DIST_1.4 (2), MUX_RX1.3 (I0)
RXD2: DIST_2.4 (2), MUX_RX1.1 (I1)
RXD3: DIST_3.4 (2), U1.0 (0/RX1/MOSI1/T)
RXD4: DIST_4.4 (2), U1.31/A12 (31/A12/RX4)
RXD5: DIST_5.4 (2), MUX_RX2.3 (I0)
RXD6: DIST_6.4 (2), MUX_RX2.1 (I1)
S1/TRX: ESC0.2, U1.34/A15 (34/A15/RX5/CAN1-RX)
S1/TTX: ESC0.1 (3), U1.33/A14 (33/A14/TX5/CAN1-TX)
SCK: U1.13 (13/SCK0/LED)
SCL1: R14.1, U2.23 (SCL/SCLK), U3.3 (SCL1)
SCL2: R16.1, U1.3 (3/CAN0-TX/SCL2/PWM), U3.6 (SCL2)
SDA1: R15.1, U2.24 (SDA/SDI), U3.4 (SDA1)
SDA2: R17.1, U1.4 (4/CAN0-RX/SDA2/PWM), U3.5 (SDA2)
START: START0.1, U1.14/A0 (14/A0/PWM)
TRX1: MUX_RX1.4 (Y), R10.1, U1.7 (7/RX3/PWM)
TRX2: MUX_RX2.4 (Y), R11.1, U1.9 (9/RX2/PWM)
TTX1: MUX_TX1.4 (Y), U1.8 (8/TX3/PWM)
TTX2: MUX_TX2.4 (Y), U1.10 (10/TX2/PWM)
TXD1: DIST_1.5 (3), MUX_TX1.3 (I0)
TXD2: DIST_2.5 (3), MUX_TX1.1 (I1)
TXD3: DIST_3.5 (3), U1.1 (1/TX1/MISO1/T)
TXD4: DIST_4.5 (3), U1.32/A13 (32/A13/TX4)
TXD5: DIST_5.5 (3), MUX_TX2.3 (I0)
TXD6: DIST_6.5 (3), MUX_TX2.1 (I1)

Notes on the sheet:
Power Input
Teensy 3.6 Pinout
IMU
Line Sensors
Voltage Regulators
*Note: The TX and RX labels refer to the respective Teensy connection (not the sensor pins)
Lidar Connectors
Start Module Connector
Multiplexers
Radio Transceiver
ESC Connector
Miscellaneous
