RoboJackets/robowrestling/3kg/Monki/10.20_Peter/Team2(10-17)/Team2(10-17).kicad_sch

## KiCad design 3kg/Monki/10.20_Peter/Team2(10-17)/Team2(10-17).kicad_sch (2024-10-20)

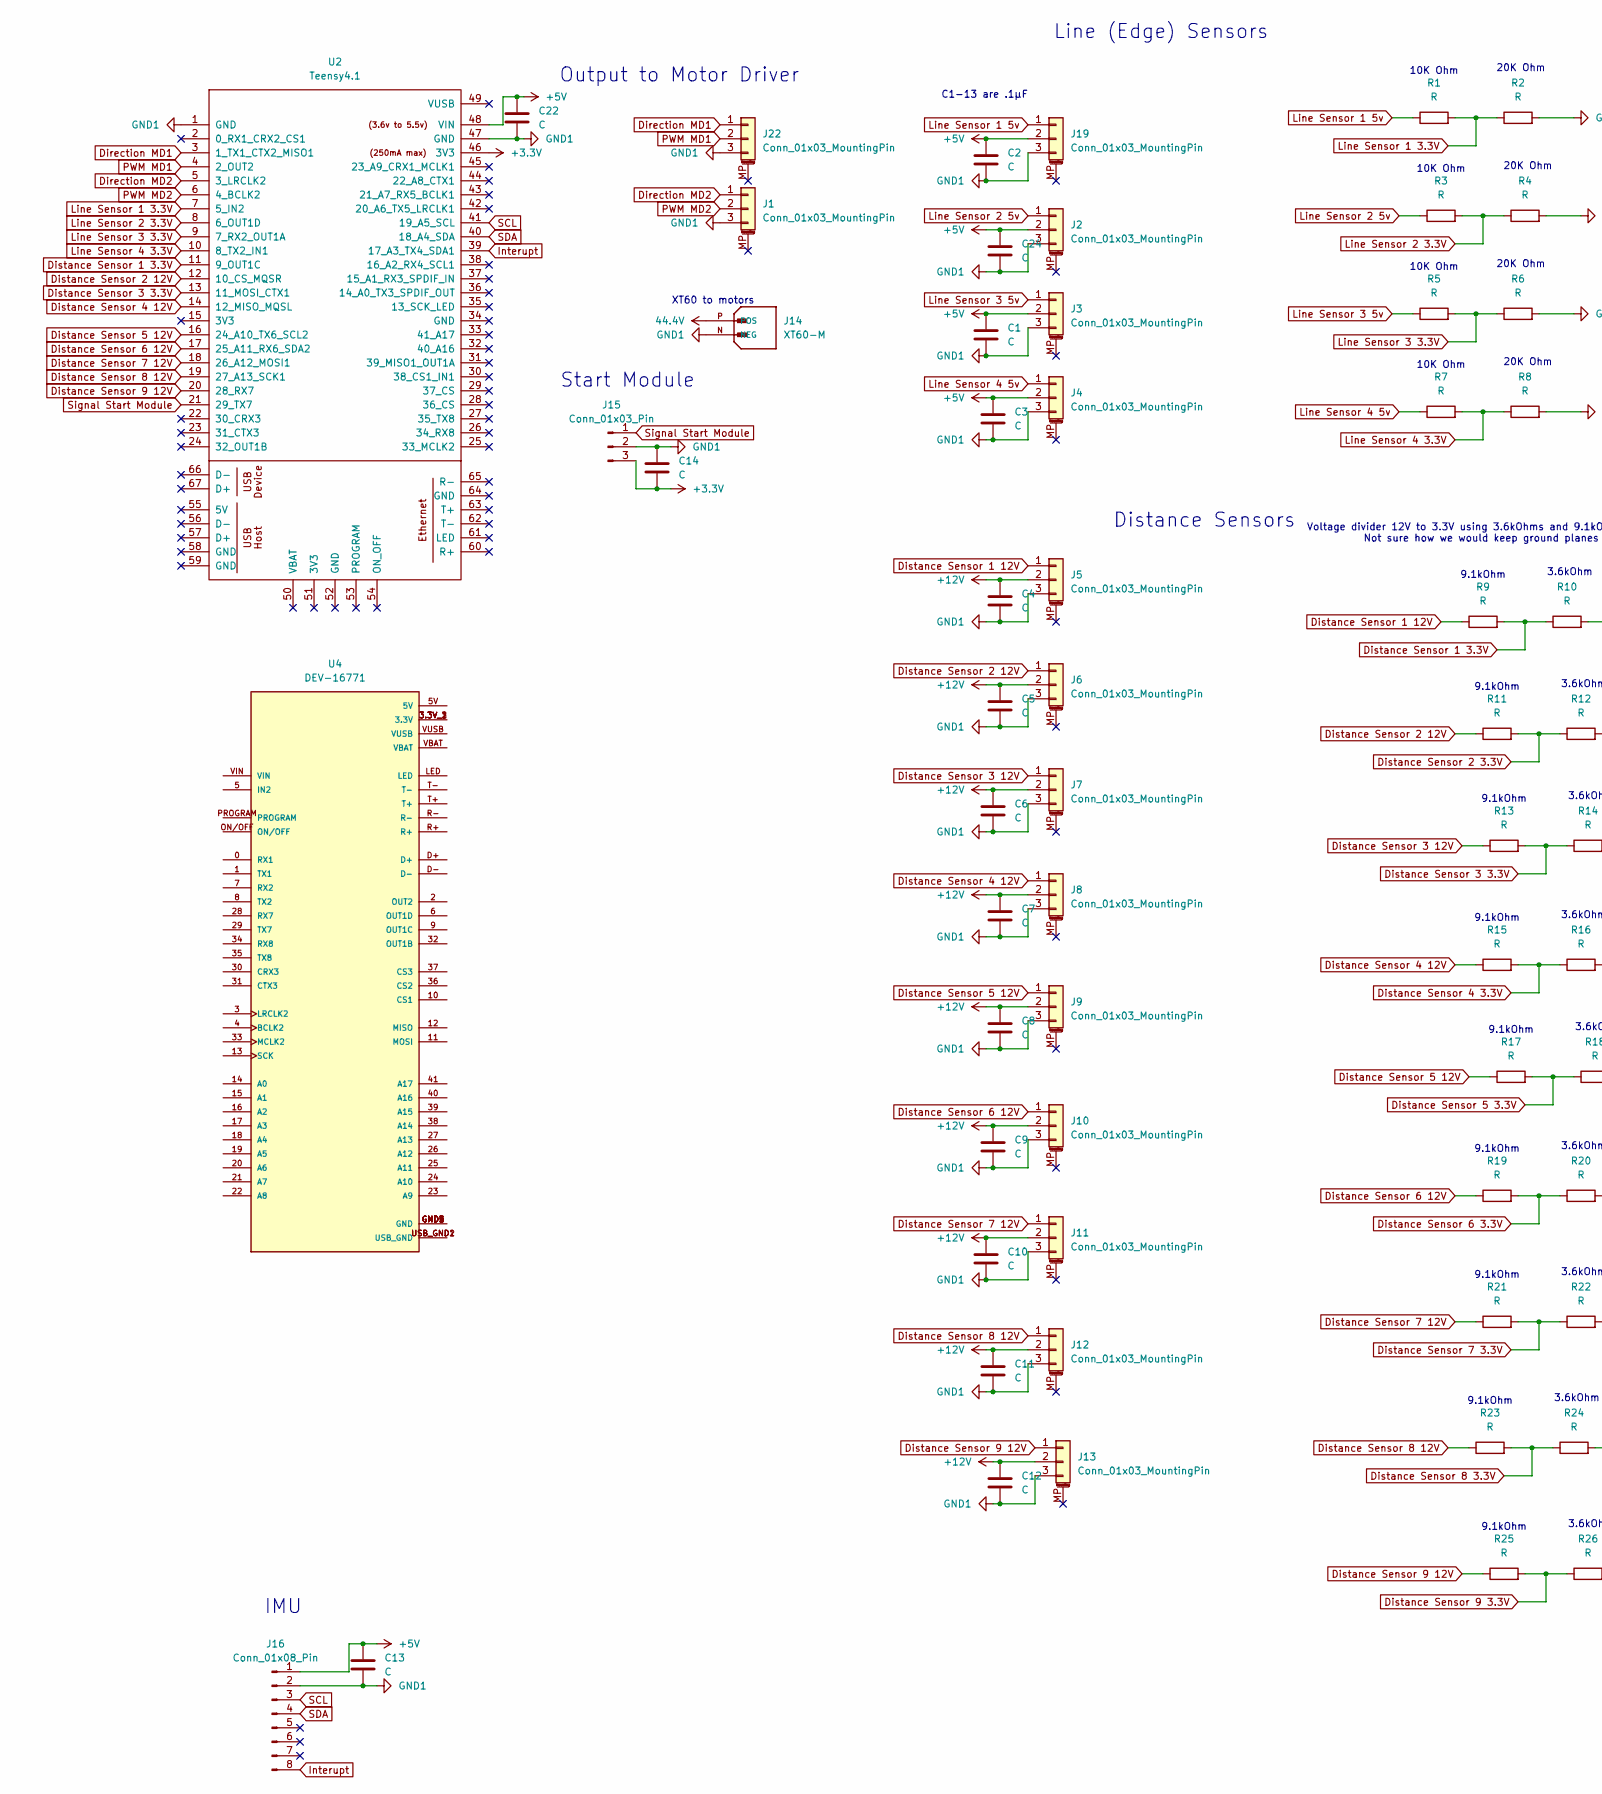
[picture p44: schematic Team2(10-17).kicad_sch, part in row 1, column 1]

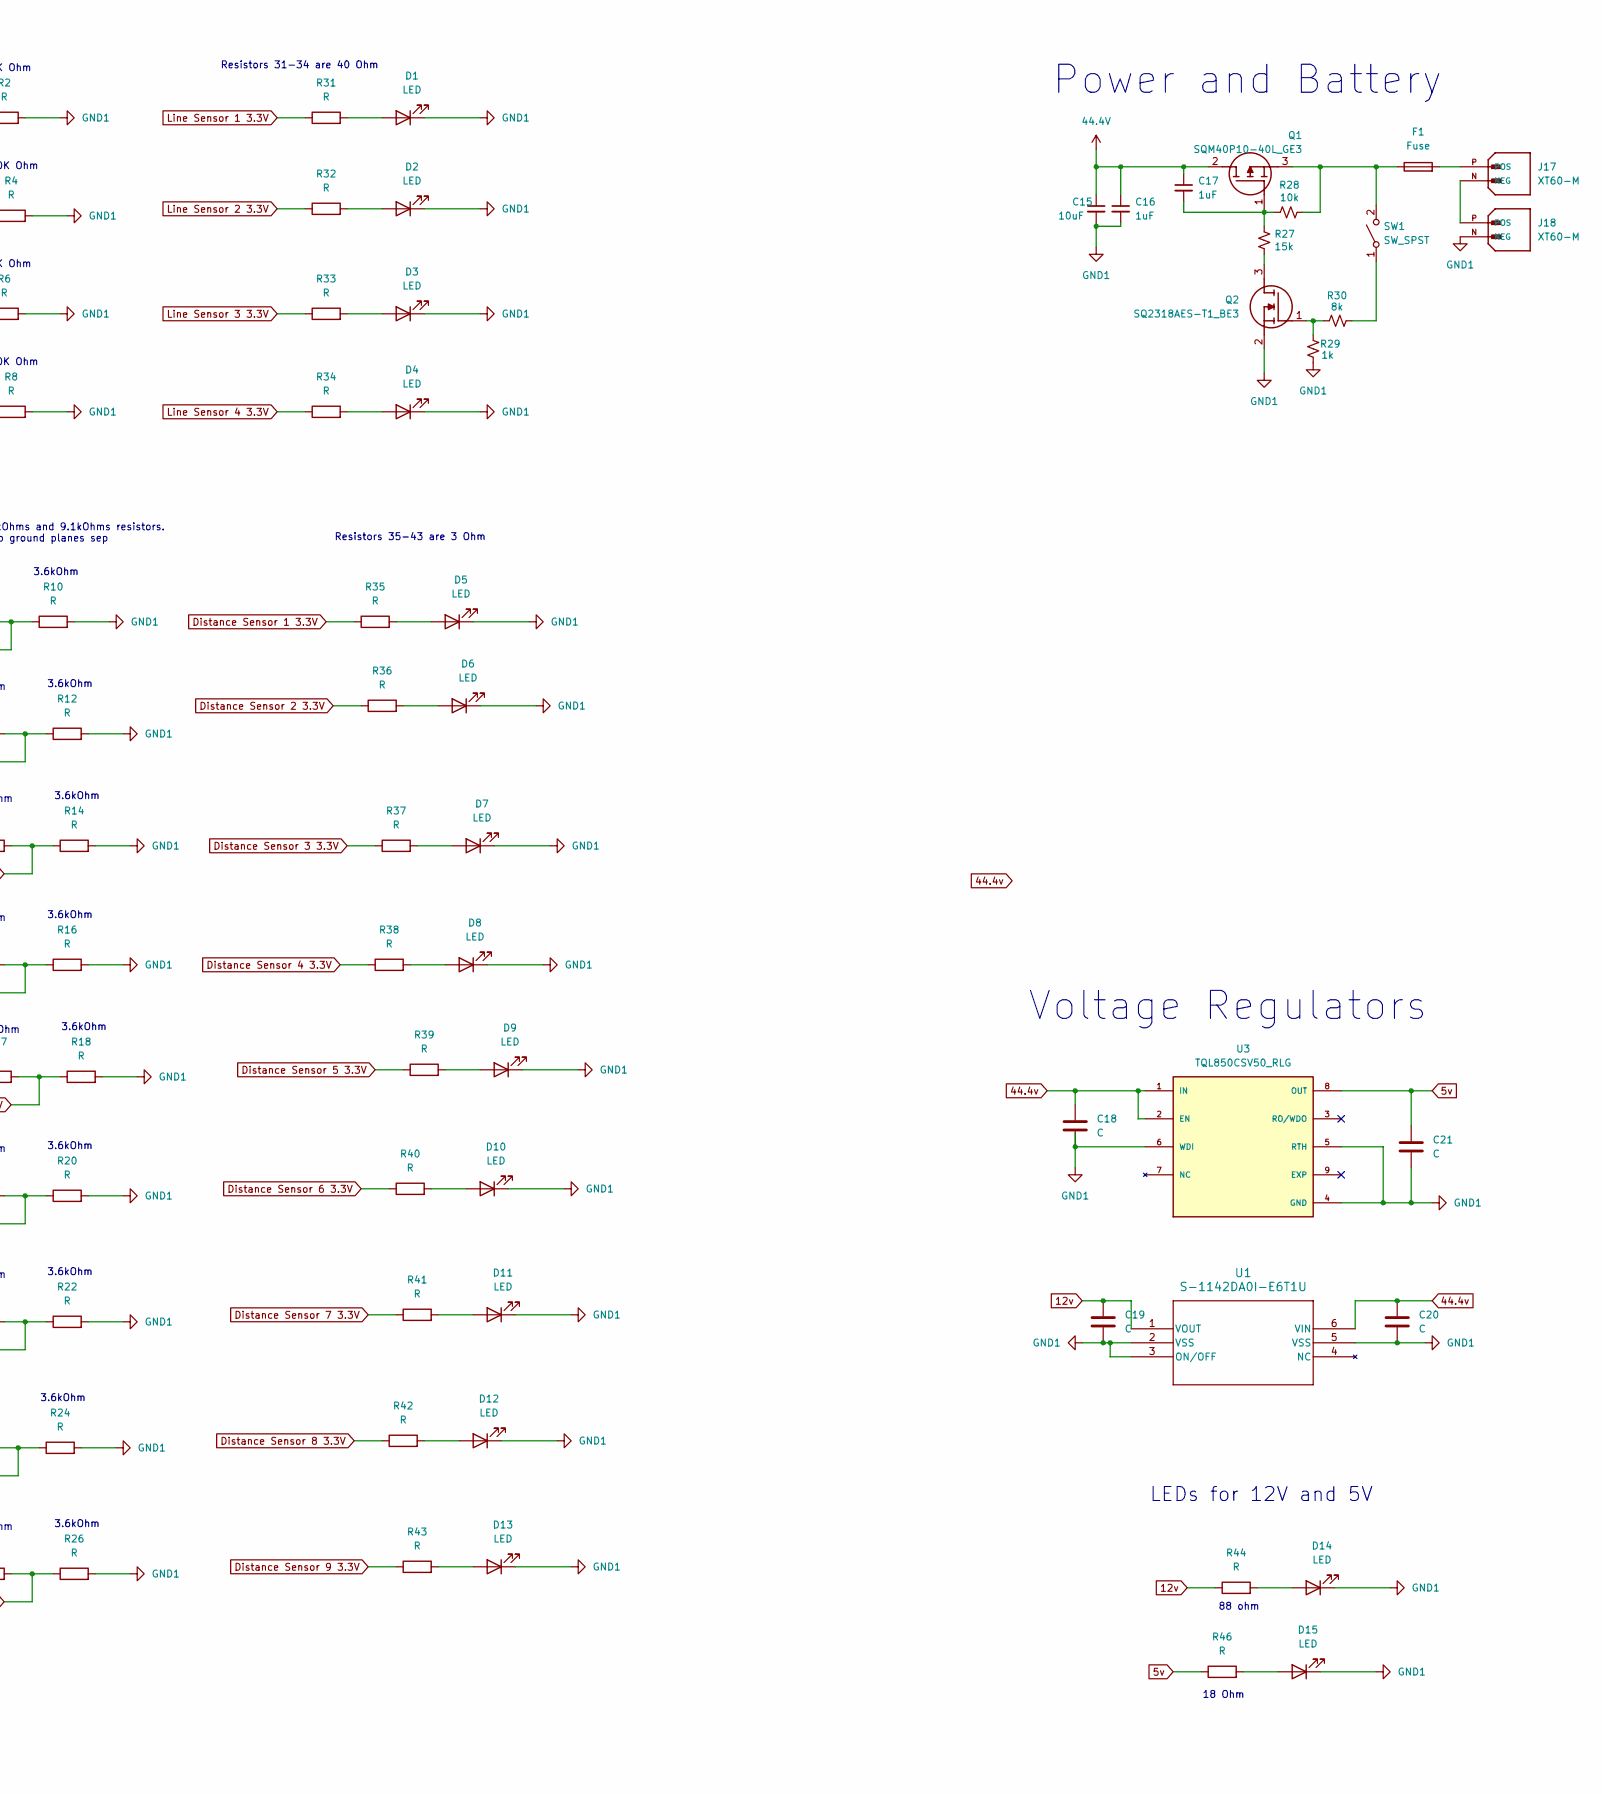
[picture p45: schematic Team2(10-17).kicad_sch, part in row 1, column 2]

Parts:
C1, C2, C3, C4, C5, C6, C7, C8, C9, C10, C11, C12, C13, C14, C18, C19, C20, C21, C22, C24: C; C_0603_1608Metric_Pad1.08x0.95mm_HandSolder
C15: 10uF; C_0805_2012Metric_Pad1.18x1.45mm_HandSolder
C16, C17: 1uF; C_0805_2012Metric_Pad1.18x1.45mm_HandSolder
D1, D2, D3, D4, D5, D6, D7, D8, D9, D10, D11, D12, D13, D14, D15: LED; LED_0603_1608Metric_Pad1.05x0.95mm_HandSolder
F1: Fuse; 0456050.DRSD
J1, J2, J3, J4, J5, J6, J7, J8, J9, J10, J11, J12, J13, J19, J22: Conn_01x03_MountingPin; JST_B3B-XH-A_LF__SN_
J14, J17, J18: XT60-M; AMASS_XT60-M; PARTREV V1.2
J15: Conn_01x03_Pin; FanPinHeader_1x03_P2.54mm_Vertical
J16: Conn_01x08_Pin; PinHeader_1x06_P2.54mm_Vertical
Q1: SQM40P10-40L_GE3; S1142A50IE6T1U; Mouser Part Number 78-SQM40P10-40L_GE3
Q2: SQ2318AES-T1_BE3; NMOSGSD_SOT-23_TO-236_VIS-M; Mouser Part Number 78-SQ2318AES-T1_BE3
R1, R2, R3, R4, R5, R6, R7, R8, R9, R10, R11, R12, R13, R14, R15, R16, R17, R18, R19, R20, R21, R22, R23, R24, R25, R26, R31, R32, R33, R34, R35, R36, R37, R38, R39, R40, R41, R42, R43, R44: R; R_0603_1608Metric_Pad0.98x0.95mm_HandSolder
R27: 15k; R_0805_2012Metric_Pad1.20x1.40mm_HandSolder
R28: 10k; R_0805_2012Metric_Pad1.20x1.40mm_HandSolder
R29: 1k; R_0805_2012Metric_Pad1.20x1.40mm_HandSolder
R30: 8k; R_0805_2012Metric_Pad1.20x1.40mm_HandSolder
R46: R; R_1206_3216Metric_Pad1.30x1.75mm_HandSolder
SW1: SW_SPST; SW_G-107-0513
U1: S-1142DA0I-E6T1U; S1142A50IE6T1U
U2: Teensy4.1; Teensy41 (1)
U3: TQL850CSV50_RLG; SOIC127P600X170-9N; PARTREV A2206
U4: DEV-16771; MODULE_DEV-16771; PARTREV 4.1

Connections:
5v: C21.1, R46.1, U3.8 (OUT)
12v: C19.1, R44.1, U1.1 (VOUT)
44.4v: C15.1, C16.1, C17.1, C18.1, C20.1, J14.P (POS), Q1.2 (D), U1.6 (VIN), U3.1 (IN), U3.2 (EN)
+3.3V: C14.2, J15.3, U2.46 (3V3)
+5V: C1.1, C2.1, C3.1, C13.1, C22.1, C24.1, J2.2, J3.2, J4.2, J16.1, J19.2, U2.48 (VIN)
+12V: C4.1, C5.1, C6.1, C7.1, C8.1, C9.1, C10.1, C11.1, C12.1, J5.2, J6.2, J7.2, J8.2, J9.2, J10.2, J11.2, J12.2, J13.2
Direction MD1: J22.1, U2.3 (1_TX1_CTX2_MISO1)
Direction MD2: J1.1, U2.5 (3_LRCLK2)
Distance Sensor 1 3.3V: R9.2, R10.1, R35.1, U2.11 (9_OUT1C)
Distance Sensor 1 12V: J5.1, R9.1
Distance Sensor 2 3.3V: R11.2, R12.1, R36.1
Distance Sensor 2 12V: J6.1, R11.1, U2.12 (10_CS_MQSR)
Distance Sensor 3 3.3V: R13.2, R14.1, R37.1, U2.13 (11_MOSI_CTX1)
Distance Sensor 3 12V: J7.1, R13.1
Distance Sensor 4 3.3V: R15.2, R16.1, R38.1
Distance Sensor 4 12V: J8.1, R15.1, U2.14 (12_MISO_MQSL)
Distance Sensor 5 3.3V: R17.2, R18.1, R39.1
Distance Sensor 5 12V: J9.1, R17.1, U2.16 (24_A10_TX6_SCL2)
Distance Sensor 6 3.3V: R19.2, R20.1, R40.1
Distance Sensor 6 12V: J10.1, R19.1, U2.17 (25_A11_RX6_SDA2)
Distance Sensor 7 3.3V: R21.2, R22.1, R41.1
Distance Sensor 7 12V: J11.1, R21.1, U2.18 (26_A12_MOSI1)
Distance Sensor 8 3.3V: R23.2, R24.1, R42.1
Distance Sensor 8 12V: J12.1, R23.1, U2.19 (27_A13_SCK1)
Distance Sensor 9 3.3V: R25.2, R26.1, R43.1
Distance Sensor 9 12V: J13.1, R25.1, U2.20 (28_RX7)
GND1: C1.2, C2.2, C3.2, C4.2, C5.2, C6.2, C7.2, C8.2, C9.2, C10.2, C11.2, C12.2, C13.2, C14.1, C15.2, C16.2, C18.2, C19.2, C20.2, C21.2, C22.2, C24.2, D1.1 (K), D2.1 (K), D3.1 (K), D4.1 (K), D5.1 (K), D6.1 (K), D7.1 (K), D8.1 (K), D9.1 (K), D10.1 (K), D11.1 (K), D12.1 (K), D13.1 (K), D14.1 (K), D15.1 (K), J1.3, J2.3, J3.3, J4.3, J5.3, J6.3, J7.3, J8.3, J9.3, J10.3, J11.3, J12.3, J13.3, J14.N (NEG), J15.2, J16.2, J18.N (NEG), J19.3, J22.3, Q2.2 (S), R2.2, R4.2, R6.2, R8.2, R10.2, R12.2, R14.2, R16.2, R18.2, R20.2, R22.2, R24.2, R26.2, R29.2, U1.2 (VSS), U1.3 (ON/OFF), U1.5 (VSS), U2.1 (GND), U2.47 (GND), U3.4 (GND), U3.5 (RTH), U3.6 (WDI)
Interupt: J16.8, U2.39 (17_A3_TX4_SDA1)
Line Sensor 1 3.3V: R1.2, R2.1, R31.1, U2.7 (5_IN2)
Line Sensor 1 5v: J19.1, R1.1
Line Sensor 2 3.3V: R3.2, R4.1, R32.1, U2.8 (6_OUT1D)
Line Sensor 2 5v: J2.1, R3.1
Line Sensor 3 3.3V: R5.2, R6.1, R33.1, U2.9 (7_RX2_OUT1A)
Line Sensor 3 5v: J3.1, R5.1
Line Sensor 4 3.3V: R7.2, R8.1, R34.1, U2.10 (8_TX2_IN1)
Line Sensor 4 5v: J4.1, R7.1
unnamed: C17.2, Q1.1 (G), R27.1, R28.1
unnamed: D1.2 (A), R31.2
unnamed: D2.2 (A), R32.2
unnamed: D3.2 (A), R33.2
unnamed: D4.2 (A), R34.2
unnamed: D5.2 (A), R35.2
unnamed: D6.2 (A), R36.2
unnamed: D7.2 (A), R37.2
unnamed: D8.2 (A), R38.2
unnamed: D9.2 (A), R39.2
unnamed: D10.2 (A), R40.2
unnamed: D11.2 (A), R41.2
unnamed: D12.2 (A), R42.2
unnamed: D13.2 (A), R43.2
unnamed: D14.2 (A), R44.2
unnamed: D15.2 (A), R46.2
unnamed: F1.1, Q1.3 (S), R28.2, SW1.2 (B)
unnamed: F1.2, J17.P (POS)
unnamed: J17.N (NEG), J18.P (POS)
unnamed: Q2.1 (G), R29.1, R30.1
unnamed: Q2.3 (D), R27.2
unnamed: R30.2, SW1.1 (A)
unnamed: U4.3.3V_1 (3.3V), U4.3.3V_2 (3.3V), U4.3.3V_3 (3.3V)
unnamed: U4.GND1 (GND), U4.GND2 (GND), U4.GND3 (GND), U4.GND4 (GND), U4.GND5 (GND)
unnamed: U4.USB_GND1 (USB_GND), U4.USB_GND2 (USB_GND)
PWM MD1: J22.2, U2.4 (2_OUT2)
PWM MD2: J1.2, U2.6 (4_BCLK2)
SCL: J16.3, U2.41 (19_A5_SCL)
SDA: J16.4, U2.40 (18_A4_SDA)
Signal Start Module: J15.1, U2.21 (29_TX7)

Notes on the sheet:
Resistors 31-34 are 40 Ohm
Output to Motor Driver
3.6kOhm
9.1kOhm
20K Ohm
Power and Battery
Resistors 35-43 are 3 Ohm
18 Ohm
Start Module
Voltage Regulators
IMU
10K Ohm
Distance Sensors
XT60 to motors
C1-13 are .1µF
LEDs for 12V and 5V
88 ohm
Voltage divider 12V to 3.3V using 3.6kOhms and 9.1kOhms resistors. Not sure how we would keep ground planes sep
Line (Edge) Sensors
