RoboJackets/robowrestling/(commit log)

2023-10-22 timmi CB
    [75869-130LF.step, Kirbi_ControlBoard_2.kicad_sch, Kirbi_ControlBoard_3.kicad_sch, rwTimmiCB.kicad_pcb, rwTimmiCB.kicad_sch]
2024-02-18 Added battery connection stuff and chose BMI323 as IMU
    [rwTimmiCB.kicad_sch]
2024-02-23 added voltage regulators to timmi cb
    [rwTimmiCB.kicad_sch]
2024-02-26 added power switch circuit
    [rwTimmiCB.kicad_sch]
2024-03-03 wired imu and added ir indicators
    [rwTimmiCB.kicad_sch]
2024-05-23 added load switch values
    [rwTimmiCB.kicad_sch]
2024-05-23 added load switch resistor vals
    [powerswitch.ms14, rj_loadswitch_sim.ms14]
2024-06-07 Create cad
2024-06-12 joes magic
    [Skibid-i.kicad_sch]
2024-06-27 motor driver
    [Skibid-i.kicad_sch, Skibidi-Motordriver.kicad_pcb, Skibidi-Motordriver.kicad_sch]
2024-06-28 schematic is pretty muchdone
    [Skibid-i.kicad_sch]
2024-07-11 added foortprints
    [Skibid-i.kicad_sch]
2024-07-18 finished fooorptinrt
    [Skibid-i.kicad_pcb, Skibid-i.kicad_sch]
2024-08-02 sum motor driver stuff
    [Skibidi-Motordriver.kicad_sch]
2024-08-20 finished motordriver layout
    [Skibidi-Motordriver.kicad_pcb, Skibidi-Motordriver.kicad_sch]
2024-08-20 Layout Progress
    [Skibid-i.kicad_pcb]
2024-08-20 progress on layout
    [Skibid-i.kicad_pcb, Skibid-i.kicad_sch, Skibidi-Motordriver.kicad_pcb, Skibidi-Motordriver.kicad_sch]
2024-08-20 finish motor driver
    [Skibidi-Motordriver.kicad_pcb, Skibidi-Motordriver.kicad_sch]
2024-08-25 mode select
    [Skibid-i.kicad_sch]
2024-08-29 more stuff
    [Skibid-i.kicad_sch]
2024-09-06 added bigass capcacitor
    [Skibid-i.kicad_pcb, Skibid-i.kicad_sch, Skibidi-Motordriver.kicad_pcb, Skibidi-Motordriver.kicad_sch]
2024-09-20 fixing footpriints
    [Skibid-i.kicad_sch]
2024-09-20 added motor driver schematic
2024-09-20 differentiated between motor drivers
    [Sp-I.kicad_sch]
2024-09-20 added power
    [Sp-I.kicad_sch]
2024-09-20 updated footprints
    [Skibid-i.kicad_pcb, Skibid-i.kicad_sch]
2024-09-20 layuot work
    [Skibid-i.kicad_pcb, Skibid-i.kicad_sch]
2024-09-22 almost done with layout idk bout the level shifter though
    [Skibid-i.kicad_pcb, Skibid-i.kicad_sch]
2024-09-22 Finished Layout Draft
    [Skibid-i.kicad_pcb]
2024-09-22 layout done
    [Skibid-i.kicad_pcb, Skibid-i.kicad_sch]
2024-09-22 motor driver shhrinking
    [Skibid-i.kicad_sch, Skibidi-Motordriver.kicad_pcb]
2024-09-22 adding monki project
    yes
    [team2 try 2.kicad_pcb, team2 try 2.kicad_sch]
2024-09-22 name change from try 2 to electrical
    [team2 try 2.kicad_pcb, team2 try 2.kicad_sch]
2024-09-22 Revert "name change from try 2 to electrical"
    This reverts commit 4b0ac75f3448ba7783e69cfdcc4d947f7fd3a45a.
    [team2 try 2.kicad_pcb, team2 try 2.kicad_sch]
2024-09-27 ig im done
    [Skibid-i.kicad_pcb, Skibid-i.kicad_sch]
2024-09-27 erm what the sigma
    [Skibid-i.kicad_pcb]
2024-09-28 erm what the skibidi
    [Skibid-i.kicad_sch]
2024-09-28 sigma moves
    [Skibid-i.kicad_pcb]
2024-09-28 i feel so skibidi rn
    [Skibidipower.kicad_pcb, Skibidipower.kicad_sch]
2024-09-28 skibidi rizz
    [Skibidipower.kicad_pcb]
2024-09-28 power board done
    [Skibid-i.kicad_pcb, Skibid-i.kicad_sch]
2024-09-28 skibidi power
    [Skibid-i.kicad_pcb, Skibid-i.kicad_sch, Skibidipower.kicad_pcb, Skibidipower.kicad_sch]
2024-09-29 added some footprints
    [team2 try 2.kicad_pcb, team2 try 2.kicad_sch]
2024-10-04 fanum taxed
    fixed connection issue + added label
    [Skibid-i.kicad_pcb, Skibid-i.kicad_sch]
2024-10-04 push tuah
    finished labeling control board
    [Skibid-i.kicad_pcb]
2024-10-04 joe skibidi deez nus
    [Skibidipower.kicad_pcb, Skibidipower.kicad_sch]
2024-10-04 sigma fanum
    [Skibid-i.kicad_pcb, Skibid-i.kicad_sch, Skibidipower.kicad_pcb]
2024-10-06 done with contrl board
    [Skibid-i.kicad_pcb, Skibid-i.kicad_sch]
2024-10-06 i thiknk its done
    [Skibidipower.kicad_pcb, Skibidipower.kicad_sch]
2024-10-06 Added Logo
    [Skibid-i.kicad_pcb]
2024-10-17 Added screw holes on control board
    [Skibid-i.kicad_pcb]
2024-10-28 Added KiCAD stuff
    pcb and sch
    [Schematic.kicad_pcb, Schematic.kicad_sch]
2024-11-03 think its done
    [Skibid-i.kicad_pcb, Skibid-i.kicad_sch]
2024-11-13 Updated Rata2i schematic
    Now with more stuff! And 1 (one) LED
    [Schematic.kicad_sch]
2024-11-15 Updated Rata2i (thrilling sequel)
    [Schematic.kicad_sch]
2024-11-15 Add electircal schematic
    [Zesti.kicad_pcb, Zesti.kicad_sch]
2024-12-19 some final changese
    [Skibid-i.kicad_pcb, Skibid-i.kicad_sch]
2024-12-29 ferrarii schematic added, still need to reassign pins for convenience
    [Ferrarii.kicad_pcb]
2025-01-01 schematic is done
2025-01-05 added footprints to ferrarii
2025-01-05 updated pcb from schematic, transferring files from laptop to pc
    [Ferrarii.kicad_pcb]
2025-01-06 ferrarii stuff placed, not wired
    [Ferrarii.kicad_pcb]
2025-01-31 new thingy
    [Schematic.kicad_pcb, Schematic.kicad_sch]
2025-01-31 cleaning up for you guys
    [Schematic.kicad_pcb]
2025-02-02 pcb??
    did we do it guys
    [Schematic.kicad_pcb, Schematic.kicad_sch]
2025-02-02 PCB!!!!!
    dont worry about the 2 errors its done
    [Schematic.kicad_pcb, Schematic.kicad_sch]
2025-02-07 Surprise in graphics
    [Schematic.kicad_pcb]
2025-02-09 done???????
    yeah
    [Schematic.kicad_pcb]
2025-02-09 done!!
    no more drawings i pinky promise nonemore
    [Schematic.kicad_pcb]
2025-02-09 pcb (actual) (done)
    yippeee
2025-06-23 ferarrii schematic draft 1
2025-06-30 custom ml2s
    [CustomML2-B_Cu.gbl, CustomML2-B_Mask.gbs, CustomML2-B_Paste.gbp, CustomML2-B_Silkscreen.gbo, CustomML2-Edge_Cuts.gm1, CustomML2-F_Cu.gtl, CustomML2-F_Mask.gts, CustomML2-F_Paste.gtp]
2025-07-09 added footprints, fixed schematic
    [Ferrarii.kicad_pcb]
2025-07-14 fixed power ferarri
2025-07-15 initial pcb layout, improvements needed and no wiring and no xander waifu
    [Ferrarii.kicad_pcb]
2025-07-22 pcb layout and wiring is done! still need to add silkscreen and xander waifu
    [CustomML2.step, Ferrarii.kicad_pcb]
2025-07-27 ml2 push for xandie wandie
    [CustomML2.kicad_pcb]
2025-07-29 custom ml2 update for xandie wandie, moved resistors to same side as sensor and removed notches from screw hole
    [CustomML2.kicad_pcb, CustomML2.kicad_sch]
2025-07-30 added necessary silkscreen to control pcb, still need to put the less necessary silkscreen
    [Ferrarii.kicad_pcb]
2025-08-04 i think ferarrii pcb is done
    [Ferrarii.kicad_pcb]
2025-08-04 added gerbs ferarrii
    [Ferrarii.kicad_pcb]
2025-08-04 okay second try gerbs ferarrii
    [Ferrarii.kicad_pcb]
2025-08-04 okay 3rd tiems a charm ferarrii gerbs
    [Ferrarii.kicad_pcb]
2025-08-21 custom ml2 gerbers generated
    [CustomML2-B_Cu.gbl, CustomML2-B_Mask.gbs, CustomML2-B_Paste.gbp, CustomML2-B_Silkscreen.gbo, CustomML2-Edge_Cuts.gm1, CustomML2-F_Cu.gtl, CustomML2-F_Mask.gts, CustomML2-F_Paste.gtp]
2025-09-04 giovanni motor test code
2025-10-02 added slippi
    [1101M2S3CQE2.step, DRV8871DDAR.step, L7805CV.step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]
2025-10-02 replaced slippi
    [Slippi-B_Cu.gbr, Slippi-B_Mask.gbr, Slippi-B_Paste.gbr, Slippi-B_Silkscreen.gbr, Slippi-Edge_Cuts.gbr, Slippi-F_Cu.gbr, Slippi-F_Mask.gbr, Slippi-F_Paste.gbr]
2025-10-02 added everything??
    [1101M2S3CQE2.step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]
2026-01-19 Temporarii PCB version 2
    Second Iteration of Temporarii's pcb design with more features; sensor leds, dip switch, imu, new design
2026-07-23 NewMemberBoard v1
    [1101M2S3CQE2.step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]
2026-07-24 added tantalum capacitors
    [500gNewMemberBoard-B_Cu.gbr, 500gNewMemberBoard-B_Mask.gbr, 500gNewMemberBoard-B_Paste.gbr, 500gNewMemberBoard-B_Silkscreen.gbr, 500gNewMemberBoard-Edge_Cuts.gbr, 500gNewMemberBoard-F_Cu.gbr, 500gNewMemberBoard-F_Mask.gbr, 500gNewMemberBoard-F_Paste.gbr]
2026-07-30 fixed USBC, updated BOM
    [500gNewMemberBoard.kicad_pcb, 500gNewMemberBoard.kicad_sch, bom.csv, designators.csv, positions.csv]
